JakCrane/FYP/Research_Files/October/current_feed_systems.md

deliverable for week 44



load cell to calculate feedrate which isnt possible in 0g
dont understand how exactly it works

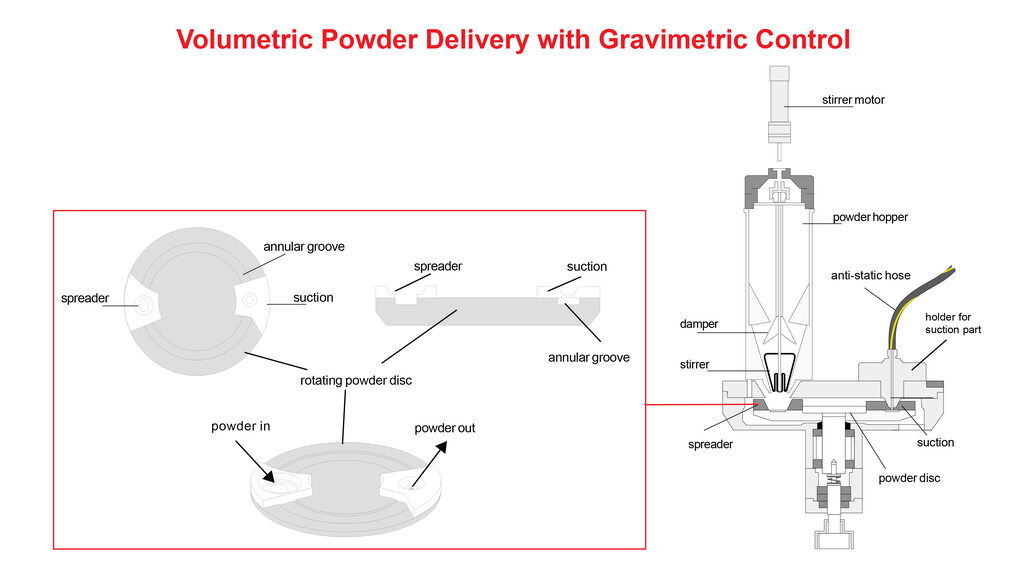
[picture p61: Research_Files/October/Volumetric_oerlikon.jpg]


requires gravity for the powder to sit in annular groove

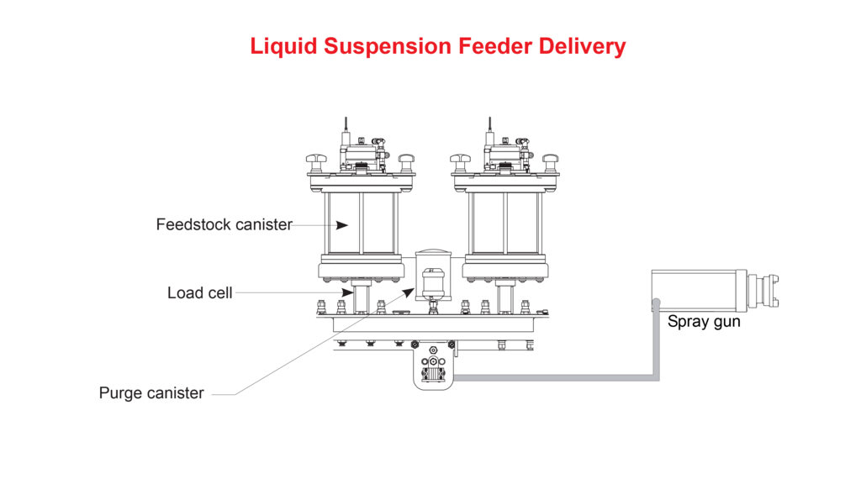
[picture p62: Research_Files/October/Liquid_oerlikon.jpg]


dont want to use liquid as it will increase mass to orbit



assuming smooth movement of piston then would work. need to check particle size and if it was ever used

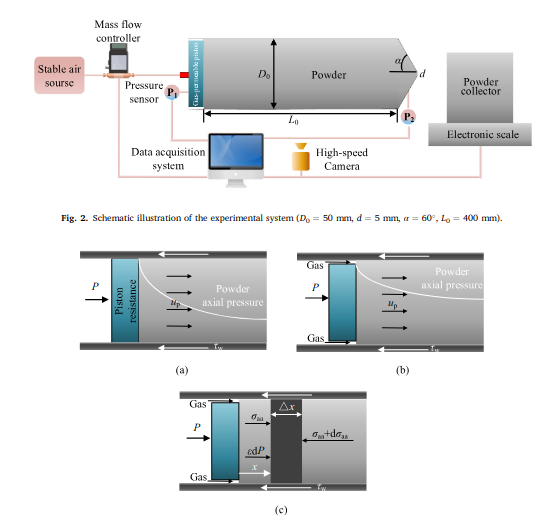
[picture p63: Research_Files/October/gas_permeable_piston.png]




would need some way to push the powder down but apparently is easy to control flow with control of speed of rotating screw



seems to be an intermediate between fluidised and screw/mechanical



generalised form of the oerlikon one



interesting concept but relies on gravity to work



more detailed
