JakCrane/FYP/latex/bin/main.tex

\documentclass[11pt,a4paper]{report}

\usepackage{titlesec}
\usepackage[utf8]{inputenc}
\usepackage{graphicx}
\usepackage{hyperref}
\usepackage{amsmath}
\usepackage{amsfonts}
\usepackage{amssymb}
\usepackage{geometry}
\usepackage{setspace}
\usepackage{subcaption}
\usepackage[font=footnotesize]{caption}
\usepackage{array}
\usepackage{listings}
\newcolumntype{P}[1]{>{\raggedright\arraybackslash}p{#1}}
\renewcommand{\theequation}{\arabic{equation}} % <--- Fix equation numbering!

\titlespacing*{\chapter}{0pt}{-30pt}{20pt} % Reduce space before chapter title
\titleformat{\chapter}[hang]
    {\normalfont\Huge\bfseries}
    {\thechapter\quad}
    {0pt}
    {}
    [\vspace{0ex}\noindent\rule{\textwidth}{0.4pt}] % Add line after chapter title

% Layout
\geometry{margin=1in}
\onehalfspacing{}
\begin{document}
\pagenumbering{roman} % Roman numerals for front matter
% Title Page
\begin{titlepage}

    \noindent
    \begin{minipage}{0.5\textwidth}
        
    \end{minipage}
    \hfill
    
    \vspace{1cm} % Space between logo and the title
    \begin{center}
        {\huge \textbf{Design and Optimisation of a Powder Feed System for In-Space Additive Manufacturing}}\\[1cm]
        
        \begin{minipage}{0.9\textwidth}
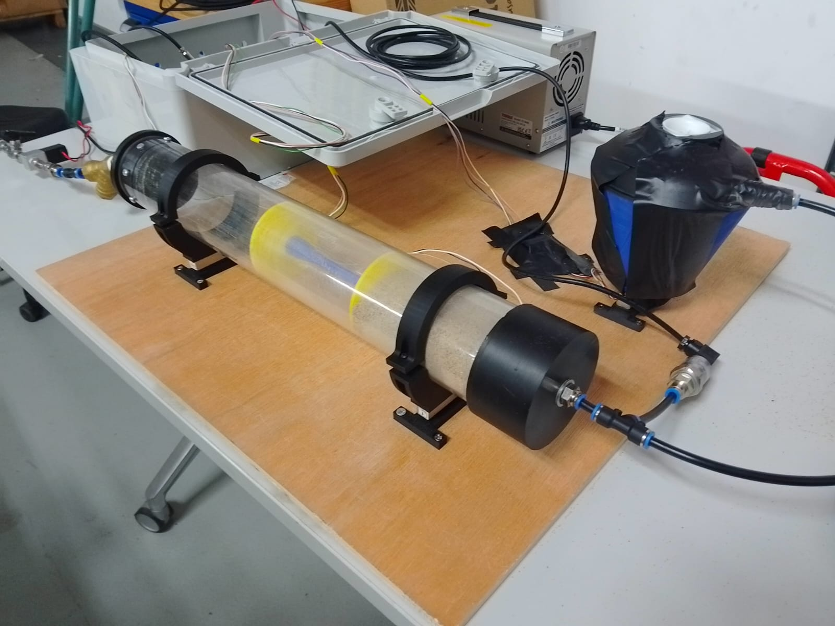
[picture p162: latex/report_assets/cover_image.png]
            
        \end{minipage}
        \hfill
        
        \vspace{0.3cm} % Space between logo and the title

        \begin{center}
            \renewcommand{\arraystretch}{1.5}
            \hfill\begin{tabular}{p{0.3\textwidth} p{0.6\textwidth}}
                \textbf{Author:}\hfill               & \textbf{Jack Crane} \\ 
                \textbf{Academic Supervisor:}\hfill  & Dr Ajit Panesar \\ 
                \textbf{Second Marker:}\hfill        & Dr Demetrios Venetsanos \\ 
                \textbf{Department:}\hfill           & Department of Aeronautics \\
                \textbf{Course:}\hfill               & MEng Aeronautics with Spacecraft Engineering \\
                \textbf{Academic Year:}\hfill        & 2024/2025 \\
                \textbf{Date:}\hfill                 & \today \\
            \end{tabular}
        \end{center}
        
        \vspace{0.5cm} % Space between logo and the title
        A Thesis submitted in fulfillment of requirements for the degree of \\
        Master of Engineering in Aeronautics with Spacecraft Engineering
    \end{center}
\end{titlepage}

% Abstract
\begin{abstract}
\input{../abstract.tex}
\end{abstract}

% Acknowledgments
\chapter*{Acknowledgments}
\input{../acknowledgments.tex}

% Table of Contents
\tableofcontents
\listoffigures
\listoftables

\newpage

\clearpage
\pagenumbering{arabic}

% Chapters
\chapter{Introduction and Context}
\input{../introduction.tex}

\chapter{Academic Background}
\input{../background.tex}

\chapter{Methodology}
\input{../methodology.tex}

\chapter{Results and Discussion}
\input{../results.tex}

\chapter{Conclusion and Future Work}
\input{../conclusion.tex}

% References
\newpage
\bibliographystyle{plain} % or use "unsrt" / "apalike" depending on your preference
\bibliography{../references} % assumes you have a references.bib BibTeX file

\appendix
\input{../appendix.tex}

\end{document}
