JakCrane/FYP/latex/report_assets/COSMOS MS2.pdf

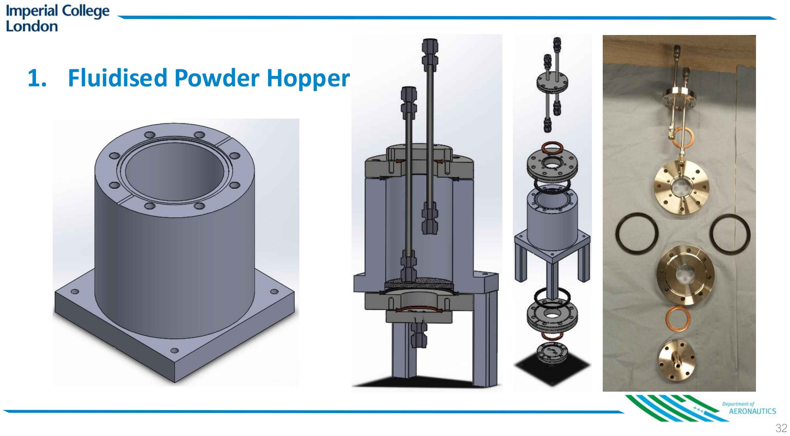
[picture p163: page 1]
