JakCrane/FYP/latex/report_assets/60mm_no_grav_2.png

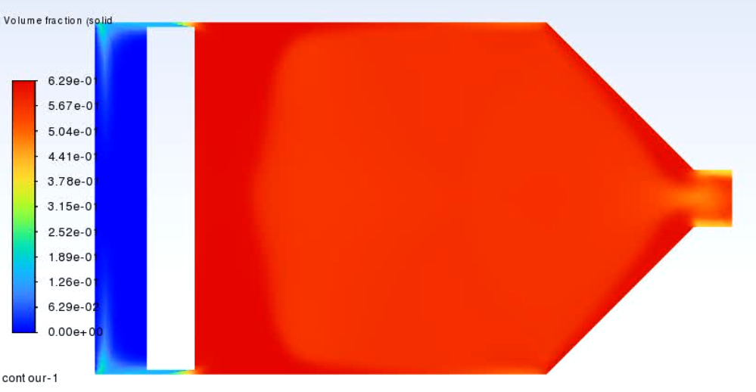
latex/report_assets/60mm_no_grav_2.png
