JakCrane/FYP/latex/report_assets/60mm_no_grav_3.png

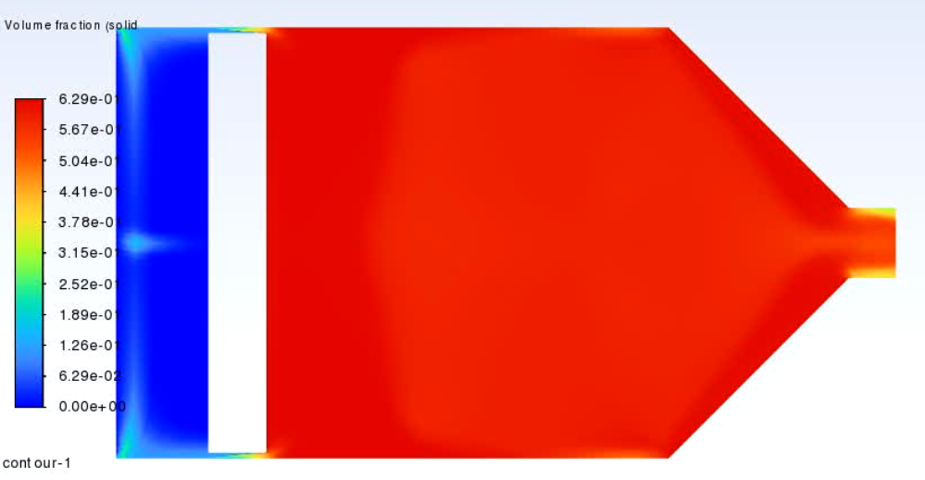
latex/report_assets/60mm_no_grav_3.png
