JakCrane/FYP/latex/report_assets/62_clean_flow_100.png

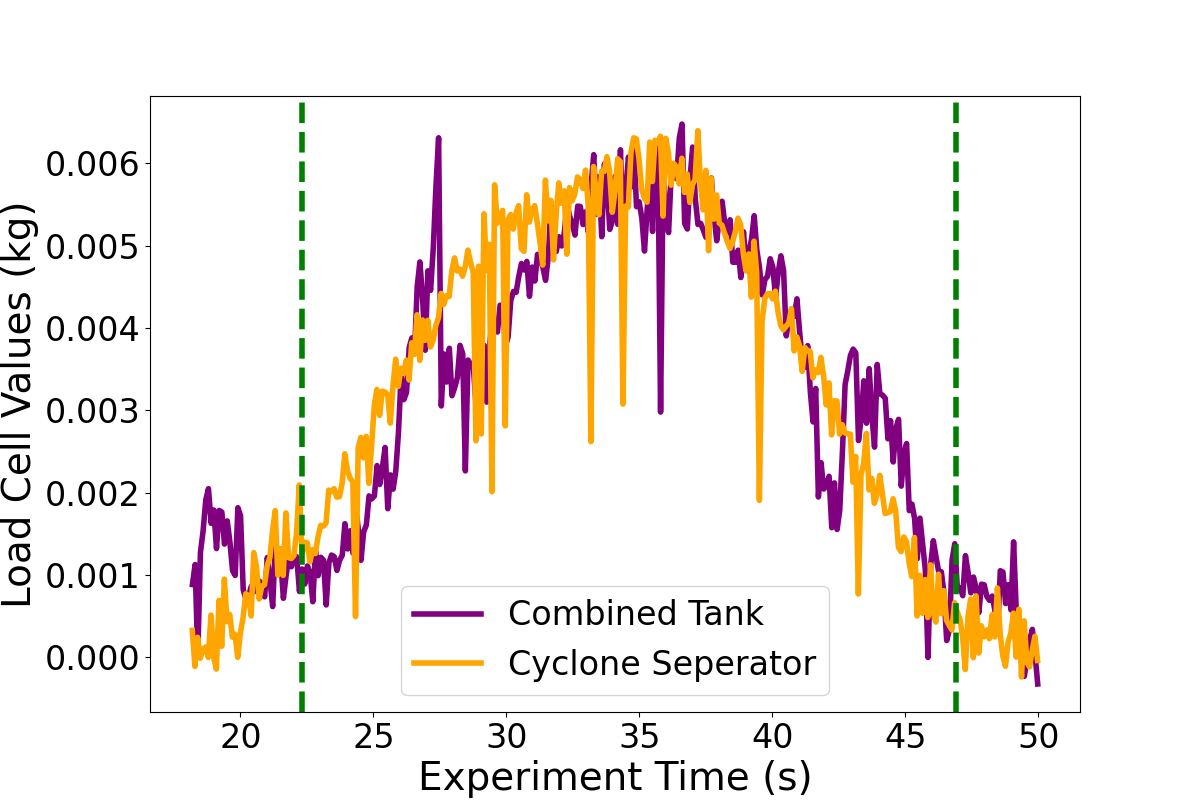
latex/report_assets/62_clean_flow_100.png
