JakCrane/FYP/latex/report_assets/62_clean_mass.png

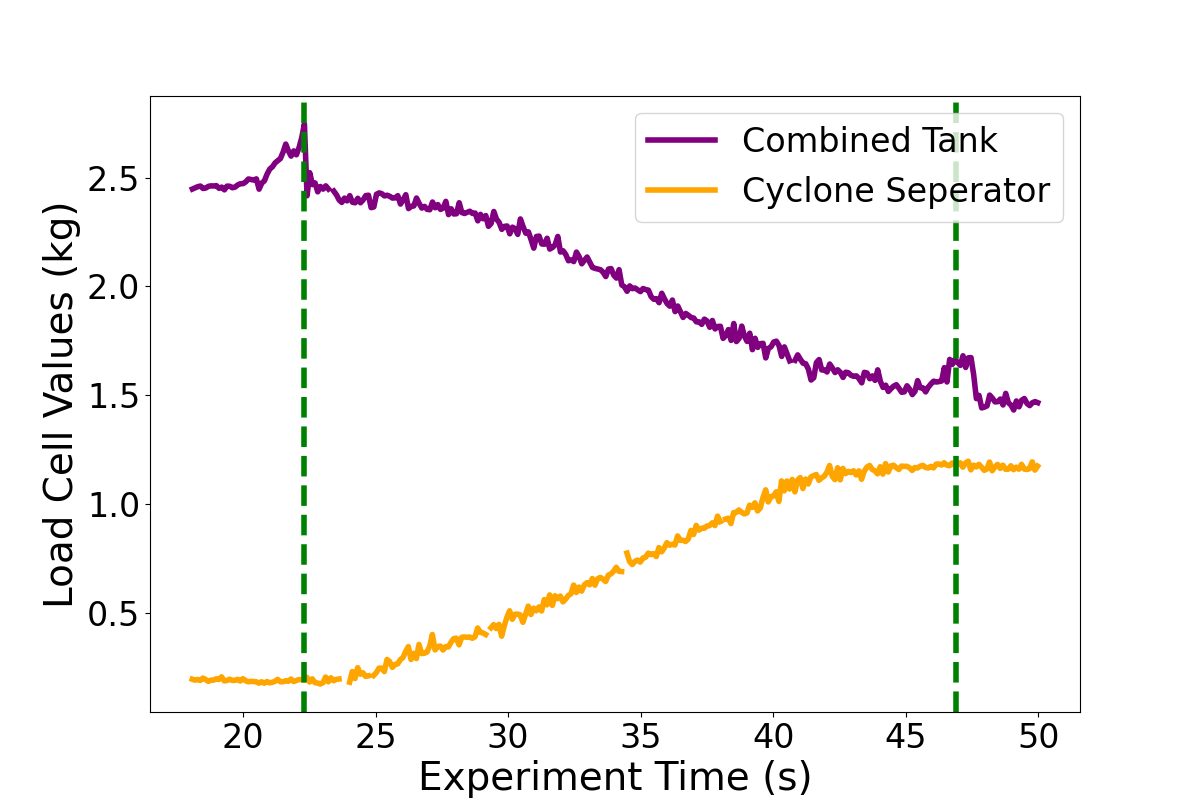
latex/report_assets/62_clean_mass.png
