JakCrane/FYP/latex/report_assets/62_raw_mass.png

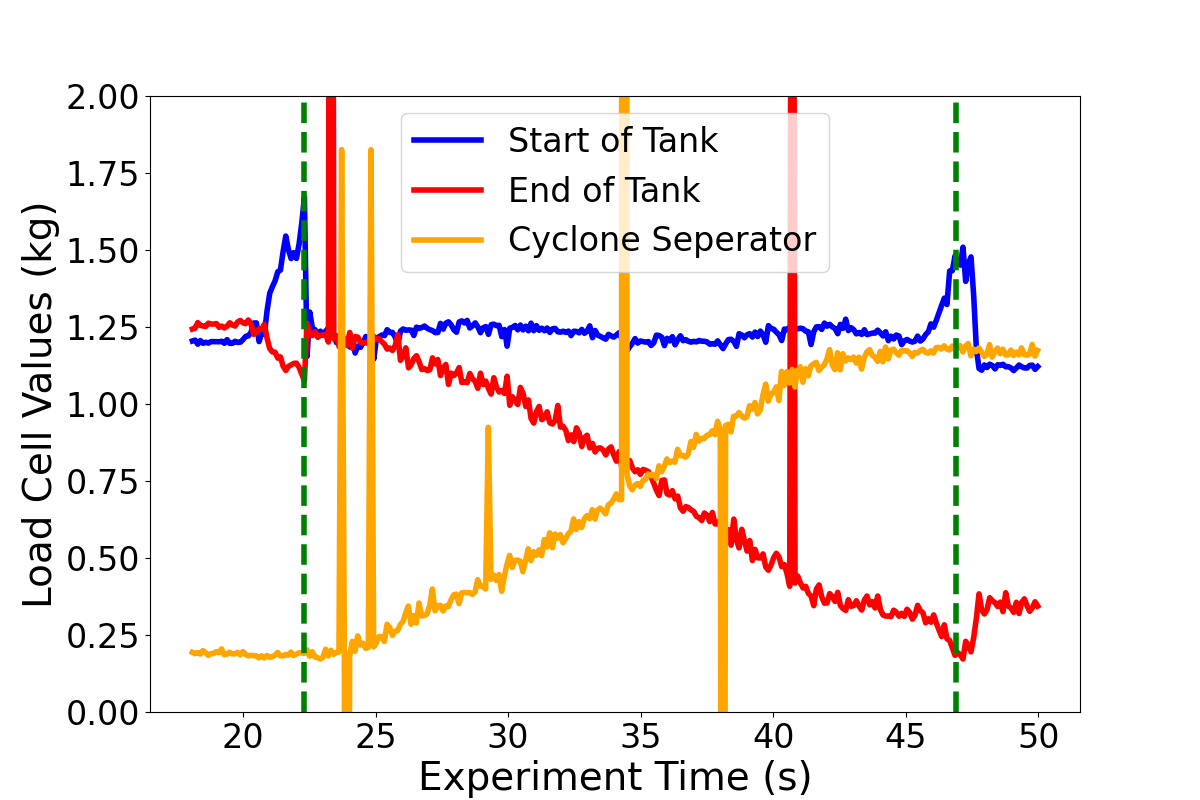
latex/report_assets/62_raw_mass.png
