JakCrane/FYP/latex/report_assets/controllability_py_raw.png

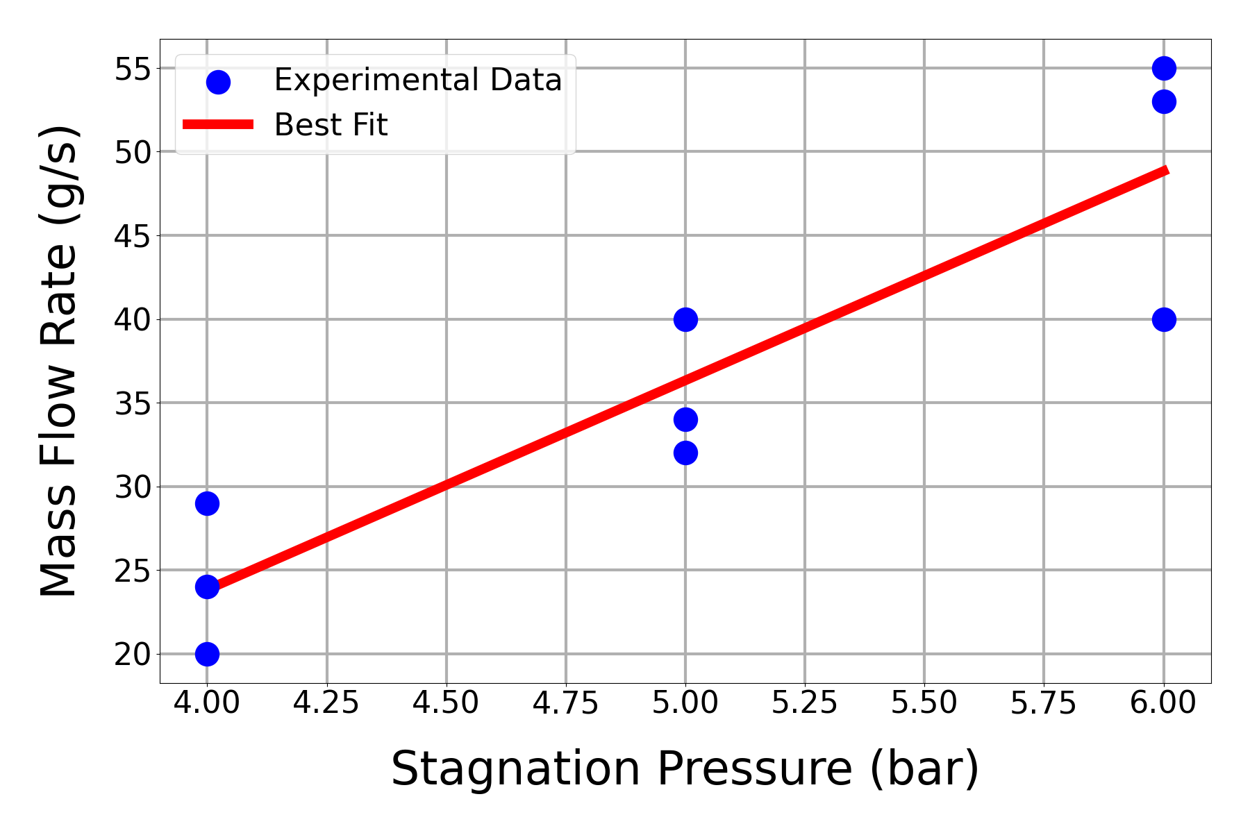
latex/report_assets/controllability_py_raw.png
