JakCrane/FYP/latex/report_assets/cs_impact.png

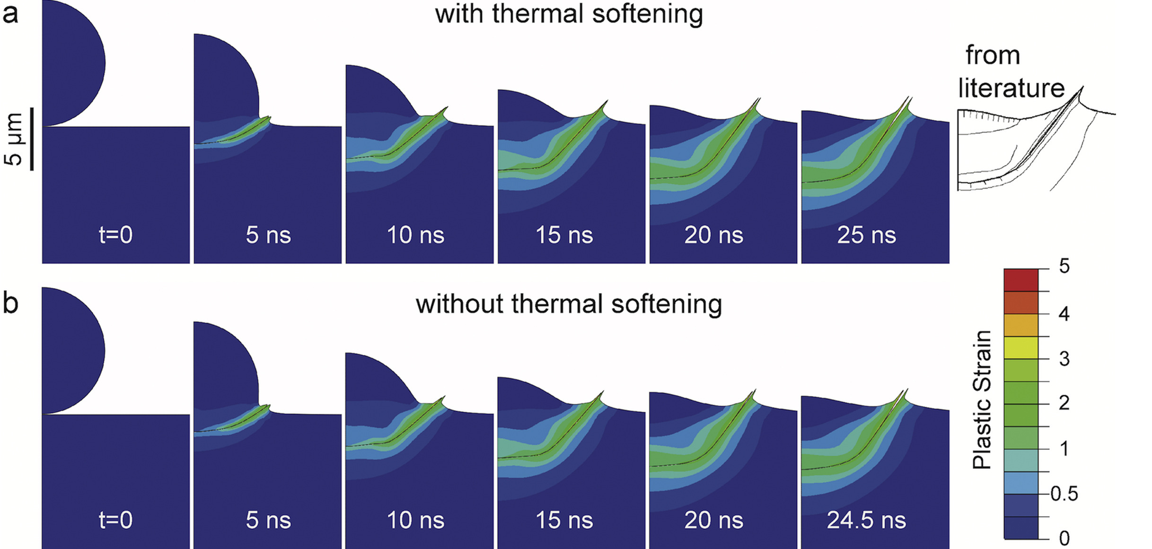
latex/report_assets/cs_impact.png
