JakCrane/FYP/latex/report_assets/cs_porosity.png

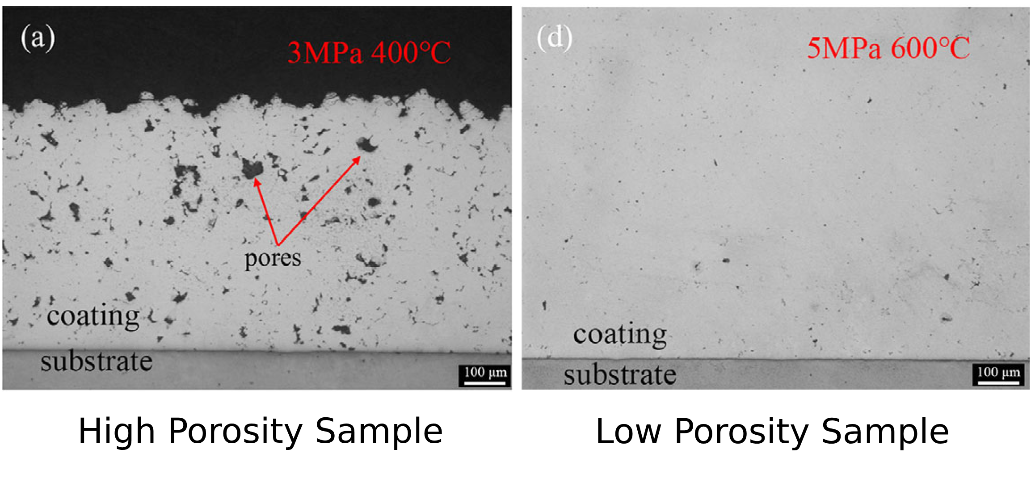
latex/report_assets/cs_porosity.png
