JakCrane/FYP/latex/report_assets/cyclone_diagram_wide.png

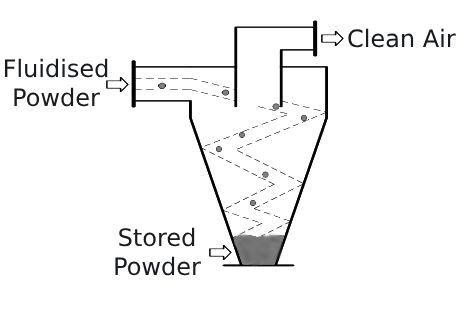
latex/report_assets/cyclone_diagram_wide.png
