JakCrane/FYP/latex/report_assets/des_evo_2.png

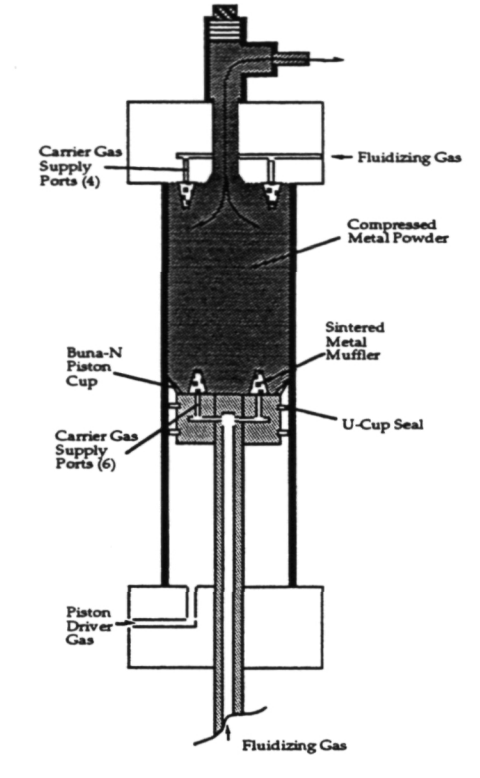
latex/report_assets/des_evo_2.png
