JakCrane/FYP/latex/report_assets/des_evo_4.png

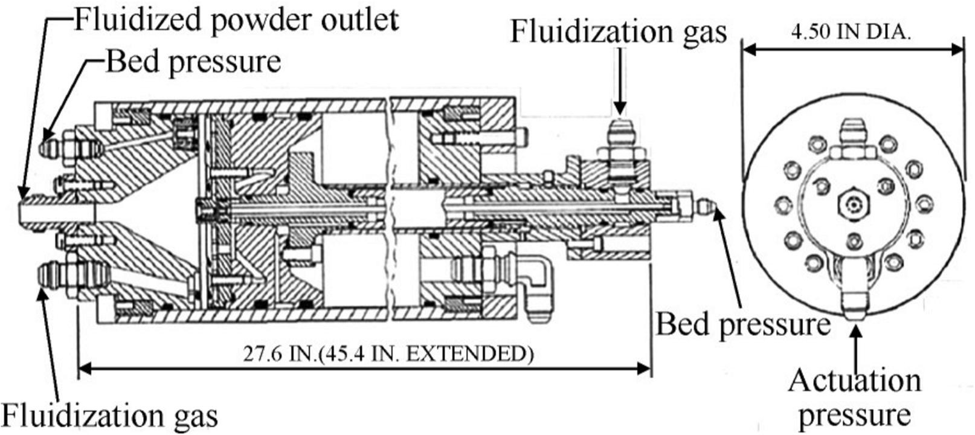
latex/report_assets/des_evo_4.png
