JakCrane/FYP/latex/report_assets/diaphragm_tank.png

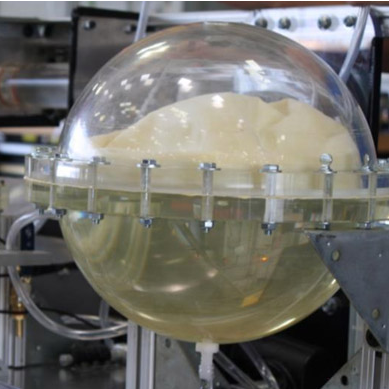
latex/report_assets/diaphragm_tank.png
