JakCrane/FYP/latex/report_assets/fluent_sucks.png

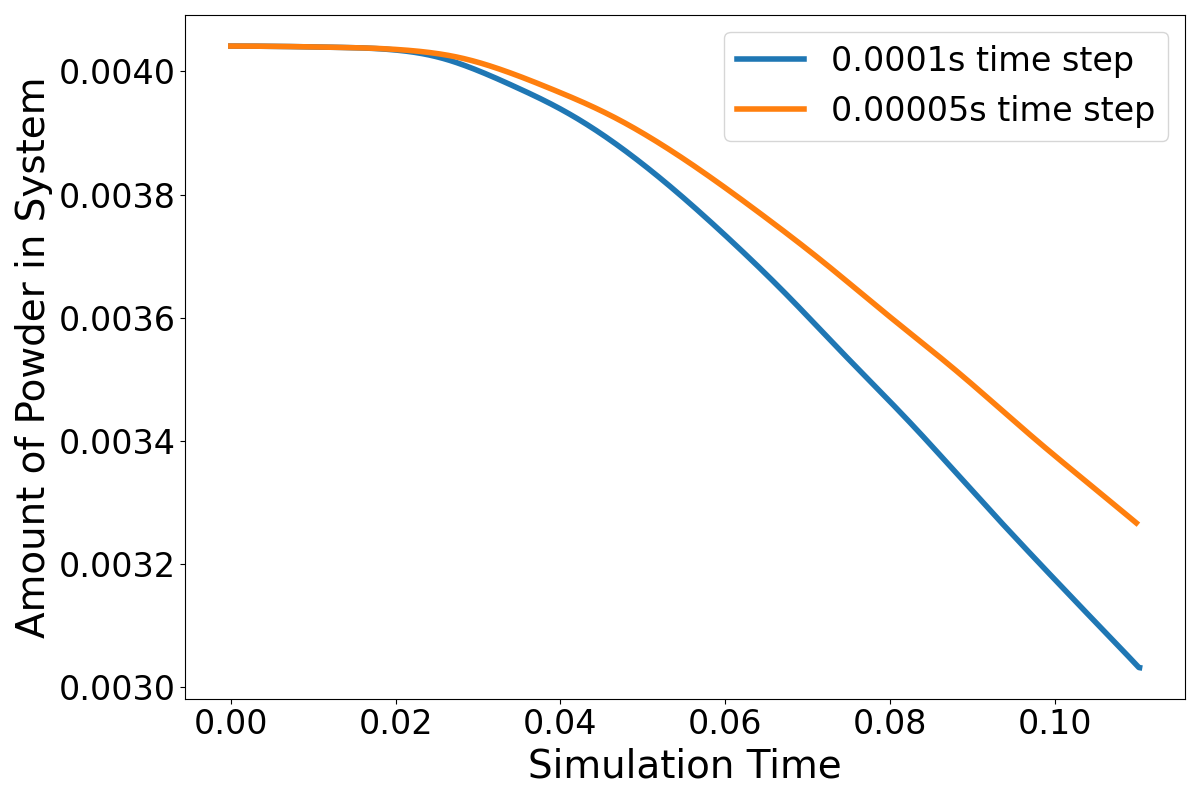
latex/report_assets/fluent_sucks.png
