JakCrane/FYP/latex/report_assets/Fluidised_Bed.jpg

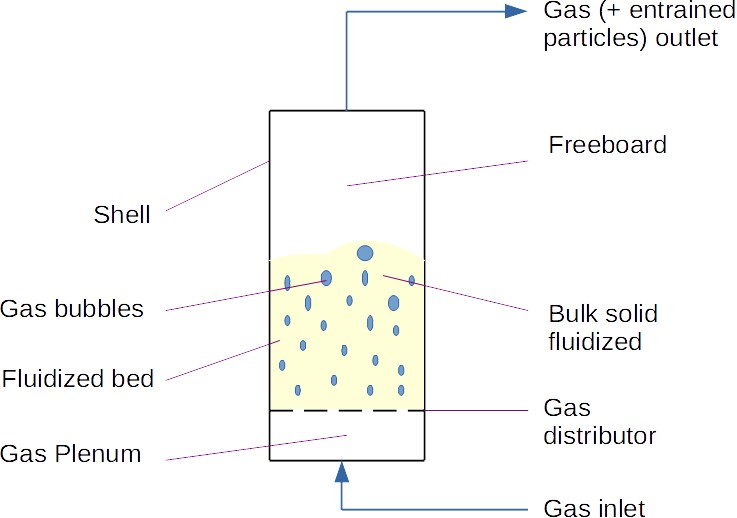
latex/report_assets/Fluidised_Bed.jpg
