JakCrane/FYP/latex/report_assets/Screenshot 2025-05-29 164737.png

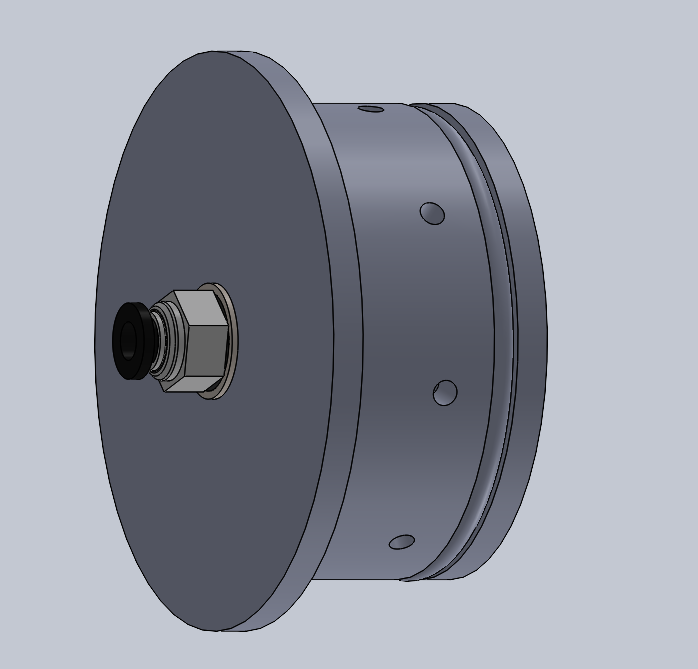
latex/report_assets/Screenshot 2025-05-29 164737.png
