JakCrane/FYP/latex/report_assets/Screenshot 2025-05-29 165220.png

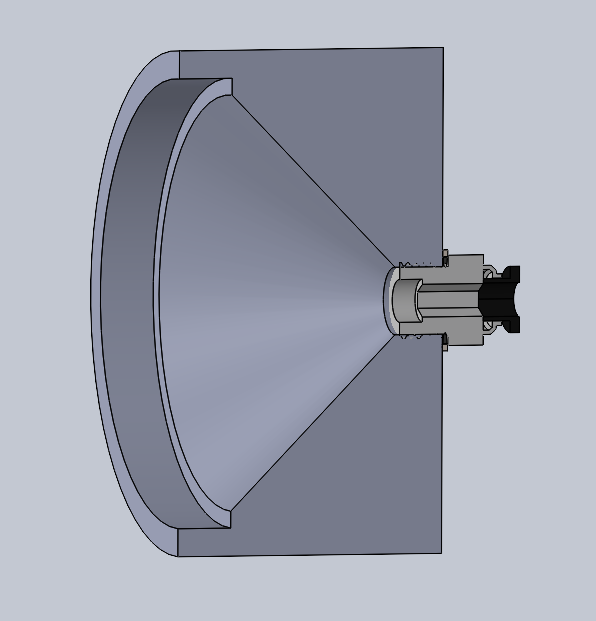
latex/report_assets/Screenshot 2025-05-29 165220.png
