JakCrane/FYP/latex/report_assets/systems_diagram.png

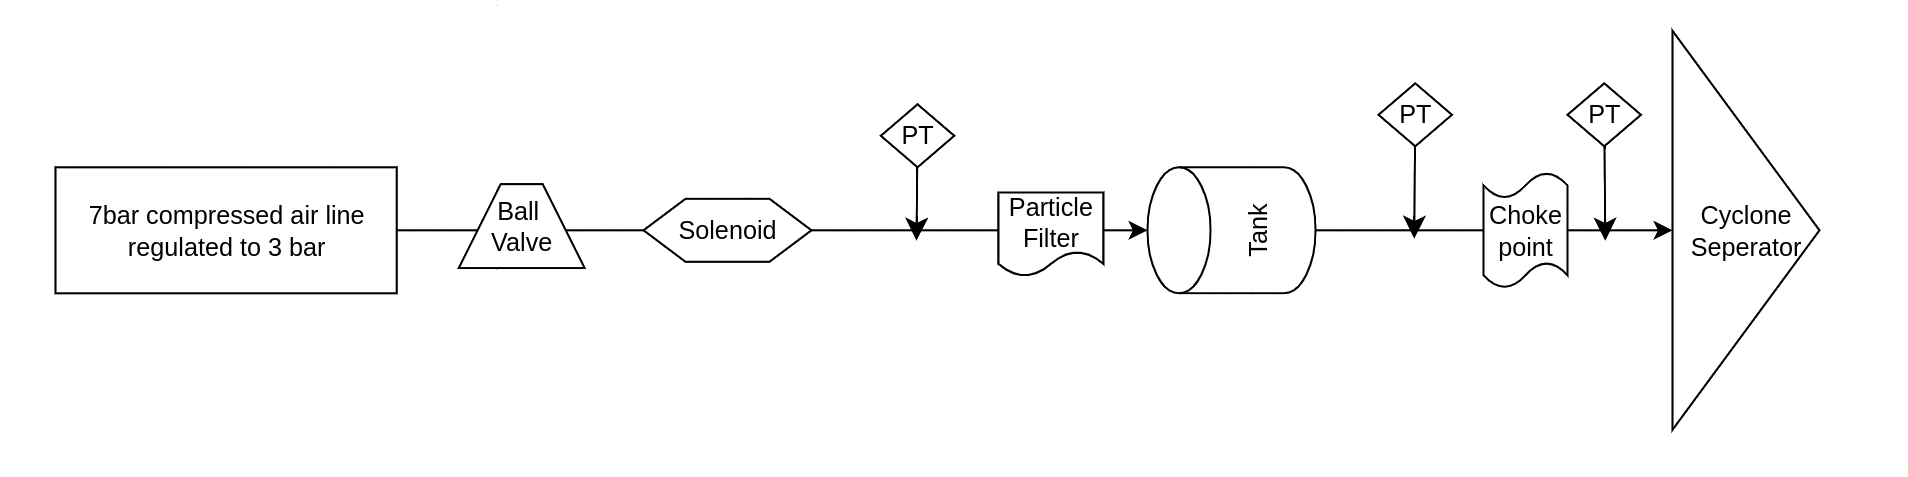
latex/report_assets/systems_diagram.png
