JakCrane/FYP/latex/report_assets/table_of_analysis_1.png

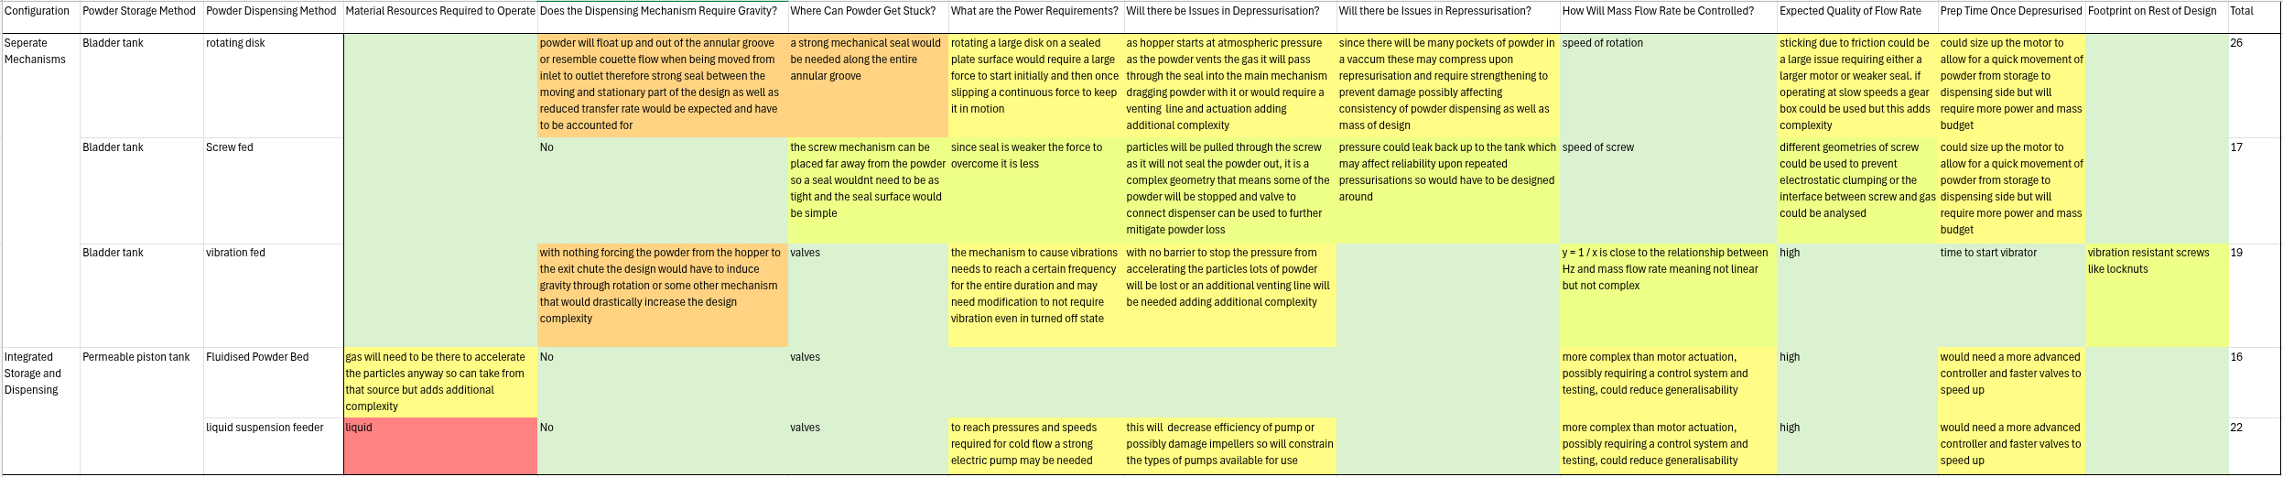
latex/report_assets/table_of_analysis_1.png
