JakCrane/FYP/Research_Files/April/16_holes_offset_3mm.png

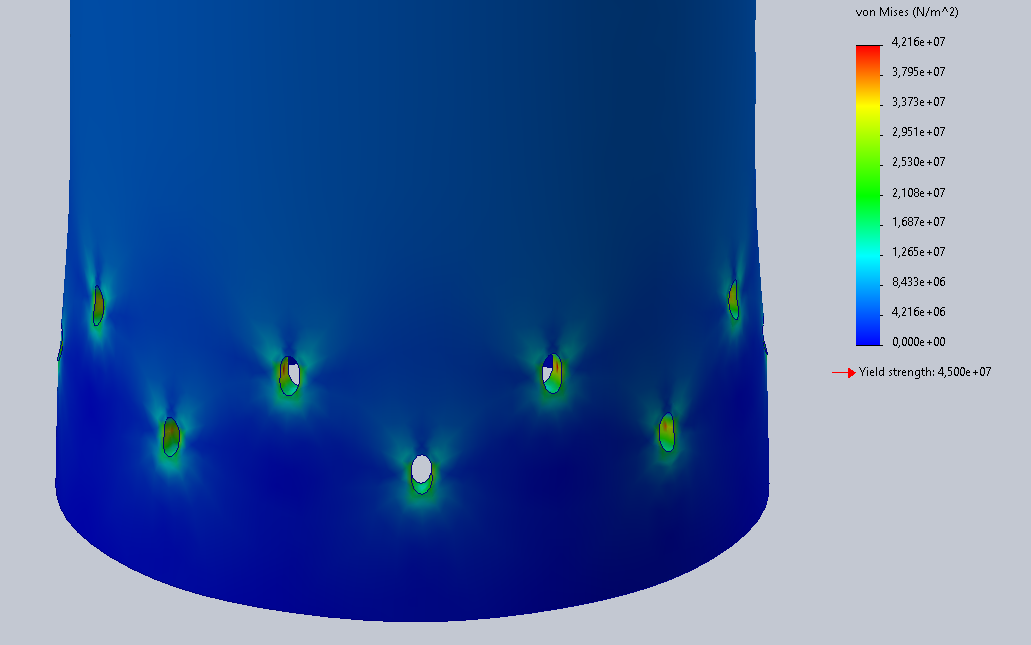
Research_Files/April/16_holes_offset_3mm.png
