JakCrane/FYP/Research_Files/February/20210629_205828.jpg

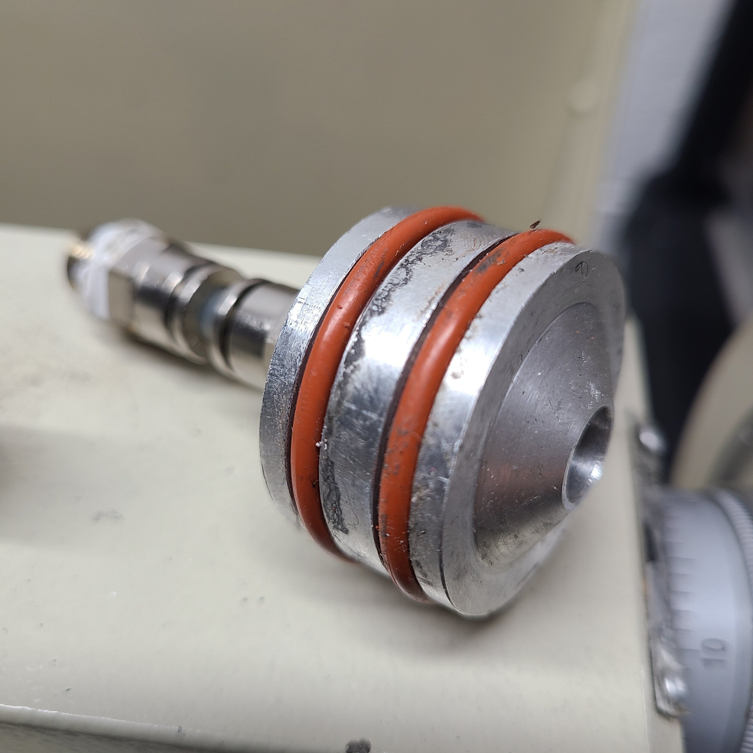
Research_Files/February/20210629_205828.jpg
