JakCrane/FYP/Research_Files/February/acrylic_tube_4mm_sim.png

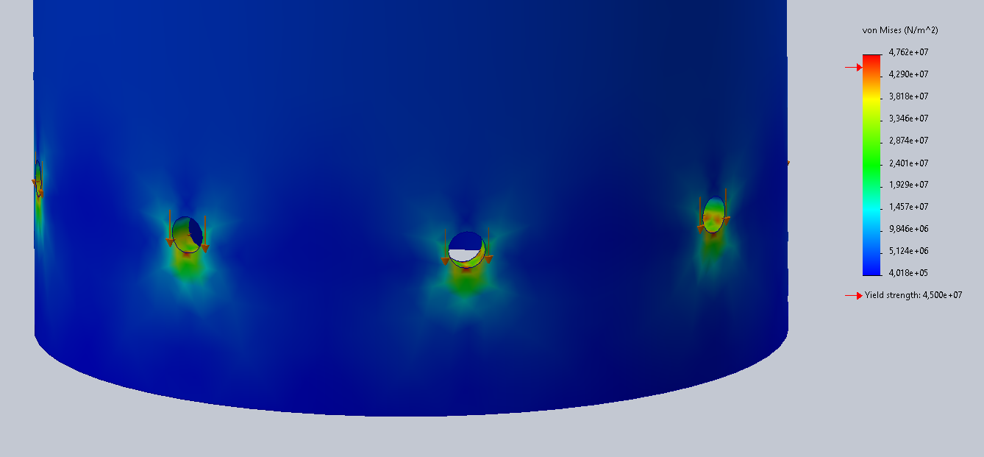
Research_Files/February/acrylic_tube_4mm_sim.png
