JakCrane/FYP/Research_Files/February/acrylic_tube_6mm_sim.png

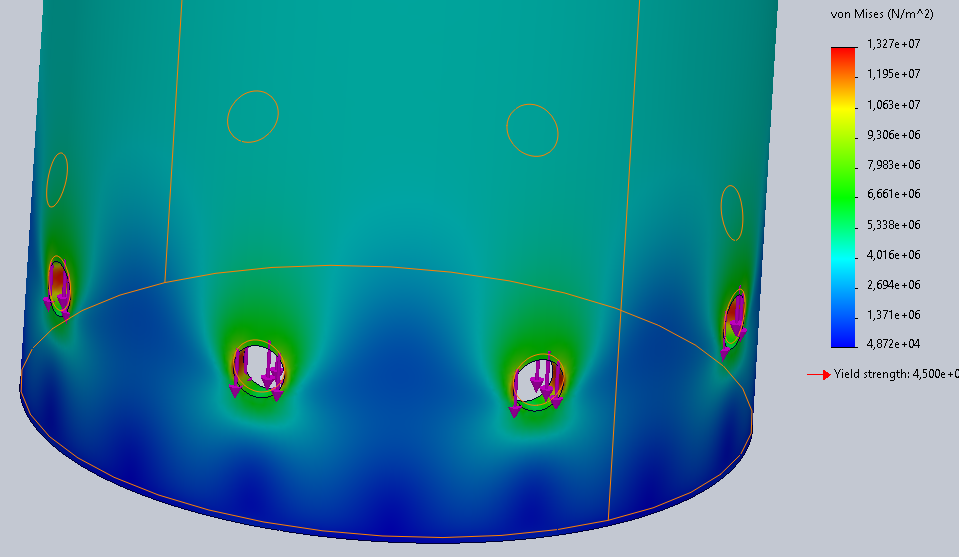
Research_Files/February/acrylic_tube_6mm_sim.png
