JakCrane/FYP/Research_Files/February/delrin_end_cap_sim.png

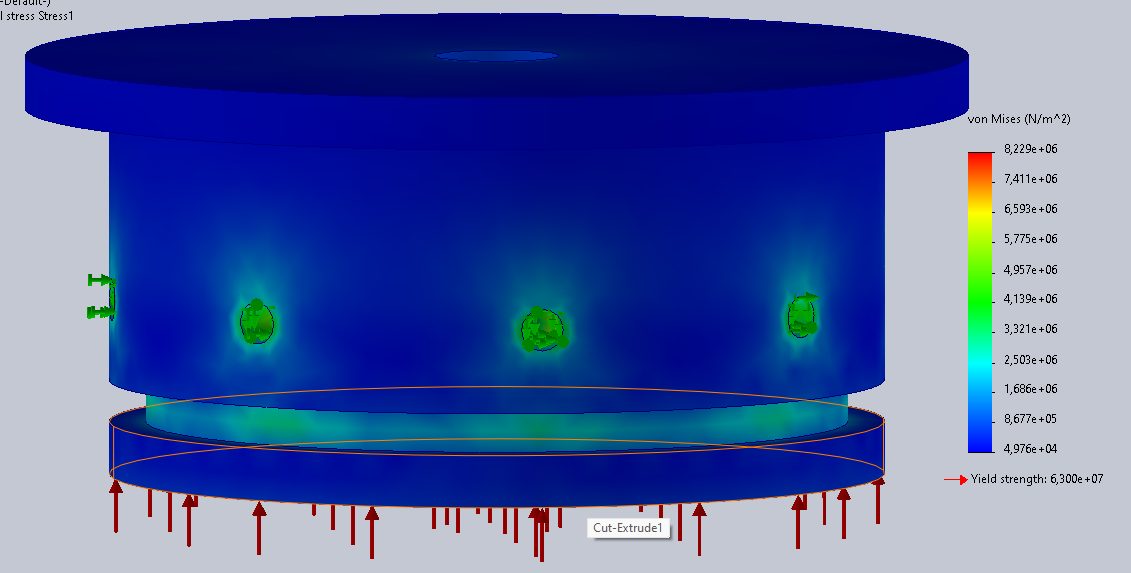
Research_Files/February/delrin_end_cap_sim.png
