JakCrane/FYP/Research_Files/February/tot_pres_5_to_4p8_bar.png

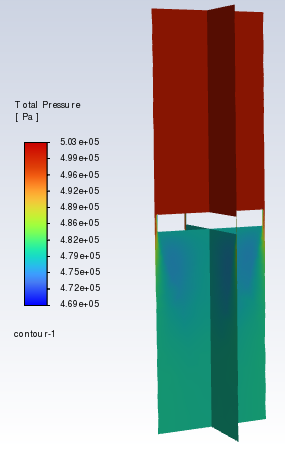
Research_Files/February/tot_pres_5_to_4p8_bar.png
