JakCrane/FYP/Research_Files/February/tot_pres_5_to_4p9_bar_1.png

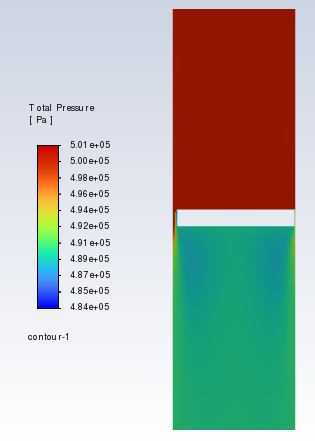
Research_Files/February/tot_pres_5_to_4p9_bar_1.png
