JakCrane/FYP/Research_Files/January/configuration_that_demands_pms.png

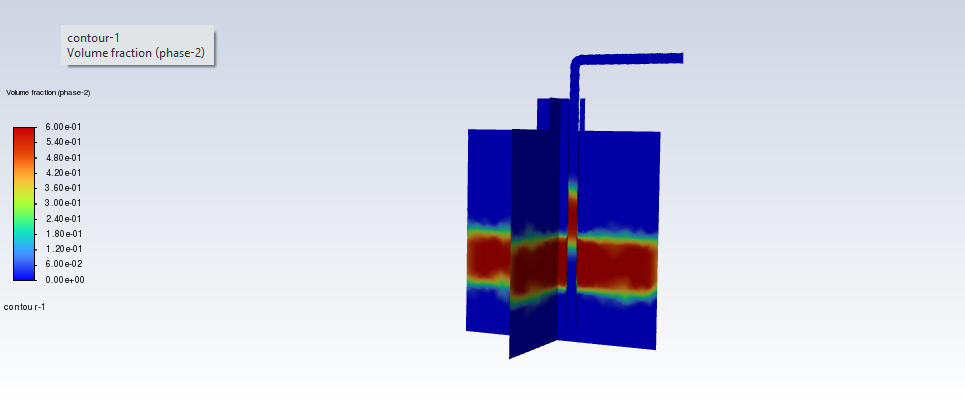
Research_Files/January/configuration_that_demands_pms.png
