JakCrane/FYP/Research_Files/March/1580247095994.gif

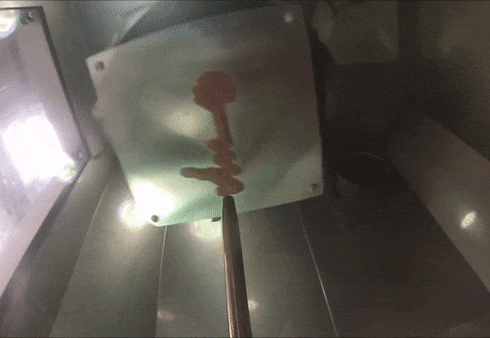
Research_Files/March/1580247095994.gif
