JakCrane/FYP/Research_Files/March/fea_on_acrylic.webp

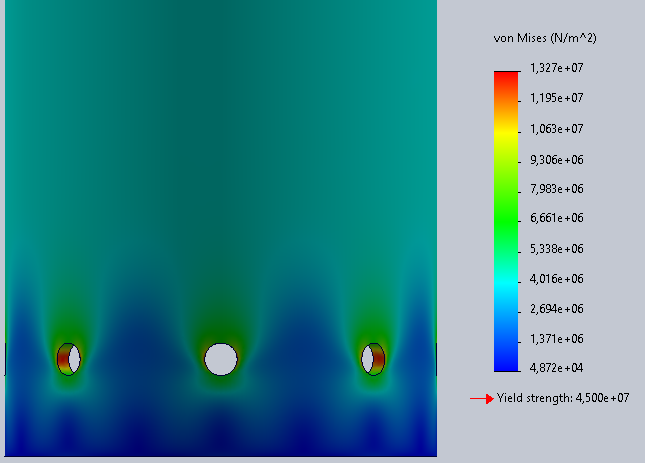
Research_Files/March/fea_on_acrylic.webp
