JakCrane/FYP/Research_Files/March/presentation_pandid.webp

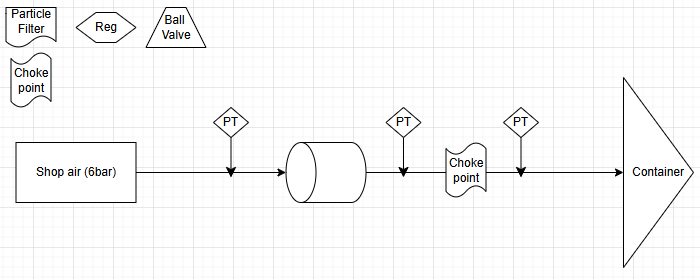
Research_Files/March/presentation_pandid.webp
