JakCrane/FYP/Research_Files/May/comparison_mass_change_vs_flow_time.png

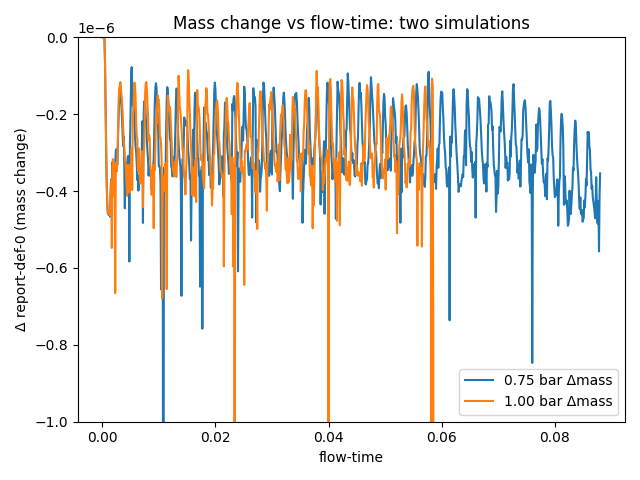
Research_Files/May/comparison_mass_change_vs_flow_time.png
