JakCrane/FYP/Research_Files/May/vel_profile_w_3bar_inlet.png

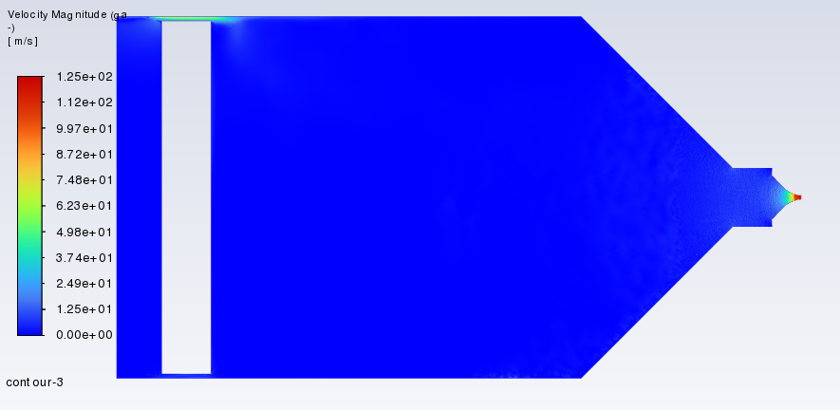
Research_Files/May/vel_profile_w_3bar_inlet.png
