JakCrane/FYP/Research_Files/November/Starccm_images/Capture4.PNG

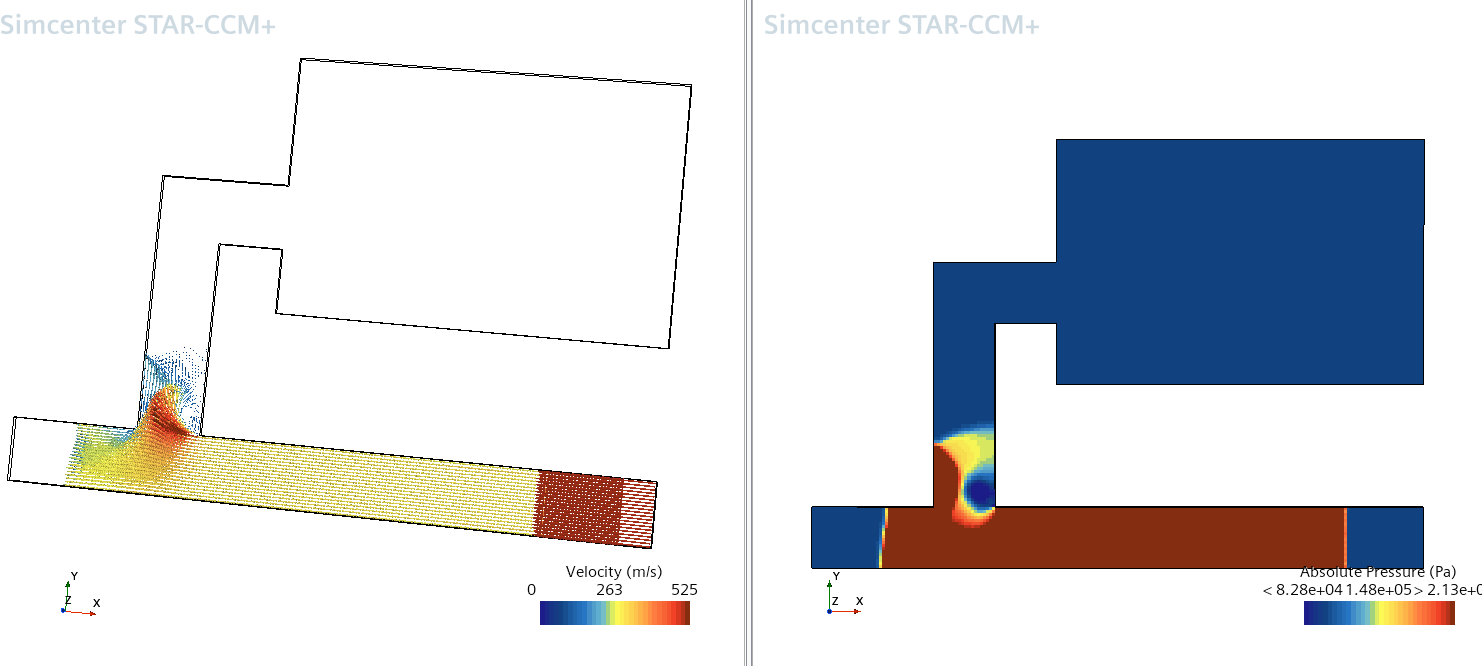
Research_Files/November/Starccm_images/Capture4.PNG
