JakCrane/FYP/Research_Files/November/Starccm_images/Capture7.PNG

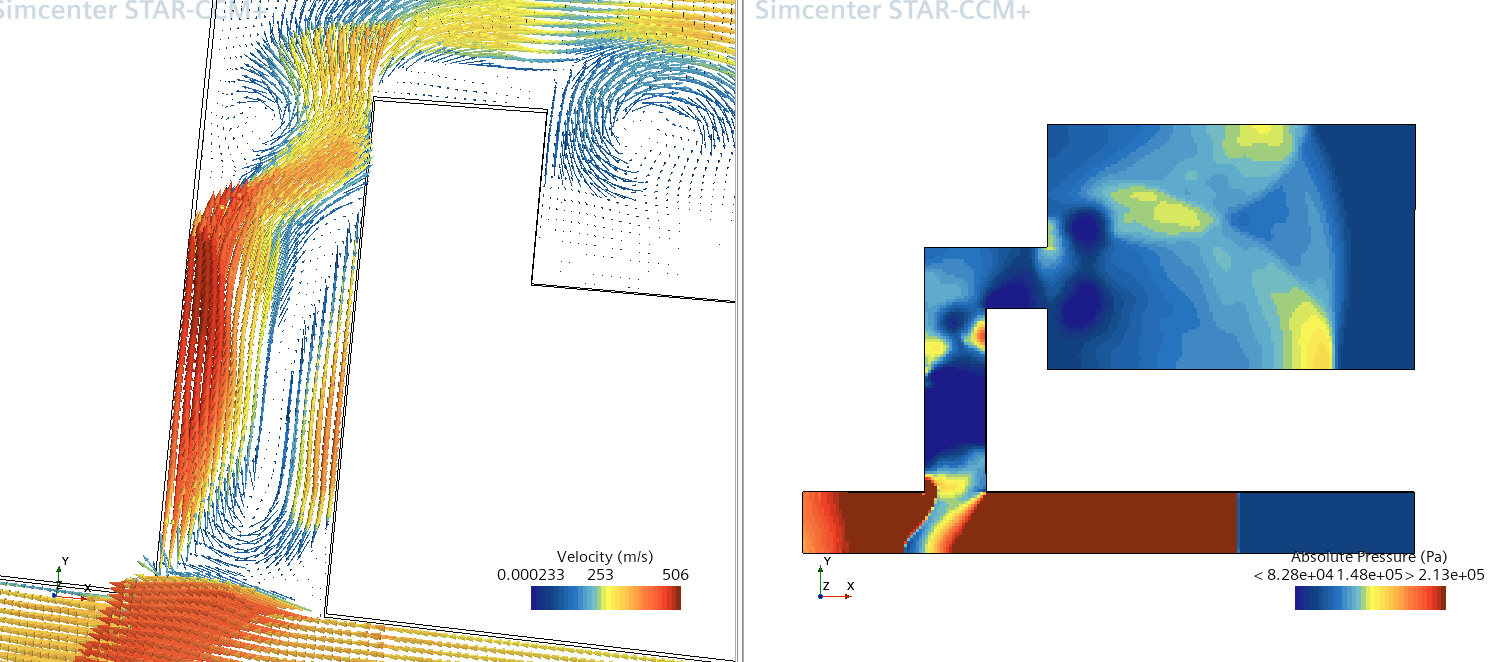
Research_Files/November/Starccm_images/Capture7.PNG
