JakCrane/FYP/Research_Files/November/Starccm_images/Capture8.PNG

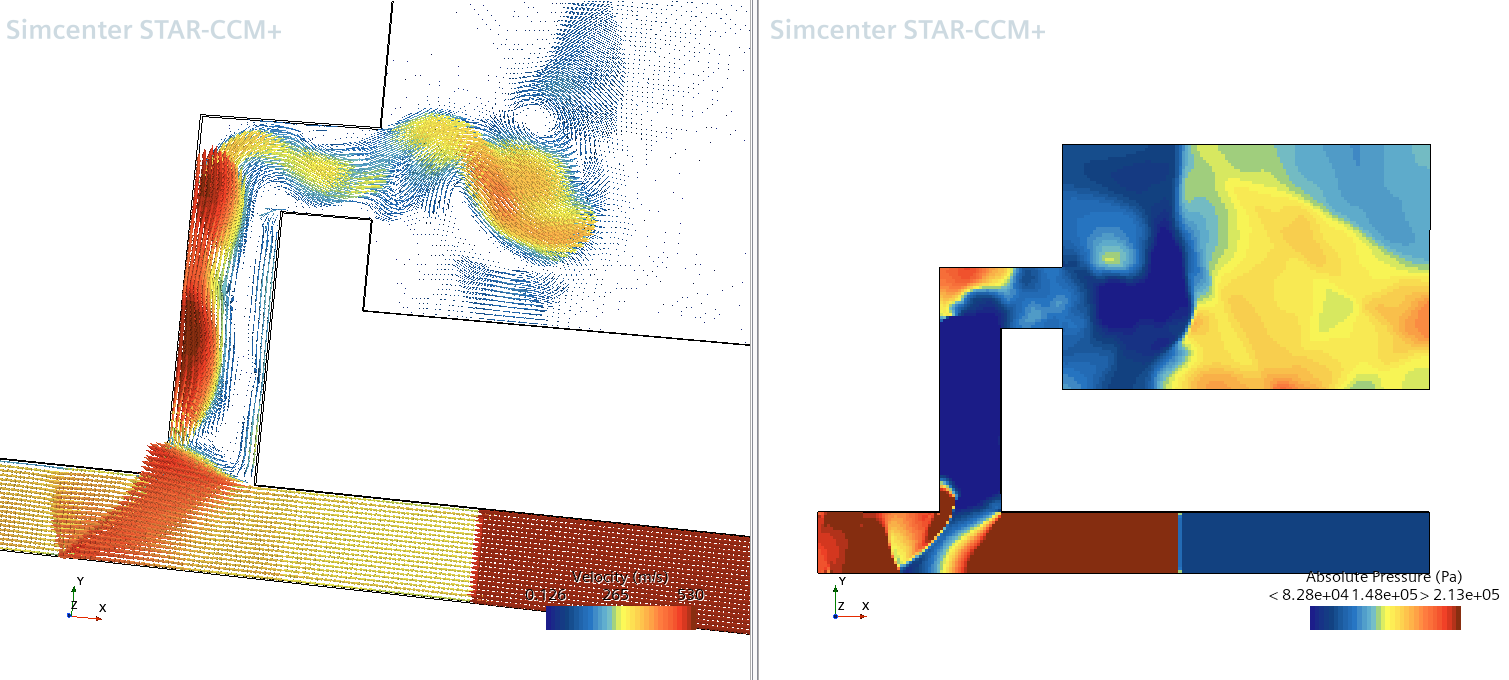
Research_Files/November/Starccm_images/Capture8.PNG
