JakCrane/FYP/Research_Files/November/Starccm_images/Capture9.PNG

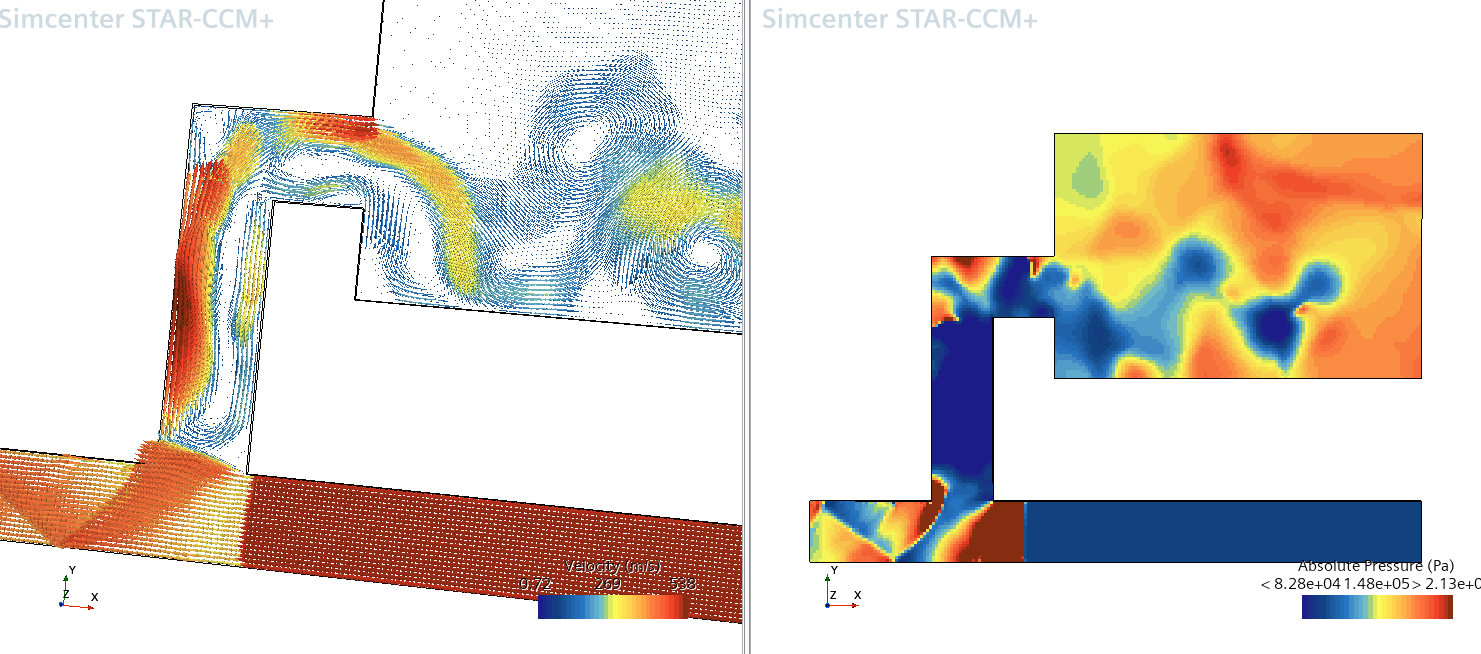
Research_Files/November/Starccm_images/Capture9.PNG
