JakCrane/FYP/Research_Files/November/Starccm_images/Capture10.PNG

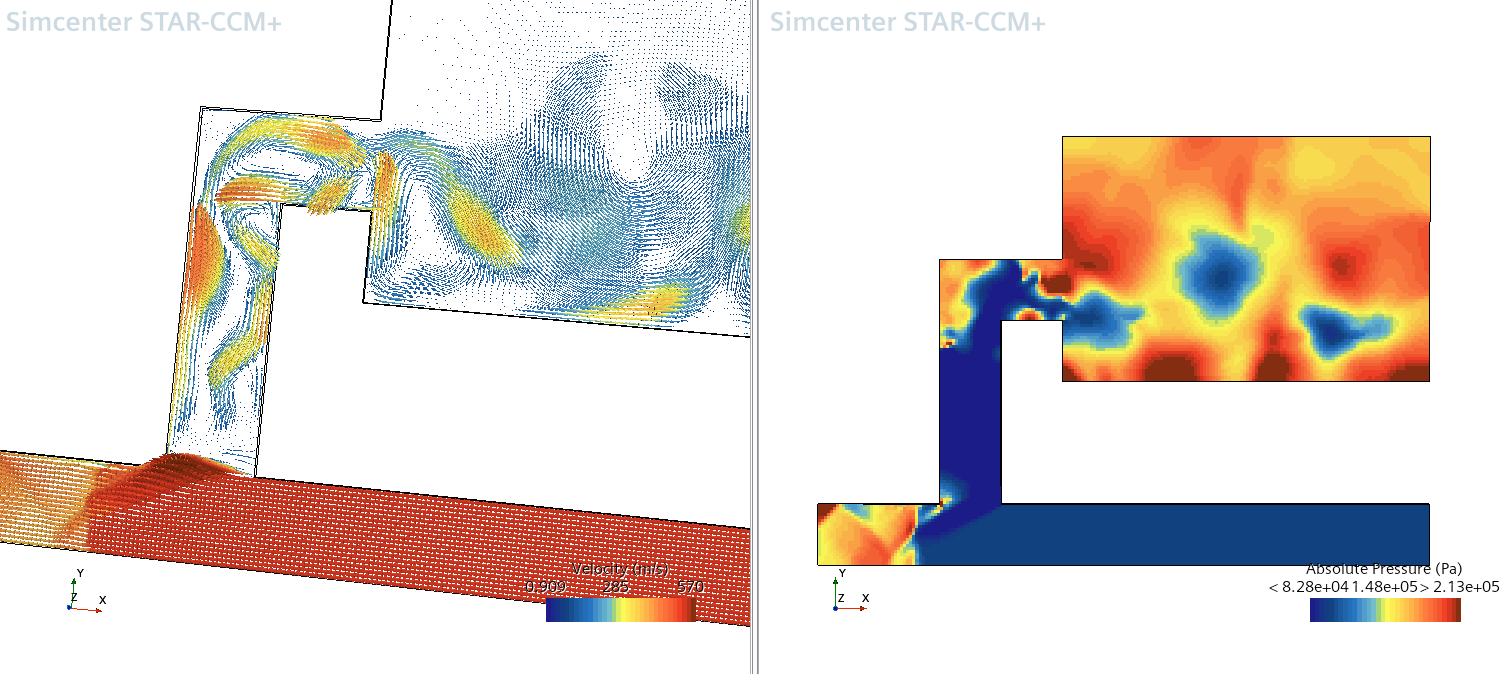
Research_Files/November/Starccm_images/Capture10.PNG
