JakCrane/FYP/Research_Files/November/Starccm_images/steady_state1.PNG

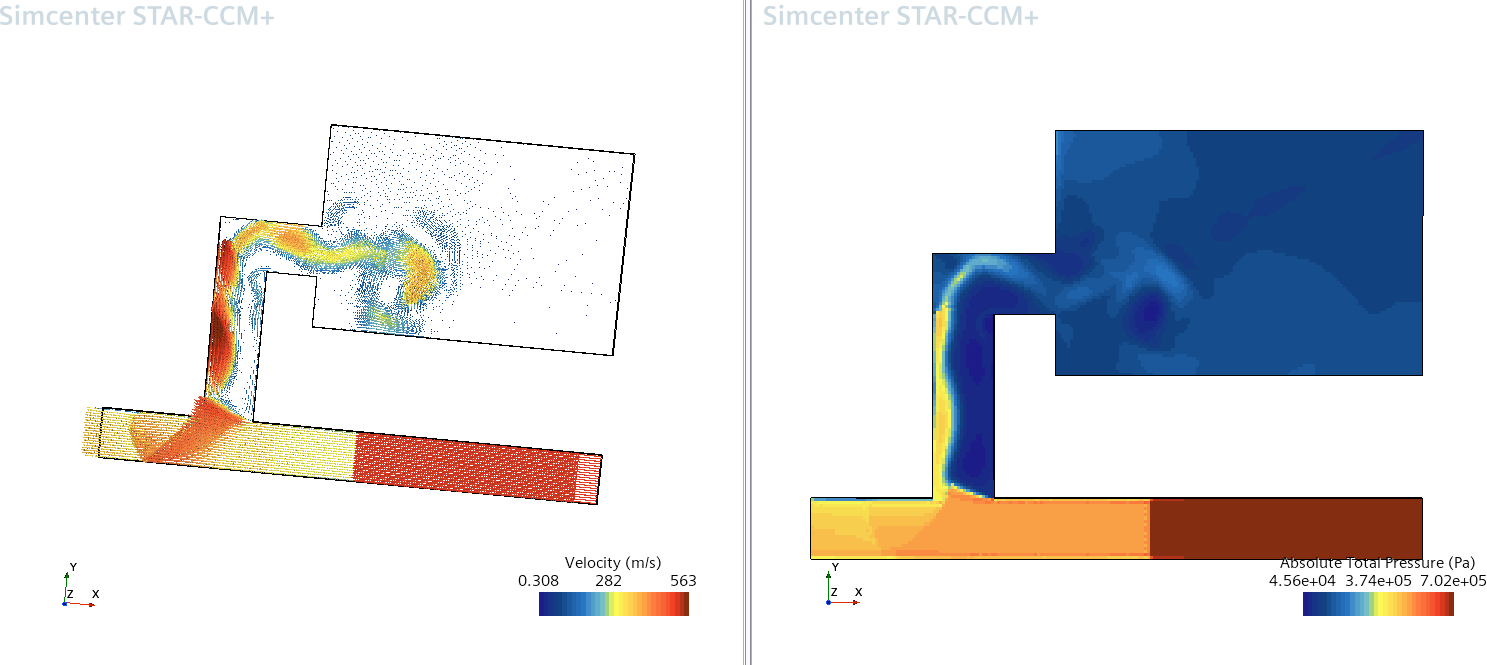
Research_Files/November/Starccm_images/steady_state1.PNG
