JakCrane/FYP/Research_Files/November/Starccm_images/steady_state2.PNG

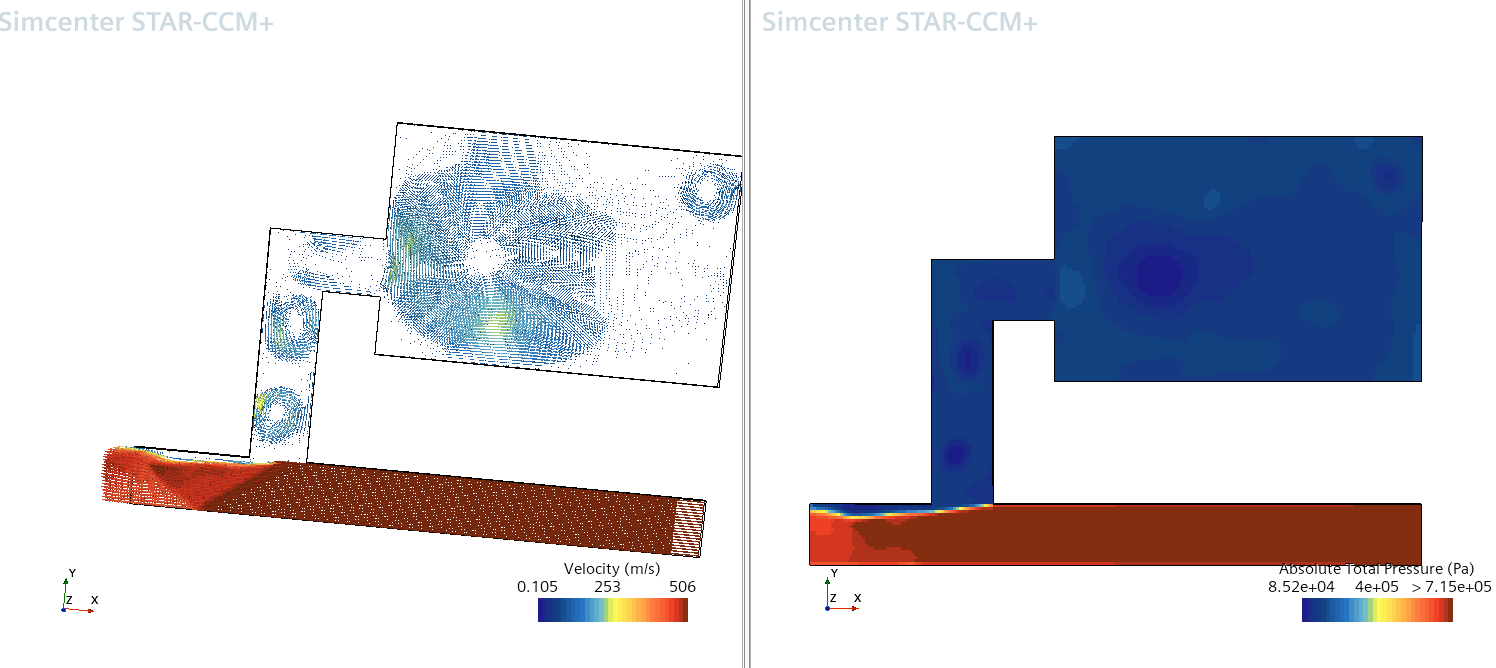
Research_Files/November/Starccm_images/steady_state2.PNG
