JakCrane/FYP/Research_Files/November/Starccm_images/steady_state3.PNG

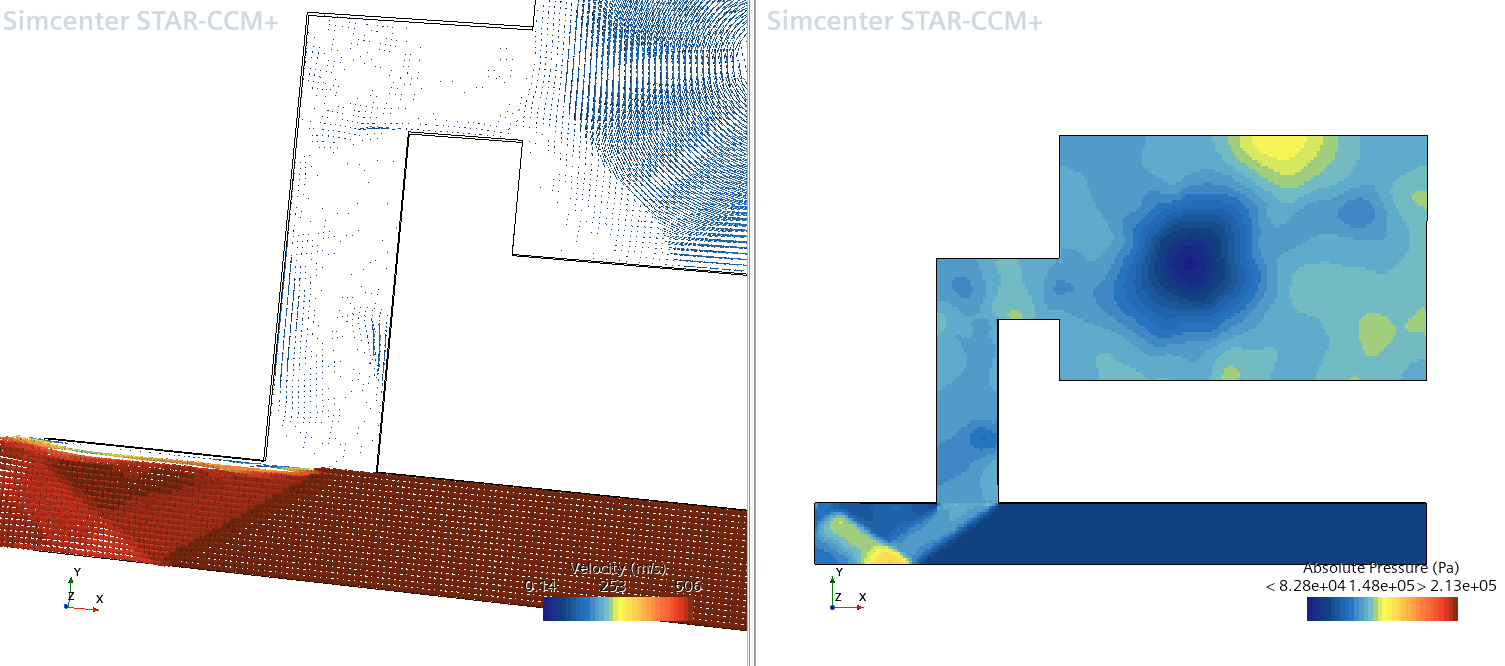
Research_Files/November/Starccm_images/steady_state3.PNG
