JakCrane/FYP/Research_Files/February/Prototype_BOM.xlsx

Name | Link | Number | Cost | Modelled as | Force experienced | Order status
500mmx80mm acrylic tubing | https://www.ebay.co.uk/itm/166173980495?_skw=500mm+acrylic+tube&itmmeta=01JKXV09S24BYWGYRMQGF6NTCW | 1 | 15.75 | "Acrylic (Medium-High impact)" | 3kn | Arrived
100mmx90mm delrin | https://www.ebay.co.uk/itm/133562315642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 | 1 | 29.03 |  |  | Arrived
Epoxy |  | 1 | 0.00
O-ring 67mmx4mm | https://www.ebay.co.uk/itm/133642177854?_skw=o+ring+74mm&itmmeta=01JM0JBK0S94QJNKCFFN7T27F5 | 1 pack (5pcs) | 3.64 |  |  | Arrived
4mm threaded inserts |  | 8 | 0.00 |  |  | Workshop
6mm pushfit to 1/4 bspp female | https://www.ebay.co.uk/itm/253419938462?_skw=bspp+1%2F4+push+fit&itmmeta=01JMQF8JSD72SJ4C5A6AREMH8D | 3 | 10.80 |  |  | Arrived
6mm pushfit to 1/4 bspp male | https://www.ebay.co.uk/itm/253419938462?_skw=bspp+1%2F4+push+fit&itmmeta=01JMQF8JSD72SJ4C5A6AREMH8D | 4 | 11.20 |  |  | Arrived
6mm pushfit to 6mm pushfit | https://www.ebay.co.uk/itm/253419938462?_skw=bspp+1%2F4+push+fit&itmmeta=01JMQF8JSD72SJ4C5A6AREMH8D | 1 | 2.50 |  |  | Arrived
6mm tee connector | https://www.ebay.co.uk/itm/253419938462?_skw=bspp+1%2F4+push+fit&itmmeta=01JMQF8JSD72SJ4C5A6AREMH8D | 3 | 9.00 |  |  | Arrived
Nylon pipe | https://www.ebay.co.uk/itm/405185558343?_skw=6mm+nylon+tube&itmmeta=01JMQFNEKN341FBZHSVH1QRCZ6 2FiMlkCve19UV4JkpnolDoiaXV1hlX%2F1zcS%2BYrbeoUxDpdFi1IptoivBmADKfMQGo7DTlw%2FDtERZ%2FH2GqIZRS8hjLcF29n5X%2BSb2hu1eHsmJ1eZZqe%2BfT1LvsdDQePZJPOzWbuW2iRbmc%2Faf0UmHsGu2Si3paJFf3tgmP0zoZ04j0zZXgvkt6CHnw%2F7tz7cAv0fVswK%2F4GxzXKBTcw%3D%3D%7Ctkp%3ABFBM-unV76Vl&var=675281332461 | 2m | 5.55 |  |  | Arrived
Plastic compatable epoxy | https://www.amazon.co.uk/dp/B009NQQJFC?ref_=ppx_hzod_title_dt_b_fed_asin_title_0_0&th=1 | 1 | 5.80 |  |  | Arrived
0-16 bar PT | https://www.ebay.co.uk/itm/387829528676 | 2 | 31.92 |  |  | Ordered
10kg loadcell | https://www.amazon.co.uk/dp/B0D9NZHKLD?ref=ppx_yo2ov_dt_b_fed_asin_title | 2 | 8.29 |  |  | Arrived
Sand (5kg) | https://www.amazon.co.uk/dp/B002YJS2YG?ref_=ppx_hzod_title_dt_b_fed_asin_title_0_0 | 1 | 6.98 |  |  | Arrived
 |  |  | 140.46
