JakCrane/FYP/Research_Files/March/CAD_Fluent_prototype/Prototype_for_sim_Assembly.STEP

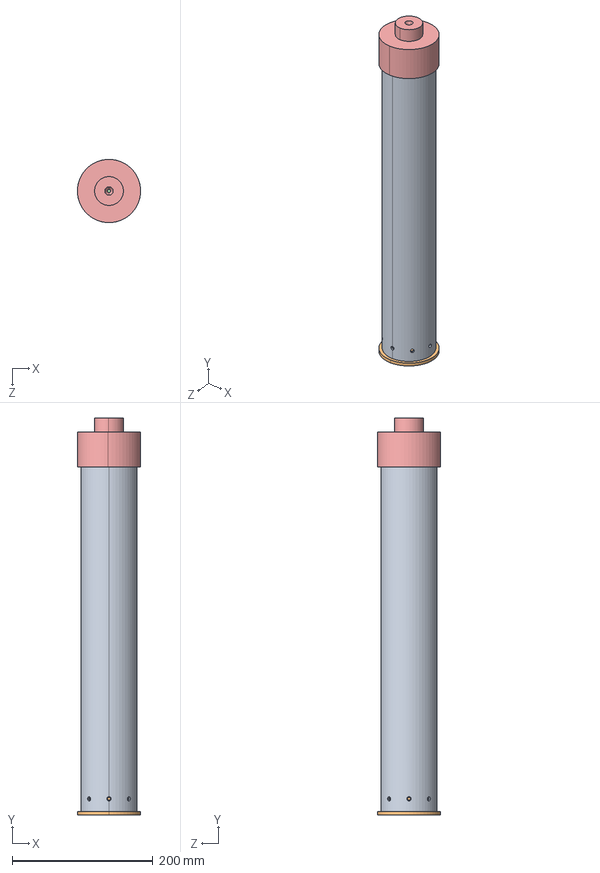
[picture p204: CAD file, 2025-04-27]
Research_Files/March/CAD_Fluent_prototype/Prototype_for_sim_Assembly.STEP
90.0 x 565.0 x 90.0 mm
Acrylic_tube
Delrin_End_Cap
O_ring
Hopper_Gear_Plunger
chokepoint_funnel_combo
