JakCrane/FYP/Research_Files/December/CAD_Files/Hopper_Tank_Assembly.STEP

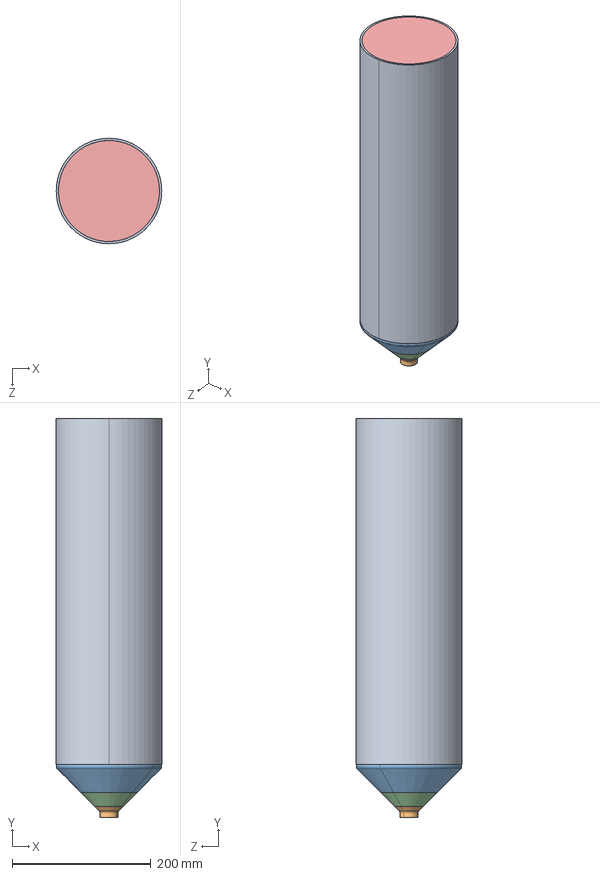
[picture p205: CAD file, 2025-01-19]
Research_Files/December/CAD_Files/Hopper_Tank_Assembly.STEP
152.4 x 576.2 x 152.4 mm
Hopper_Tank_Tube
Hopper_Tank_Funnel
Hopper_Tank_End_Cap
Hopper_Tank_Bottom_Cap
