JakCrane/FYP/Research_Files/December/CAD_Files/Hopper_Tank_Assembly - Hopper_Tank_Tube-1.STL

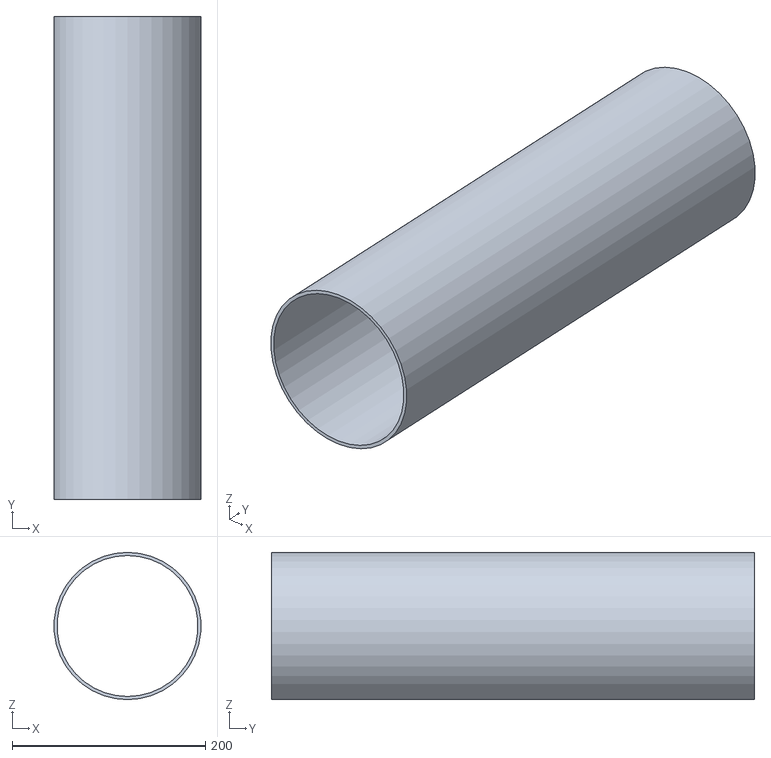
[picture p206: CAD file, 2025-01-19]
Research_Files/December/CAD_Files/Hopper_Tank_Assembly - Hopper_Tank_Tube-1.STL
151.9 x 500.0 x 152.4
