JakCrane/FYP/Research_Files/December/CAD_Files/Hopper_Tank_Assembly - Hopper_Tank_Funnel-1.STL

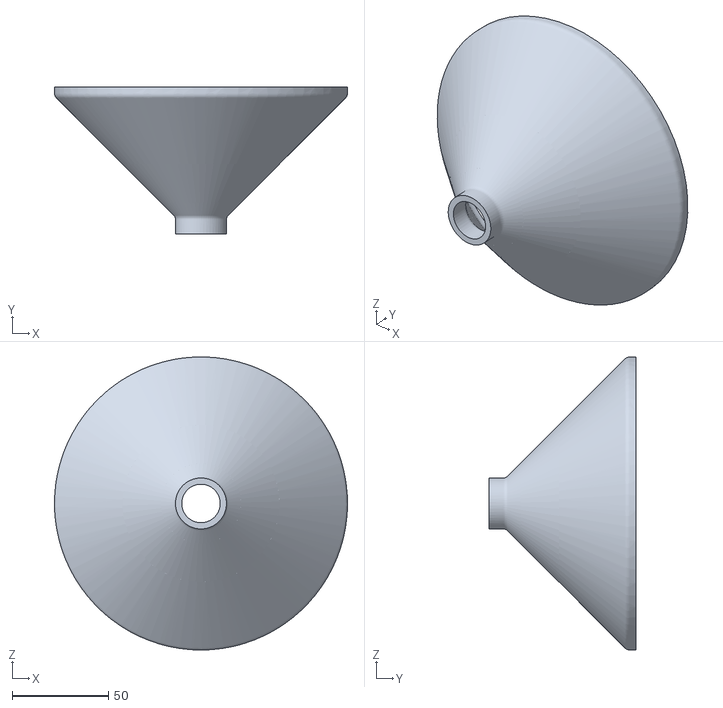
[picture p207: CAD file, 2025-01-19]
Research_Files/December/CAD_Files/Hopper_Tank_Assembly - Hopper_Tank_Funnel-1.STL
152.4 x 76.2 x 152.4
