JakCrane/FYP/Research_Files/February/CAD_Files/Simulation_Assembly1.SLDASM

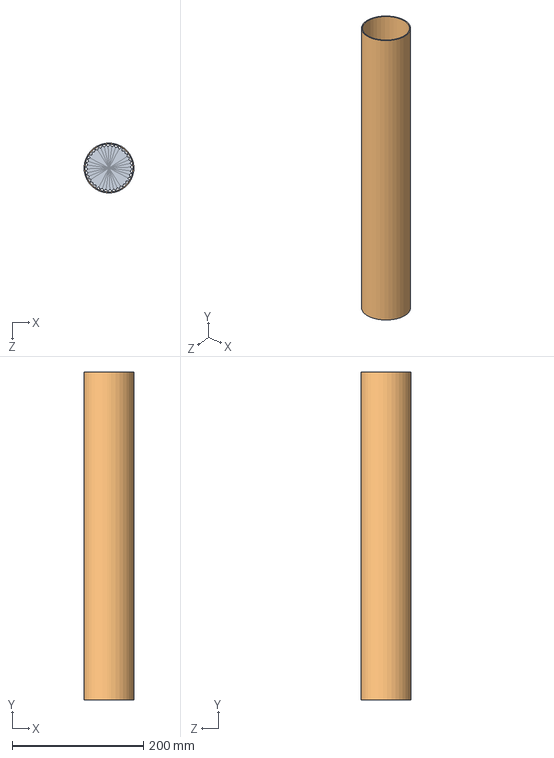
[picture p208: CAD file, 2025-04-27]
Research_Files/February/CAD_Files/Simulation_Assembly1.SLDASM
76.1 x 500.0 x 76.2 mm
Hopper_Tank_Tube
Hopper_Gear_Plunger
