JakCrane/FYP/Research_Files/April/Cad/Tank_holder.SLDASM

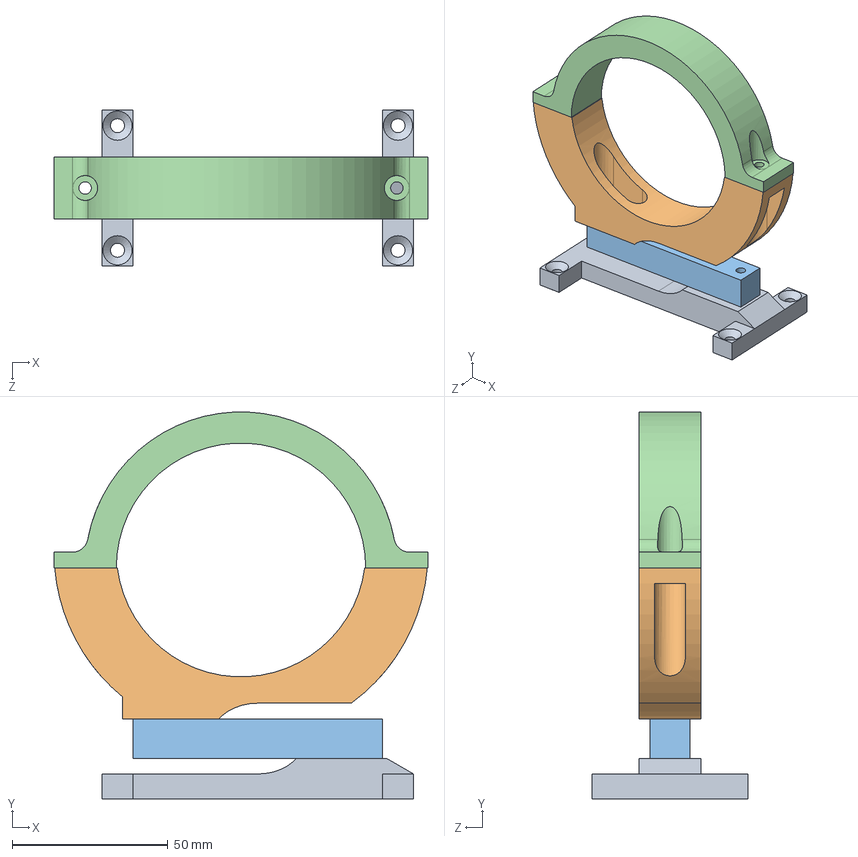
[picture p209: CAD file, 2025-04-27]
Research_Files/April/Cad/Tank_holder.SLDASM
120.0 x 124.1 x 50.0 mm
Top_Bracket
load_cell
Bottom_bracket
Base_bracket
