JakCrane/FYP/Research_Files/February/CAD_Files/Hopper_Tank_Assembly.SLDASM

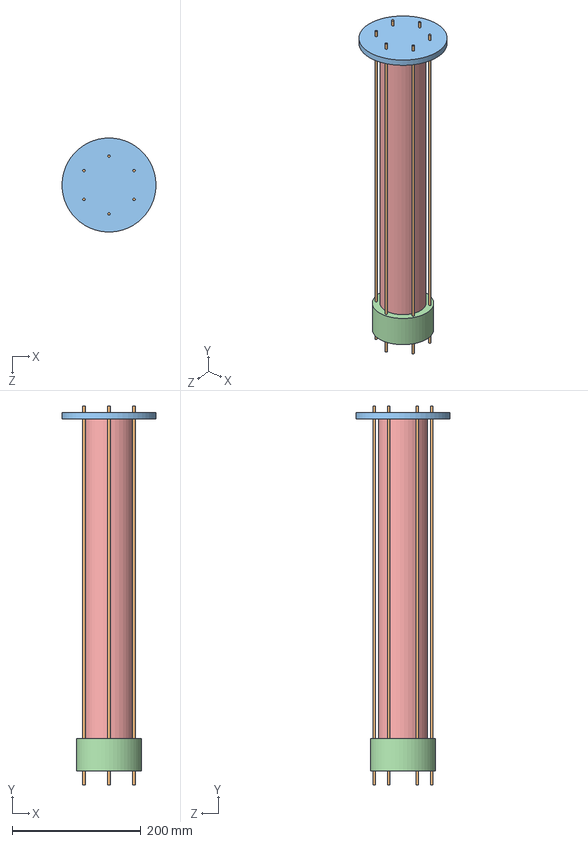
[picture p210: CAD file, 2025-02-11]
Research_Files/February/CAD_Files/Hopper_Tank_Assembly.SLDASM
145.8 x 588.0 x 145.9 mm
Hopper_Tank_Tube
Hopper_Tank_Funnel
Hopper_Tank_End_Cap
Hopper_Tank_Tie_Rod x 6
Hopper_Gear_Plunger
