JakCrane/FYP/Research_Files/February/CAD_Files/Plunger_Assembly1.SLDASM

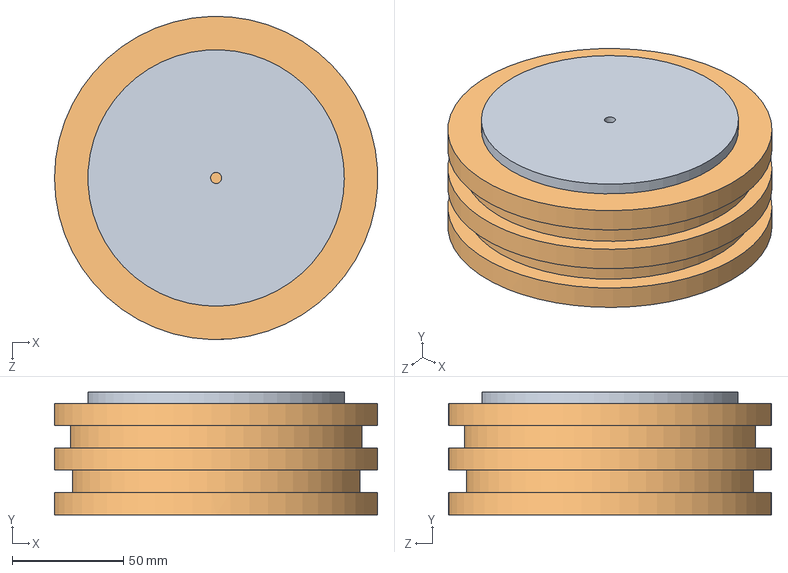
[picture p211: CAD file, 2025-02-04]
Research_Files/February/CAD_Files/Plunger_Assembly1.SLDASM
144.9 x 55.0 x 145.0 mm
Unattached_plunger_bottom
Unattached_plunger_top
