JakCrane/FYP/Research_Files/April/Cad/Cyclone_seperator.STEP

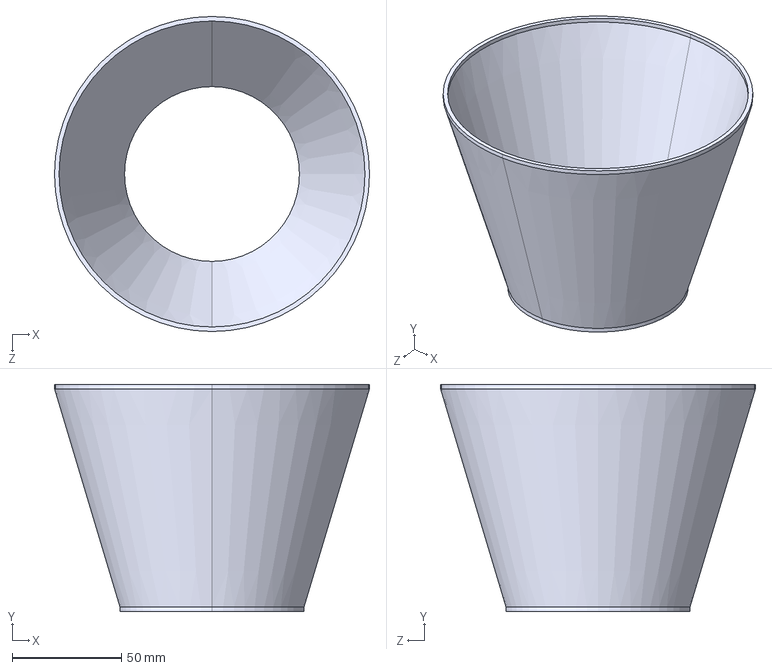
[picture p212: CAD file, 2025-05-17]
Research_Files/April/Cad/Cyclone_seperator.STEP
144.2 x 104.0 x 144.2 mm
