JakCrane/FYP/Research_Files/December/CAD_Files/Hopper_Tank_End_Cap.SLDPRT

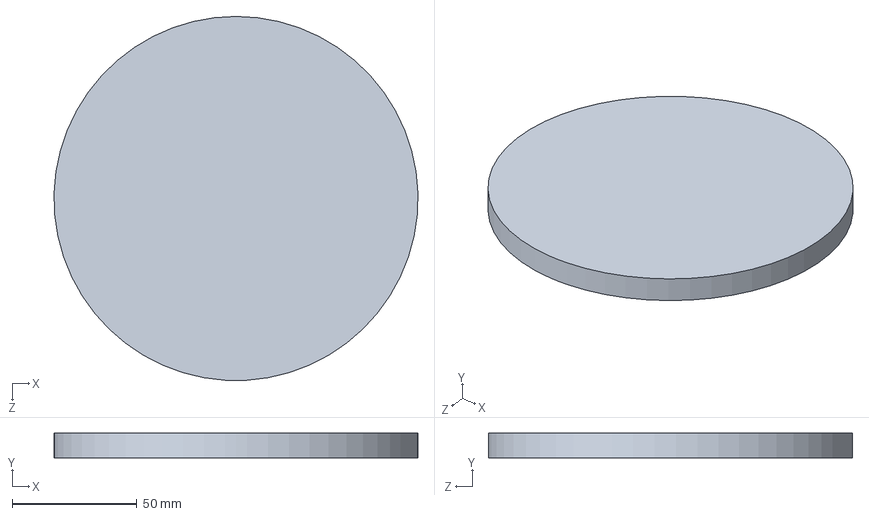
[picture p213: CAD file, 2025-01-19]
Research_Files/December/CAD_Files/Hopper_Tank_End_Cap.SLDPRT
145.8 x 10.0 x 145.9 mm
