JakCrane/FYP/Research_Files/February/CAD_Files/Acrylic_tube.SLDPRT

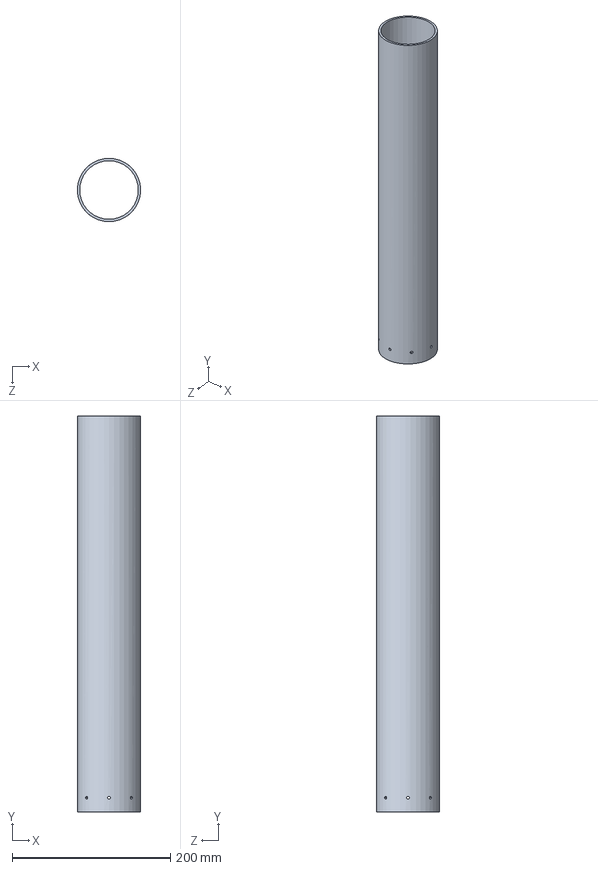
[picture p214: CAD file, 2025-06-15]
Research_Files/February/CAD_Files/Acrylic_tube.SLDPRT
80.0 x 500.0 x 80.0 mm
