JakCrane/FYP/Research_Files/May/piston/New_Piston_handle.STEP

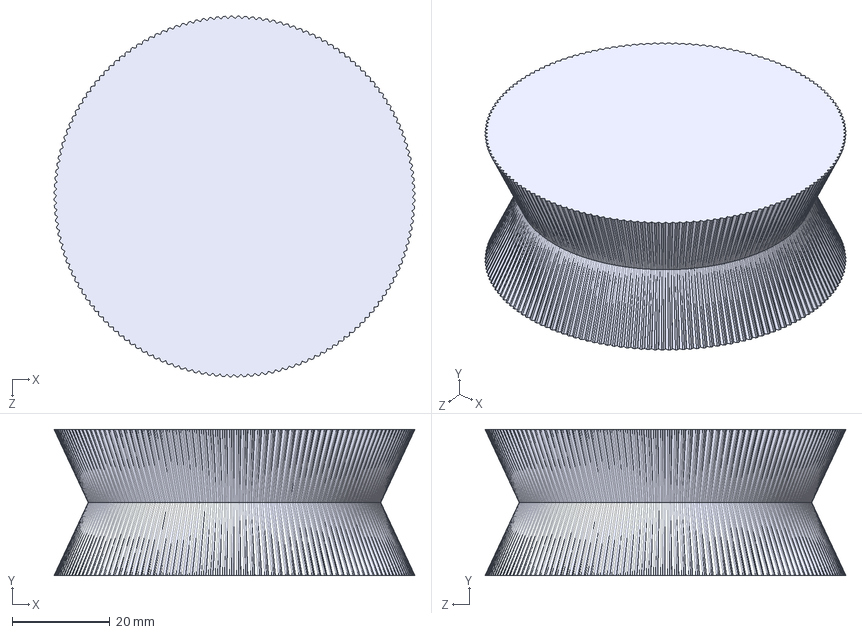
[picture p215: CAD file, 2025-05-24]
Research_Files/May/piston/New_Piston_handle.STEP
74.0 x 30.0 x 74.0 mm
