JakCrane/FYP/Research_Files/May/static_pressure/piston_support_middle.STEP

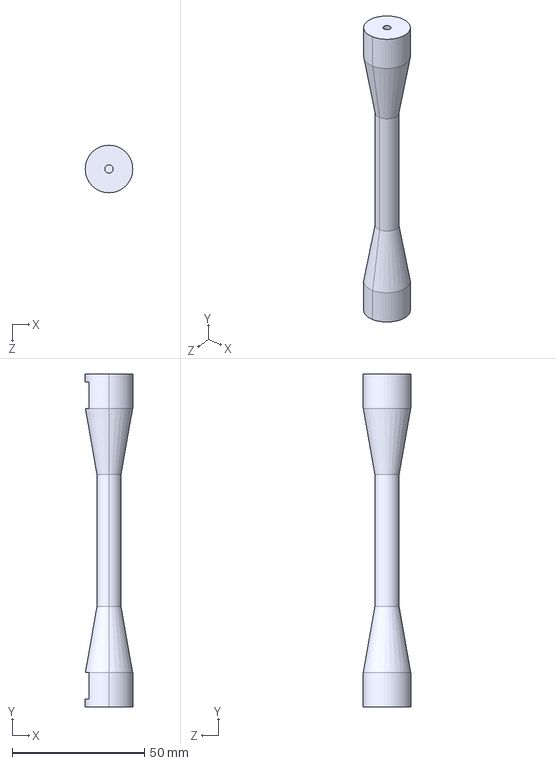
[picture p216: CAD file, 2025-05-29]
Research_Files/May/static_pressure/piston_support_middle.STEP
18.0 x 126.0 x 18.0 mm
