JakCrane/FYP/Research_Files/February/CAD_Files/dowty.SLDPRT

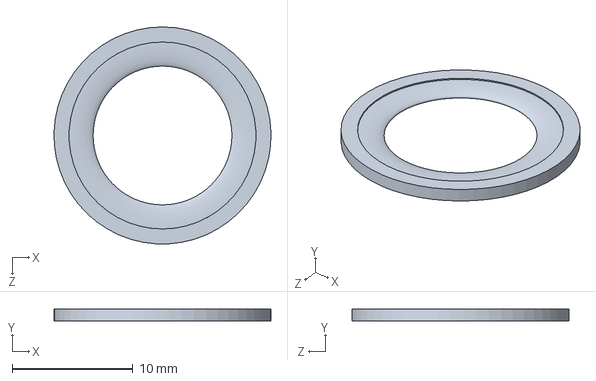
[picture p217: CAD file, 2025-05-29]
Research_Files/February/CAD_Files/dowty.SLDPRT
18.0 x 1.00 x 18.0 mm
