JakCrane/FYP/Research_Files/March/CAD_Fluent_prototype/chokepoint_funnel_combo.STEP

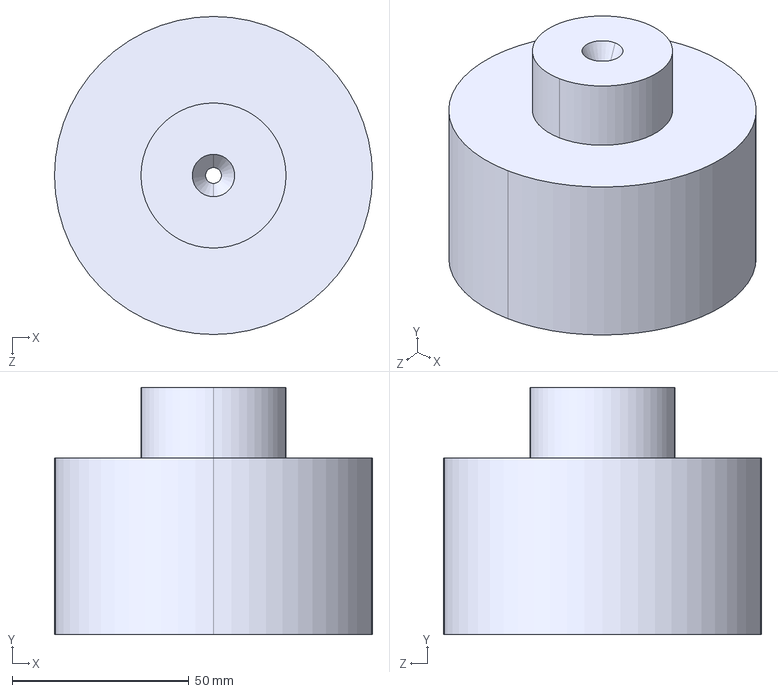
[picture p218: CAD file, 2025-04-27]
Research_Files/March/CAD_Fluent_prototype/chokepoint_funnel_combo.STEP
90.0 x 70.0 x 90.0 mm
