JakCrane/FYP/Research_Files/May/static_pressure/tank_model.STEP

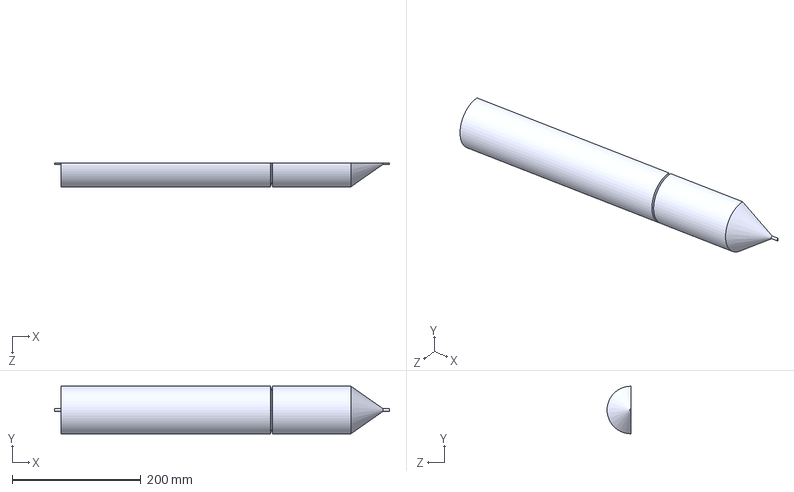
[picture p219: CAD file, 2025-05-29]
Research_Files/May/static_pressure/tank_model.STEP
520.0 x 74.0 x 37.0 mm
