JakCrane/FYP/Research_Files/April/Cad/Cyclone_base.SLDPRT

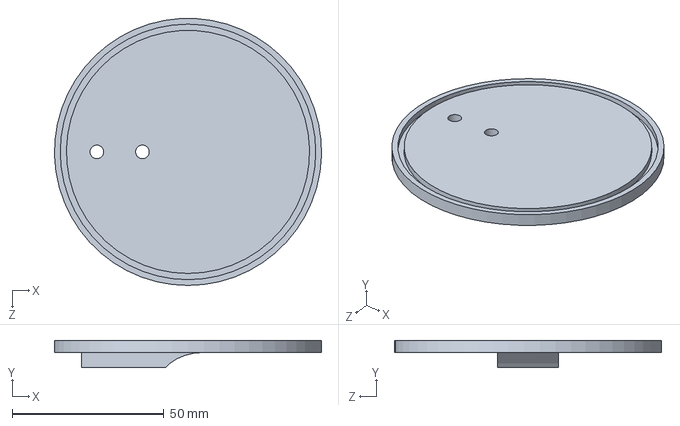
[picture p220: CAD file, 2025-05-17]
Research_Files/April/Cad/Cyclone_base.SLDPRT
87.9 x 9.00 x 87.8 mm
