JakCrane/FYP/Research_Files/December/CAD_Files/Hopper_Tank_Bottom_Cap.SLDPRT

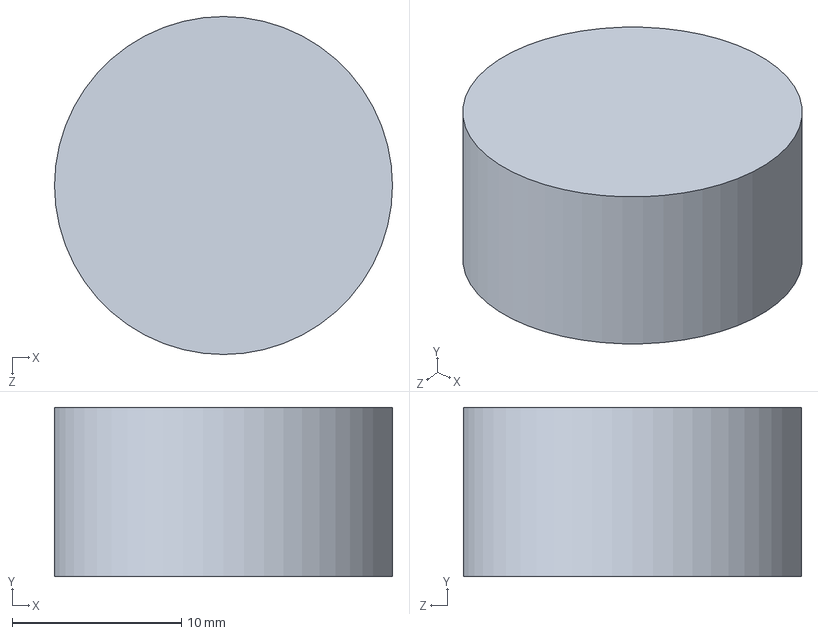
[picture p221: CAD file, 2025-01-19]
Research_Files/December/CAD_Files/Hopper_Tank_Bottom_Cap.SLDPRT
20.0 x 10.0 x 20.0 mm
