JakCrane/FYP/Research_Files/February/CAD_Files/oring_again.SLDPRT

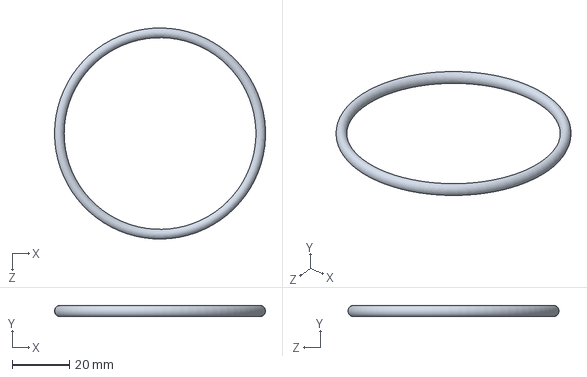
[picture p222: CAD file, 2025-05-29]
Research_Files/February/CAD_Files/oring_again.SLDPRT
73.7 x 3.80 x 73.7 mm
