JakCrane/FYP/Research_Files/May/static_pressure/piston_support_back.STEP

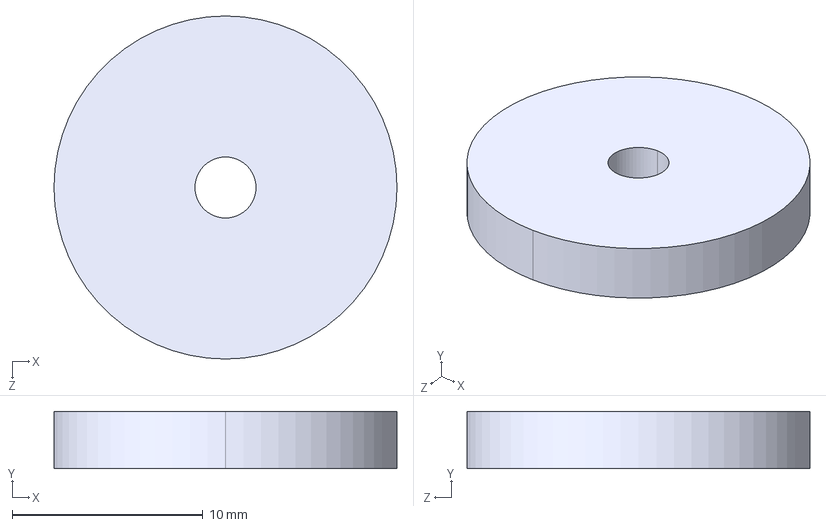
[picture p223: CAD file, 2025-05-29]
Research_Files/May/static_pressure/piston_support_back.STEP
18.0 x 3.00 x 18.0 mm
