JakCrane/FYP/Research_Files/April/Cad/Choke_Point_05.STEP

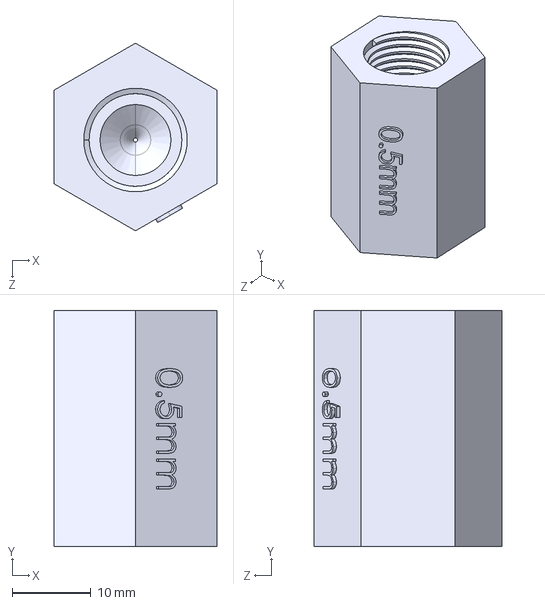
[picture p224: CAD file, 2025-05-17]
Research_Files/April/Cad/Choke_Point_05.STEP
20.7 x 30.0 x 23.9 mm
