JakCrane/FYP/Research_Files/February/CAD_Files/Delrin_Inner_End_Cap_Anchor.SLDPRT

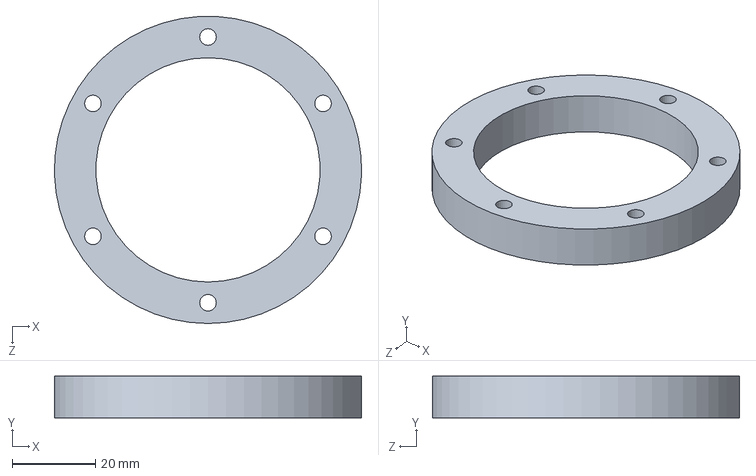
[picture p225: CAD file, 2025-04-27]
Research_Files/February/CAD_Files/Delrin_Inner_End_Cap_Anchor.SLDPRT
74.0 x 10.0 x 73.9 mm
