JakCrane/FYP/Research_Files/May/piston/New_Piston.STEP

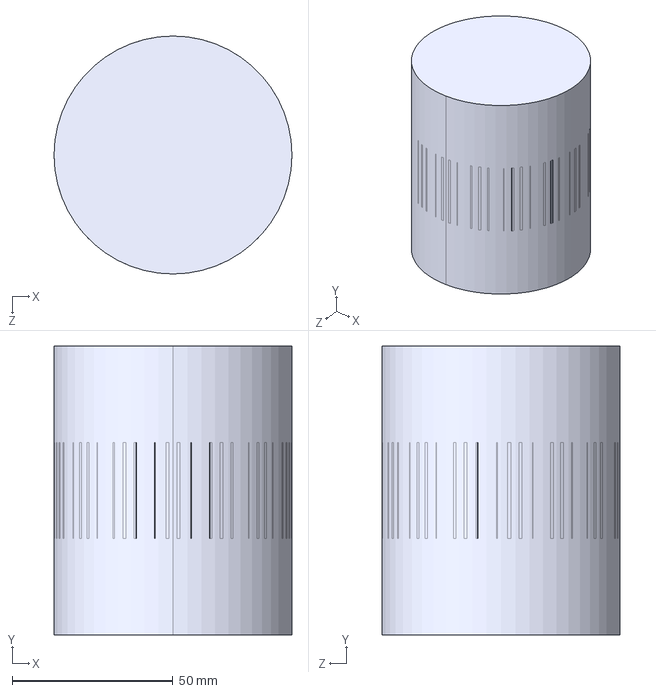
[picture p226: CAD file, 2025-05-24]
Research_Files/May/piston/New_Piston.STEP
74.1 x 90.0 x 74.1 mm
