JakCrane/FYP/Research_Files/May/static_pressure/piston_support_front_front.SLDPRT

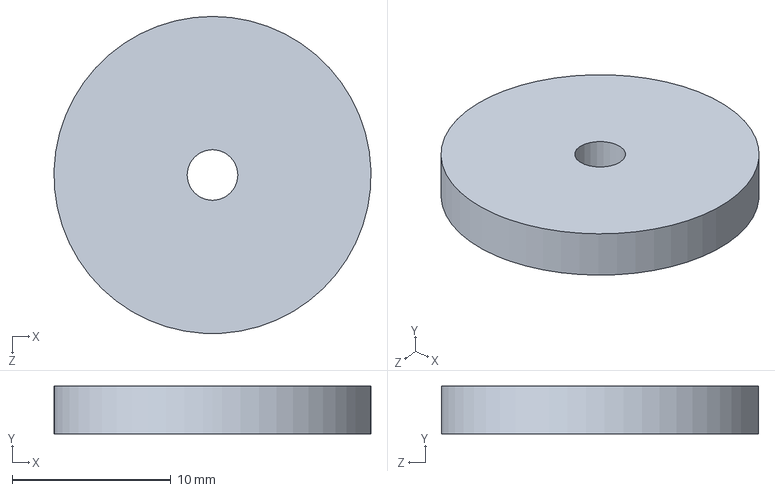
[picture p227: CAD file, 2025-05-29]
Research_Files/May/static_pressure/piston_support_front_front.SLDPRT
20.0 x 3.00 x 20.0 mm
