JakCrane/FYP/Research_Files/April/Cad/Cyclone_top.STEP

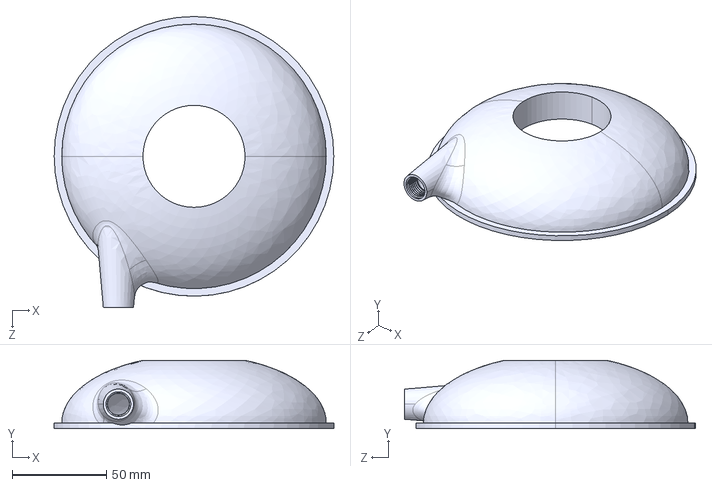
[picture p228: CAD file, 2025-05-17]
Research_Files/April/Cad/Cyclone_top.STEP
148.0 x 36.3 x 154.0 mm
