JakCrane/FYP/Research_Files/April/Cad/piston_v3.STEP

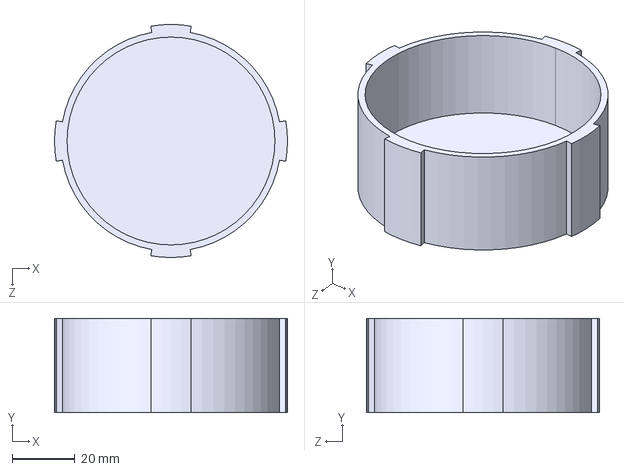
[picture p229: CAD file, 2025-05-17]
Research_Files/April/Cad/piston_v3.STEP
74.0 x 30.0 x 74.0 mm
