JakCrane/FYP/Research_Files/May/static_pressure/new_piston.STEP

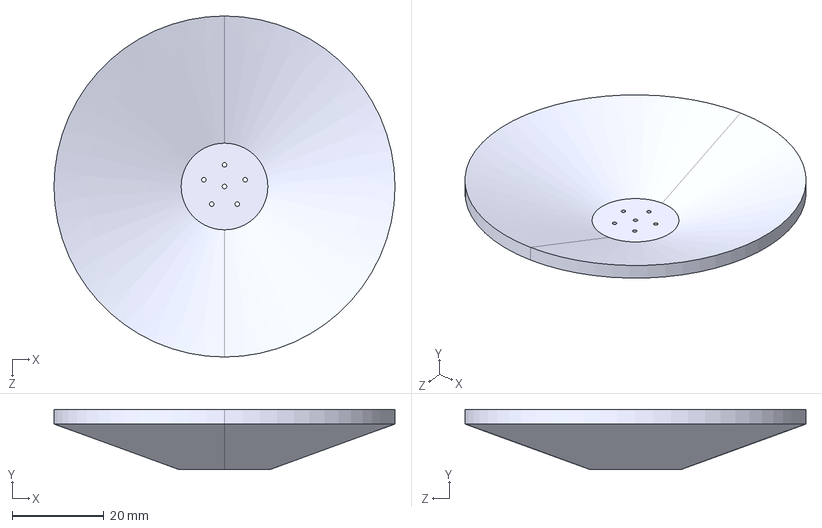
[picture p230: CAD file, 2025-05-29]
Research_Files/May/static_pressure/new_piston.STEP
74.5 x 13.1 x 74.5 mm
