JakCrane/FYP/Research_Files/April/Cad/Cyclone_bracket.SLDPRT

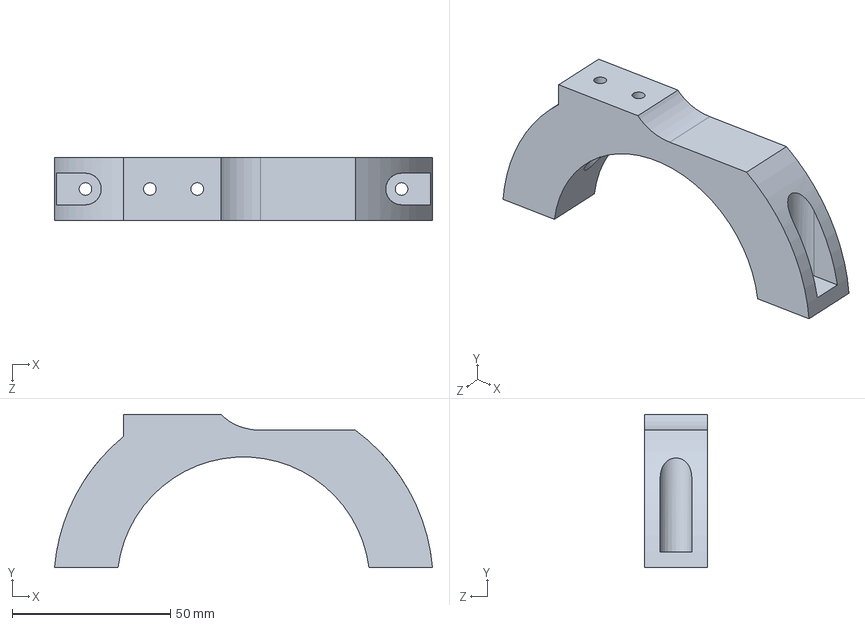
[picture p231: CAD file, 2025-05-17]
Research_Files/April/Cad/Cyclone_bracket.SLDPRT
119.6 x 48.5 x 20.0 mm
