JakCrane/FYP/Research_Files/February/CAD_Files/O_ring.SLDPRT

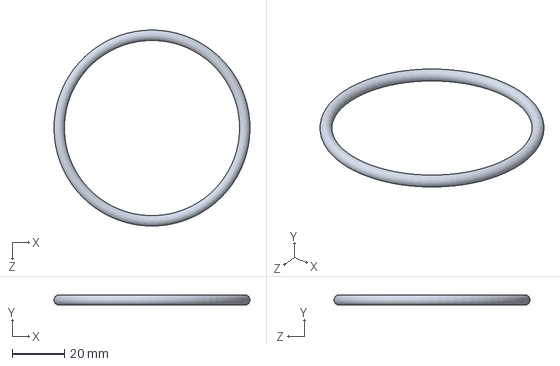
[picture p232: CAD file, 2025-04-27]
Research_Files/February/CAD_Files/O_ring.SLDPRT
75.0 x 4.00 x 75.0 mm
