JakCrane/FYP/Research_Files/February/CAD_Files/Delrin_Outer_End_Cap_Anchor.SLDPRT

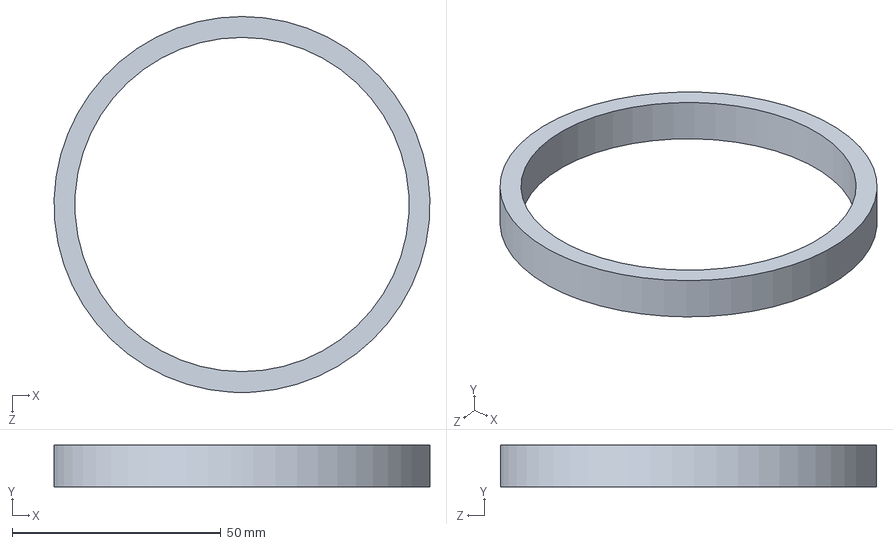
[picture p233: CAD file, 2025-04-27]
Research_Files/February/CAD_Files/Delrin_Outer_End_Cap_Anchor.SLDPRT
90.0 x 10.0 x 90.0 mm
