JakCrane/FYP/Research_Files/February/CAD_Files/Delrin_funnel.SLDPRT

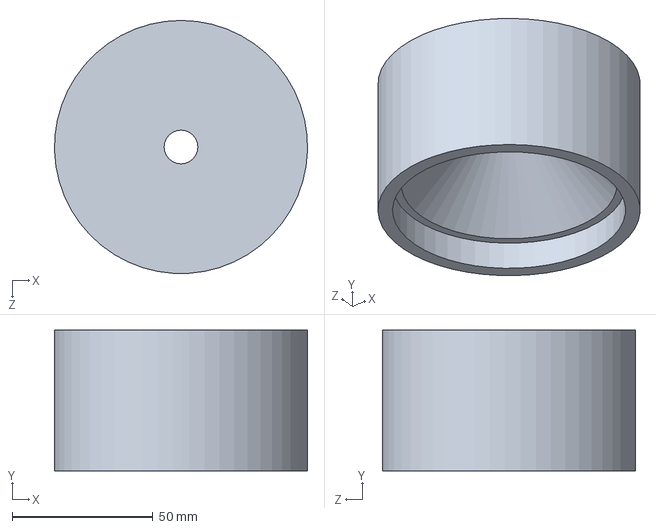
[picture p234: CAD file, 2025-04-27]
Research_Files/February/CAD_Files/Delrin_funnel.SLDPRT
90.0 x 50.0 x 90.0 mm
