JakCrane/FYP/Research_Files/April/Cad/Choke_Point_big.SLDPRT

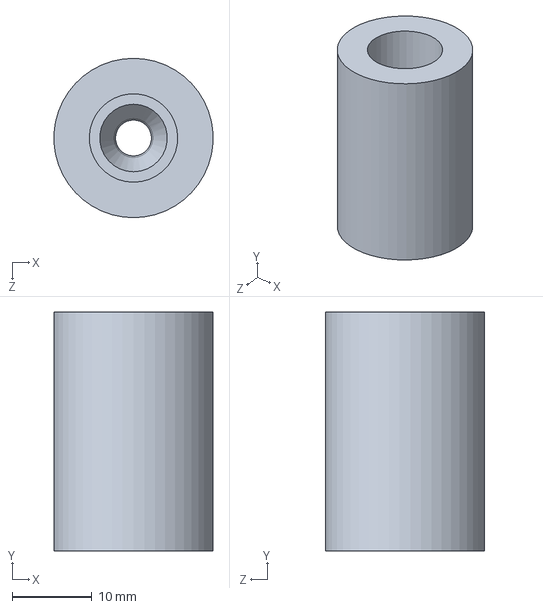
[picture p235: CAD file, 2025-04-27]
Research_Files/April/Cad/Choke_Point_big.SLDPRT
20.0 x 30.0 x 20.0 mm
