JakCrane/FYP/Research_Files/February/CAD_Files/Example_tubing.SLDPRT

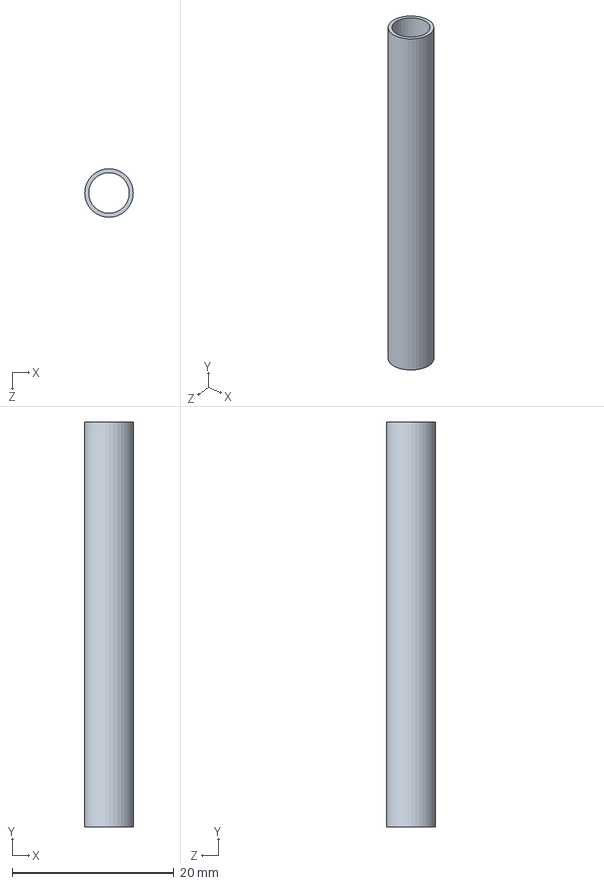
[picture p236: CAD file, 2025-04-27]
Research_Files/February/CAD_Files/Example_tubing.SLDPRT
6.00 x 50.0 x 6.00 mm
