JakCrane/FYP/Research_Files/February/CAD_Files/Delrin_End_Cap.SLDPRT

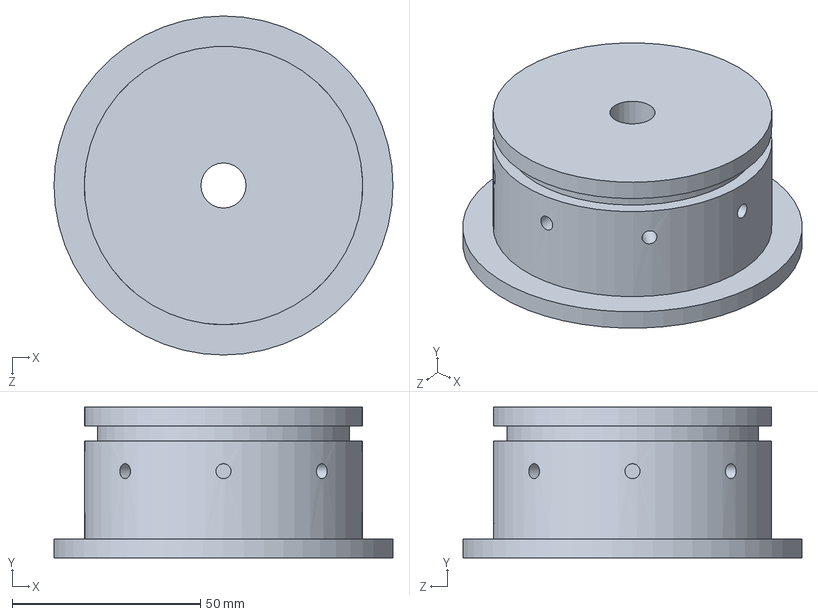
[picture p237: CAD file, 2025-04-27]
Research_Files/February/CAD_Files/Delrin_End_Cap.SLDPRT
90.0 x 40.0 x 90.0 mm
