JakCrane/FYP/Research_Files/February/CAD_Files/Push-To-Connect Connector 1-4 MNPT x 6mm.step

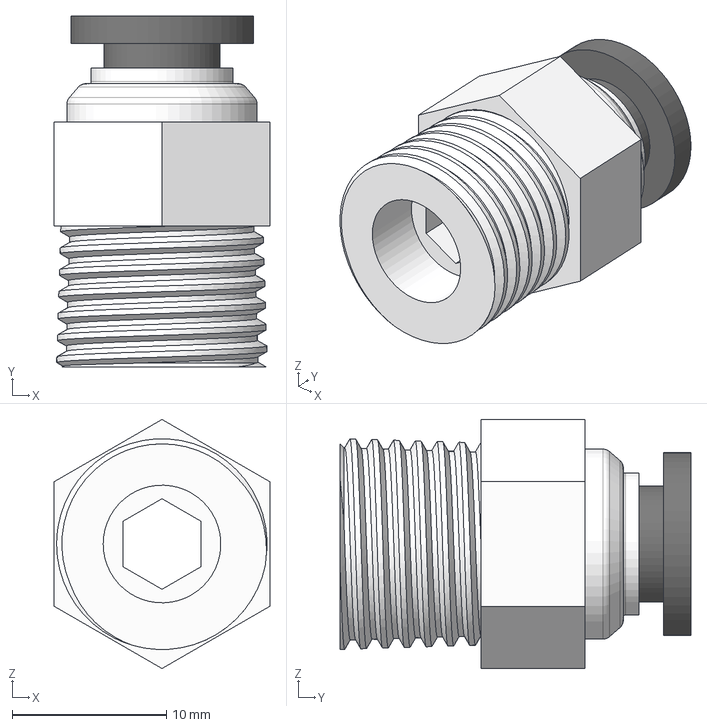
[picture p238: CAD file, 2025-04-27]
Research_Files/February/CAD_Files/Push-To-Connect Connector 1-4 MNPT x 6mm.step
14.0 x 22.7 x 16.1 mm
44605K172
Push-To-Connect Connector 1/4 MNPT x 6mm Push Connector_1
