JakCrane/FYP/Research_Files/April/Cad/load_cell.SLDPRT

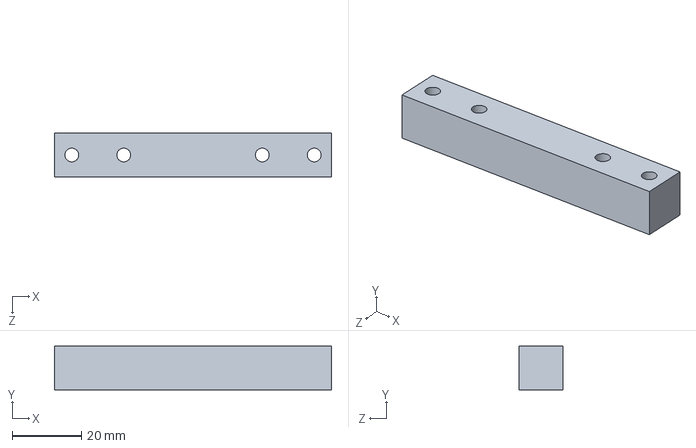
[picture p239: CAD file, 2025-04-27]
Research_Files/April/Cad/load_cell.SLDPRT
80.0 x 12.7 x 12.7 mm
