JakCrane/FYP/Research_Files/February/CAD_Files/Ø6 UNIÃO T (C00600600).sldprt

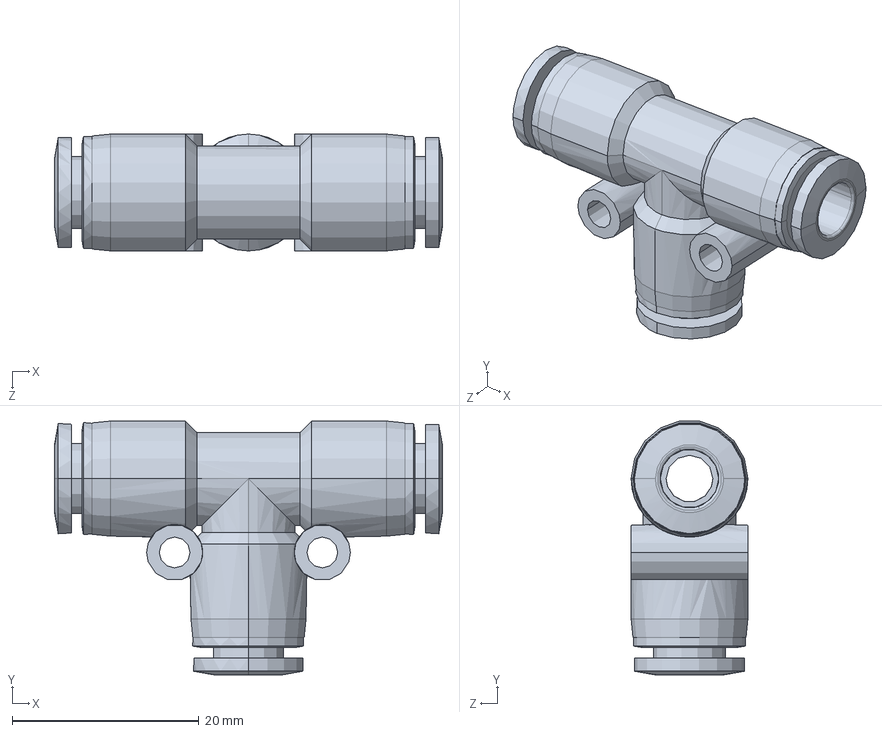
[picture p240: CAD file, 2025-04-27]
Research_Files/February/CAD_Files/Ø6 UNIÃO T (C00600600).sldprt
41.5 x 27.2 x 12.5 mm
