JakCrane/FYP/Research_Files/April/Cad/Hopper_Gear_Plunger.SLDPRT

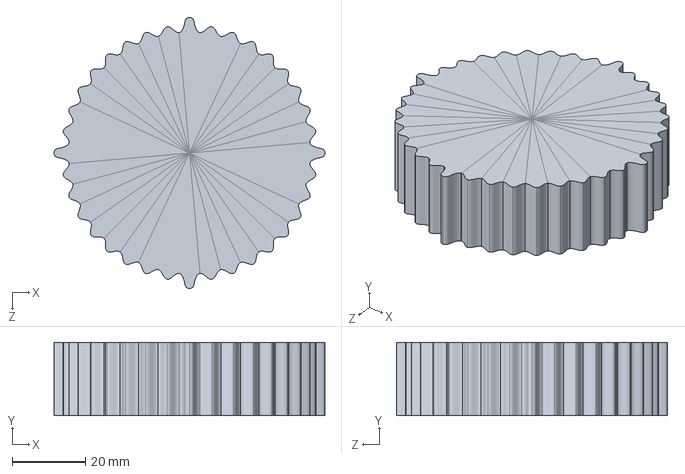
[picture p241: CAD file, 2025-04-27]
Research_Files/April/Cad/Hopper_Gear_Plunger.SLDPRT
74.0 x 20.0 x 74.0 mm
