JakCrane/FYP/Research_Files/February/CAD_Files/Hopper_Gear_Plunger.STEP

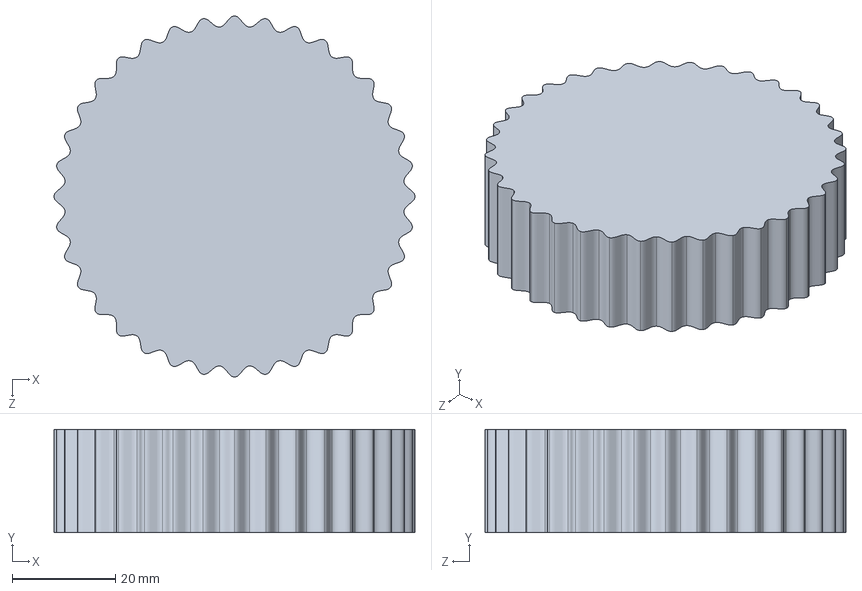
[picture p242: CAD file, 2025-04-27]
Research_Files/February/CAD_Files/Hopper_Gear_Plunger.STEP
70.0 x 20.0 x 70.0 mm
