JakCrane/FYP/Research_Files/April/Cad/Base_bracket.SLDPRT

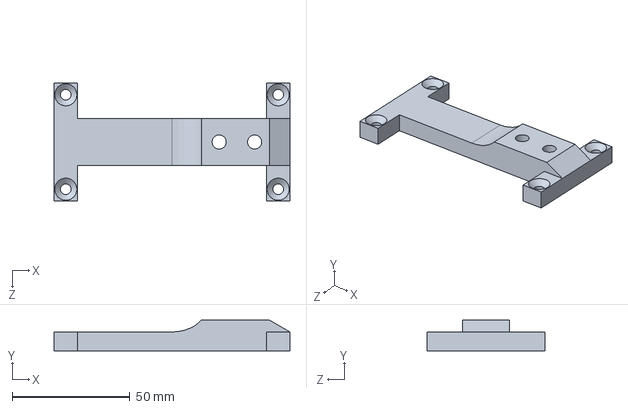
[picture p243: CAD file, 2025-04-27]
Research_Files/April/Cad/Base_bracket.SLDPRT
100.0 x 13.0 x 50.0 mm
