JakCrane/FYP/Research_Files/April/Cad/Top_Bracket.SLDPRT

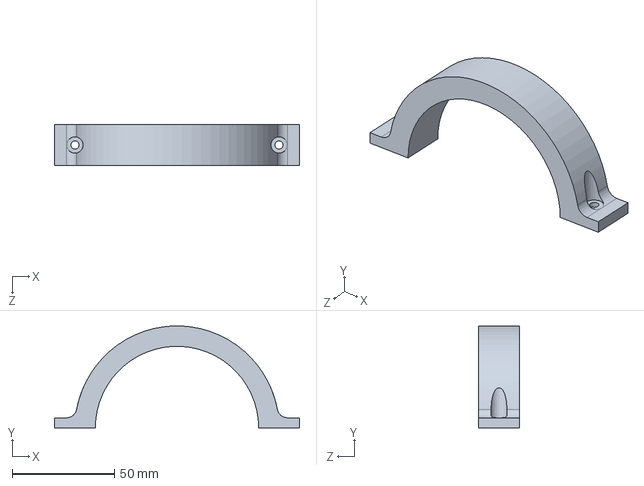
[picture p244: CAD file, 2025-04-27]
Research_Files/April/Cad/Top_Bracket.SLDPRT
120.0 x 49.9 x 20.0 mm
