JakCrane/FYP/Research_Files/February/CAD_Files/Hopper_Tank_End_Cap.SLDPRT

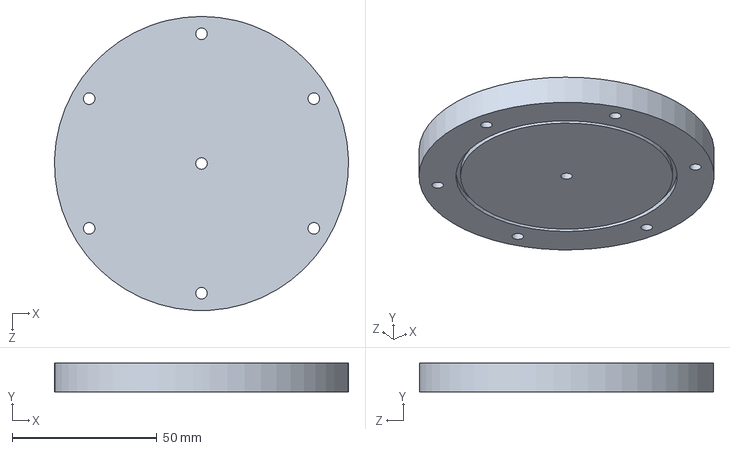
[picture p245: CAD file, 2025-02-11]
Research_Files/February/CAD_Files/Hopper_Tank_End_Cap.SLDPRT
101.6 x 10.0 x 101.6 mm
