JakCrane/FYP/Research_Files/February/CAD_Files/Hopper_Tank_Funnel.SLDPRT

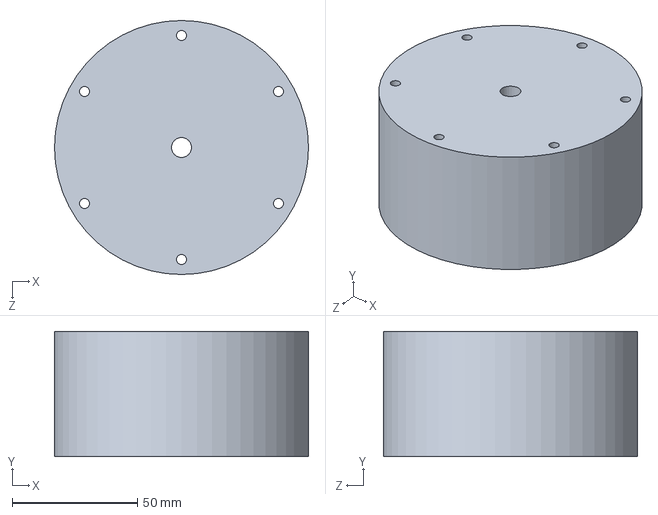
[picture p246: CAD file, 2025-02-11]
Research_Files/February/CAD_Files/Hopper_Tank_Funnel.SLDPRT
101.6 x 50.0 x 101.6 mm
