JakCrane/FYP/Research_Files/February/CAD_Files/Hopper_Tank_Tie_Rod.SLDPRT

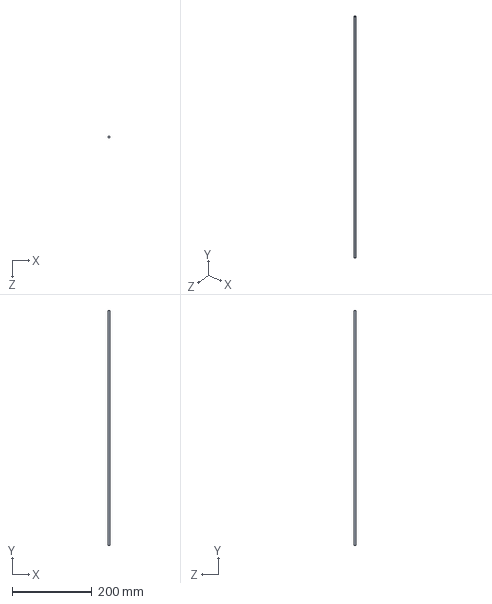
[picture p247: CAD file, 2025-02-11]
Research_Files/February/CAD_Files/Hopper_Tank_Tie_Rod.SLDPRT
4.00 x 588.0 x 4.00 mm
