JakCrane/FYP/Research_Files/February/CAD_Files/Hopper_Tank_Tube.SLDPRT

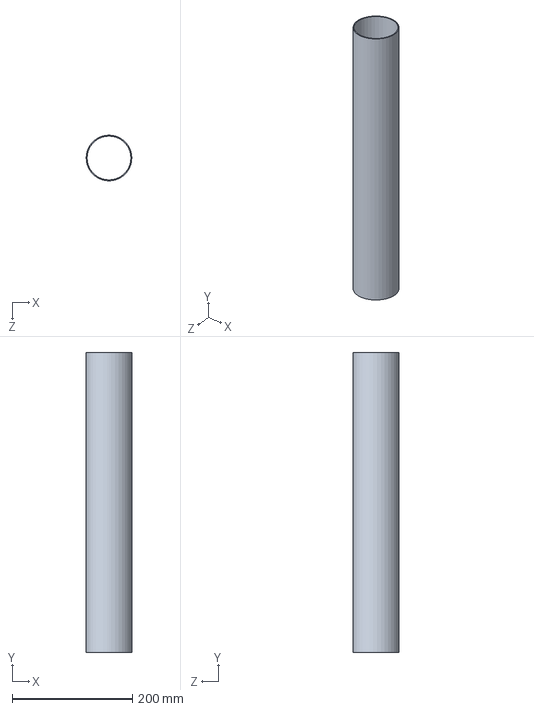
[picture p248: CAD file, 2025-02-11]
Research_Files/February/CAD_Files/Hopper_Tank_Tube.SLDPRT
76.1 x 500.0 x 76.2 mm
