JakCrane/FYP/Research_Files/February/CAD_Files/gear_plunger.SLDPRT

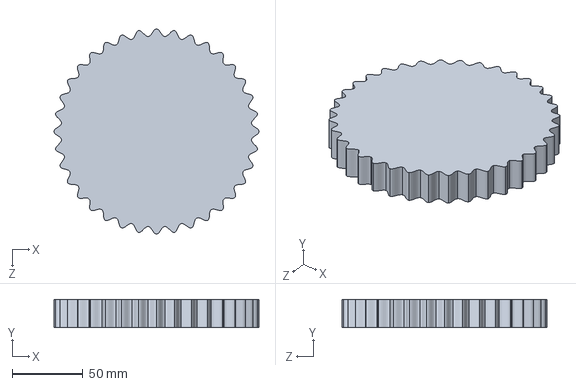
[picture p249: CAD file, 2025-02-10]
Research_Files/February/CAD_Files/gear_plunger.SLDPRT
145.0 x 20.0 x 145.0 mm
