JakCrane/FYP/Research_Files/February/CAD_Files/Unattached_plunger_top.SLDPRT

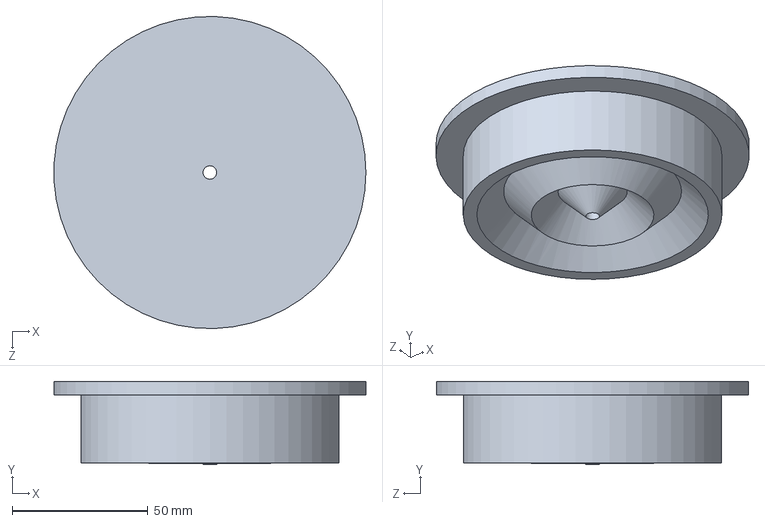
[picture p250: CAD file, 2025-02-04]
Research_Files/February/CAD_Files/Unattached_plunger_top.SLDPRT
114.9 x 30.6 x 114.9 mm
