JakCrane/FYP/Research_Files/February/CAD_Files/Unattached_plunger_bottom.SLDPRT

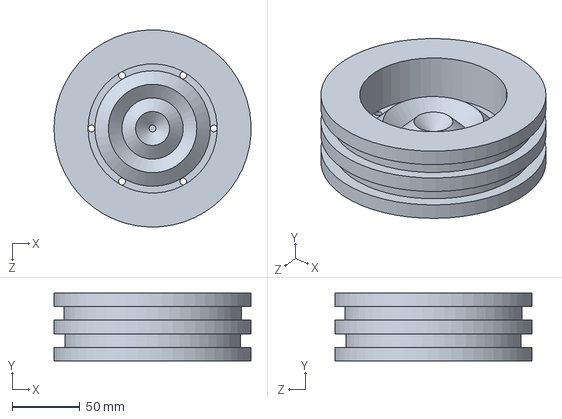
[picture p251: CAD file, 2025-02-04]
Research_Files/February/CAD_Files/Unattached_plunger_bottom.SLDPRT
144.9 x 50.0 x 145.0 mm
