JakCrane/FYP/Research_Files/February/CAD_Files/Hopper_Tank_Plunger_Head.SLDPRT

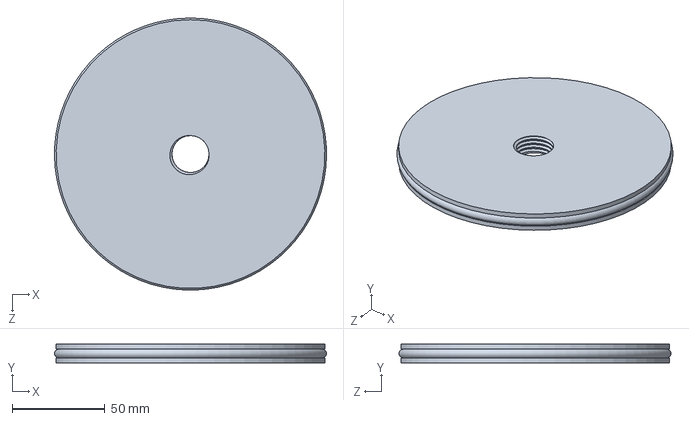
[picture p252: CAD file, 2025-01-19]
Research_Files/February/CAD_Files/Hopper_Tank_Plunger_Head.SLDPRT
146.8 x 10.0 x 146.7 mm
