JakCrane/FYP/Research_Files/February/CAD_Files/Hopper_Tank_Head_Connector.SLDPRT

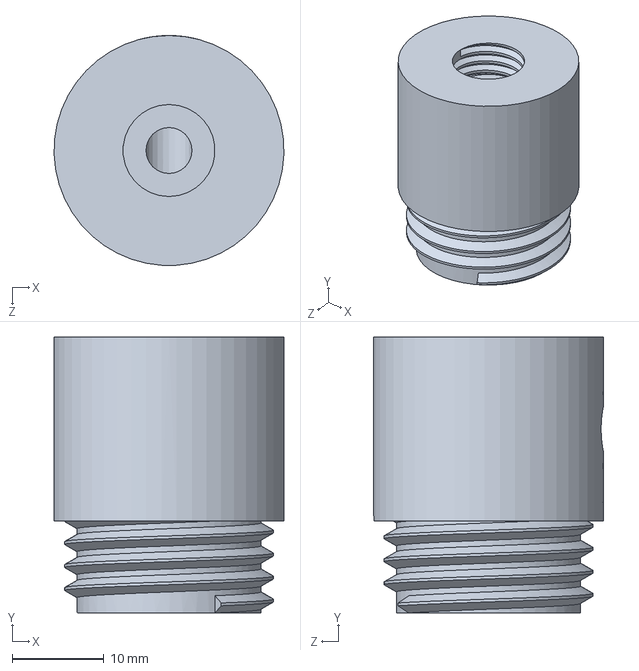
[picture p253: CAD file, 2025-01-19]
Research_Files/February/CAD_Files/Hopper_Tank_Head_Connector.SLDPRT
25.0 x 30.0 x 25.0 mm
