JakCrane/FYP/Research_Files/April/Cad/Cyclone.SLDASM

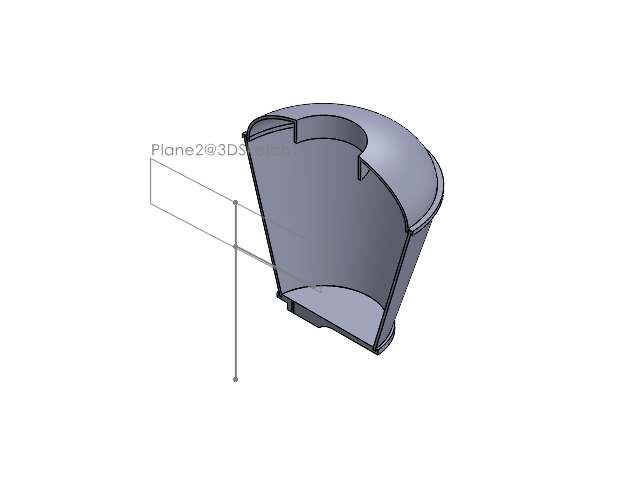
[picture p254: CAD file, 2025-05-17]
Research_Files/April/Cad/Cyclone.SLDASM
Cyclone_seperator
Cyclone_base
Cyclone_top
