JakCrane/FYP/Research_Files/February/CAD_Files/high level cad.SLDASM

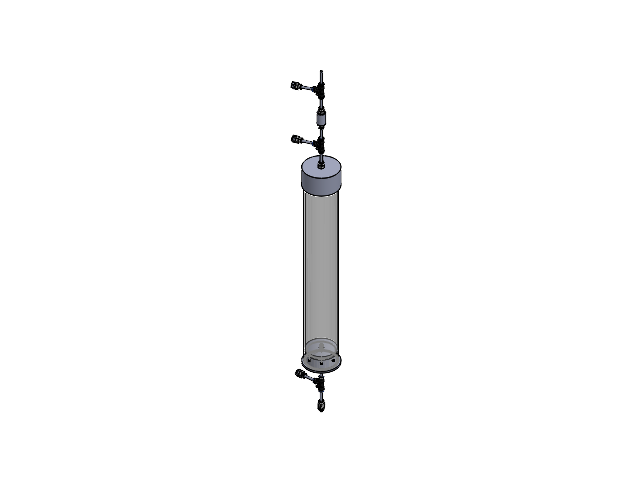
[picture p255: CAD file, 2025-04-27]
Research_Files/February/CAD_Files/high level cad.SLDASM
Acrylic_tube
Delrin_funnel
Delrin_End_Cap
Push-To-Connect Connector 1_4 MNPT x 6mm_1-0.step x 9
Push-To-Connect Connector 1_4 MNPT x 6mm Push Connector_1.step x 9
O_ring
Example_tubing x 9
Ø6 UNIÃO T (C00600600) x 3
Choke_Point
Part1^Push-To-Connect Connector 1-4 MNPT x 6mm_female_IG x 3
