JakCrane/FYP/Research_Files/February/CAD_Files/Prototype_Assembly.SLDASM

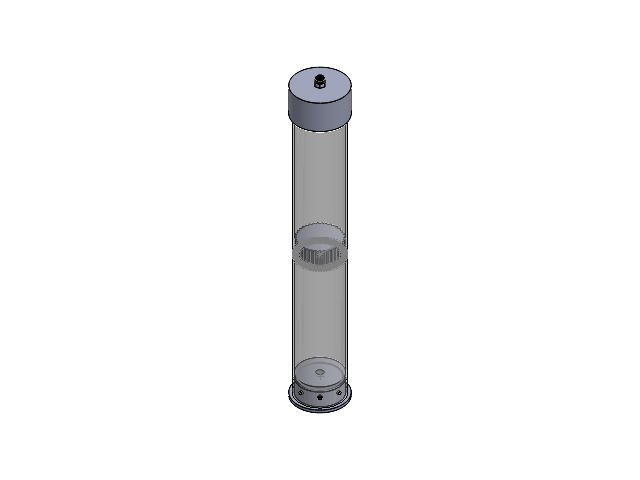
[picture p256: CAD file, 2025-04-27]
Research_Files/February/CAD_Files/Prototype_Assembly.SLDASM
Acrylic_tube
Delrin_funnel
Delrin_End_Cap
Push-To-Connect Connector 1_4 MNPT x 6mm_1-0.step x 2
Push-To-Connect Connector 1_4 MNPT x 6mm Push Connector_1.step x 2
O_ring
Hopper_Gear_Plunger
