JakCrane/FYP/Research_Files/February/CAD_Files/Push-To-Connect Connector 1-4 MNPT x 6mm_female_IG.SLDASM

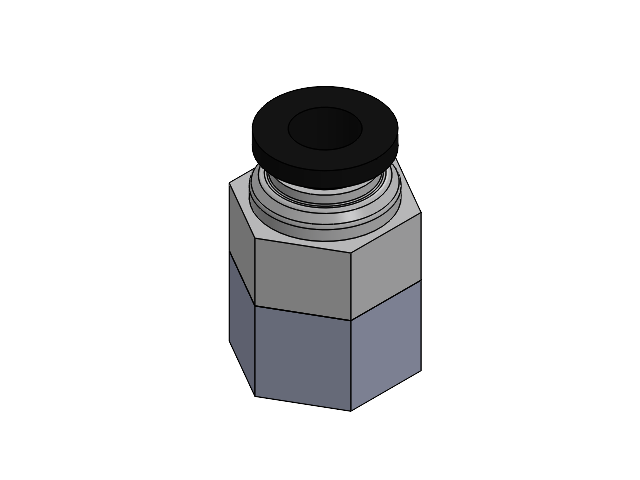
[picture p257: CAD file, 2025-04-27]
Research_Files/February/CAD_Files/Push-To-Connect Connector 1-4 MNPT x 6mm_female_IG.SLDASM
Push-To-Connect Connector 1_4 MNPT x 6mm_1-0.step
Push-To-Connect Connector 1_4 MNPT x 6mm Push Connector_1.step
Part1^Push-To-Connect Connector 1-4 MNPT x 6mm
