JakCrane/FYP/(list of files, cad)

Other CAD files:
Research_Files/December/CAD_Files/2D_Geometry_of_assembly_for_learning.SLDPRT
Research_Files/February/CAD_Files/Plunger_Assembly.STEP
Research_Files/May/piston/Part1.SLDPRT
Research_Files/May/piston/New_.SLDPRT
Research_Files/April/Cad/Choke_Point_10.STEP
Research_Files/May/static_pressure/piston_support_front.STEP
Research_Files/December/CAD_Files/Hopper_Tank_Funnel.STEP
Research_Files/April/Cad/Choke_Point_20.STEP
Research_Files/April/Cad/Choke_Point.SLDPRT
Research_Files/April/Cad/Bottom_bracket.SLDPRT
Research_Files/April/Cad/Base_bracket.STL
Research_Files/April/Cad/Bottom_bracket.STL
Research_Files/April/Cad/Choke_Point.SLDDRW
Research_Files/April/Cad/Choke_Point.STL
Research_Files/April/Cad/Choke_Point_05.SLDPRT
Research_Files/April/Cad/Choke_Point_10.SLDPRT
Research_Files/April/Cad/Choke_Point_20.SLDPRT
Research_Files/April/Cad/Cyclone_base.STL
Research_Files/April/Cad/Cyclone_seperator.SLDPRT
Research_Files/April/Cad/Cyclone_seperator.STL
Research_Files/April/Cad/Cyclone_top.SLDPRT
Research_Files/April/Cad/Cyclone_top.STL
Research_Files/April/Cad/Hopper_Gear_Plunger.STL
Research_Files/April/Cad/Top_Bracket.STL
Research_Files/April/Cad/piston_v2.3mf
Research_Files/April/Cad/piston_v2.SLDPRT
Research_Files/April/Cad/piston_v2.STEP
Research_Files/April/Cad/piston_v3.SLDPRT
Research_Files/December/CAD_Files/2D_Geometry_of_assembly_for_learning.DXF
Research_Files/December/CAD_Files/Hopper_Tank_Assembly.SLDASM
Research_Files/December/CAD_Files/Hopper_Tank_Funnel.SLDPRT
Research_Files/February/CAD_Files/Delrin_End_Cap.SLDDRW
Research_Files/February/CAD_Files/Delrin_End_Cap.STL
Research_Files/February/CAD_Files/Delrin_funnel.SLDDRW
Research_Files/February/CAD_Files/Delrin_funnel.STL
Research_Files/February/CAD_Files/Hopper_Gear_Plunger.SLDPRT
Research_Files/February/CAD_Files/Push-To-Connect Connector 1-4 MNPT x 6mm.SLDASM
Research_Files/January/old_design_cad_for_sims/old_hopper_design.SLDPRT
Research_Files/January/old_design_cad_for_sims/old_hopper_design.STEP
Research_Files/January/old_design_cad_for_sims_but_3d/Hopper_from_mesh_upwards.SLDPRT
Research_Files/January/old_design_cad_for_sims_but_3d/Hopper_from_mesh_upwards.x_t
Research_Files/March/CAD_Fluent_prototype/Prototype_for_sim_Assembly.SLDASM
Research_Files/March/CAD_Fluent_prototype/chokepoint_funnel_combo.SLDPRT
Research_Files/May/piston/New_Piston.SLDPRT
Research_Files/May/piston/New_Piston_handle.SLDPRT
Research_Files/May/static_pressure/new_piston.SLDPRT
Research_Files/May/static_pressure/piston_support_back.SLDPRT
Research_Files/May/static_pressure/piston_support_front.SLDPRT
Research_Files/May/static_pressure/piston_support_middle.SLDPRT
Research_Files/May/static_pressure/tank_model - Copy.SLDPRT
Research_Files/May/static_pressure/tank_model.SLDPRT
