JakCrane/FYP/Research_Files/February/Operation_of_magnetically_assisted_fluidized_beds_in_microgravity.pdf

# Operation of magnetically assisted fluidized beds in microgravity and variable gravity: experiment and theory

## T. Sornchamni a,*, G.N. Jovanovic a

## , B.P. Reed a

## , J.E. Atwater b

,

## J.R. Akse b

## , R.R. Wheeler b

a Department of Chemical Engineering, Oregon State University, 102 Gleeson Hall, Corvallis, OR 97331, USA b UMPQUA Research Company, 125 Volunteer Way, P.O. Box 609, Myrtle Creek, OR 97457, USA

Received 29 April 2003; received in revised form 16 July 2004; accepted 19 July 2004

Abstract

The conversion of solid waste into useful resources in support of long duration manned missions in space presents serious technological challenges. Several technologies, including supercritical water oxidation, microwave powered combustion and fluidized bed incineration, have been tested for the conversion of solid waste. However, none of these technologies are compatible with microgravity or hypogravity operating conditions. In this paper, we present the gradient magnetically assisted fluidized bed (G-MAFB) as a promising operating platform for fluidized bed operations in the space environment. Our experimental and theoretical work has resulted in both the development of a theoretical model based on fundamental principles for the design of the G-MAFB, and also the practical implementation of the G-MAFB in the filtration and destruction of solid biomass waste particles from liquid streams. 2004 COSPAR. Published by Elsevier Ltd. All rights reserved.

Keywords: Microgravity; Fluidized beds; Solid biomass waste; Space life sciences

1. Introduction

Typically, the operation of a conventional fluidized bed relies on the balance of gravitational, Fg, buoyancy, Fb, and drag forces, Fd. However, in the absence of normal gravity, or under microgravity and variable gravity conditions, the gravitational force must be replaced with an alternative force to restore normal fluidization, otherwise the particles in the fluidized bed will be immediately swept away in the direction of fluid flow (Fig. 1(a)). The gradient magnetically assisted fluidized bed (G-MAFB) technology, particularly developed for microgravity, hypogravity and variable gravity operating conditions, takes advantage of a magnetic force, Fm, created on magnetically susceptible media in a non-uniform magnetic field. Magnetic field and magnetic forces provide the basis for fluidization under a variety of gravitational environments, including microgravity, as shown in Fig. 1(b). Our work has shown that, given a suitable variable field profile, the resulting magnetic field gradient can create sufficient magnetic force, acting upon the ferromagnetic particles to replace or supplement the gravitational force. Therefore, the ferromagnetic granular media can be fluidized in either microgravity or hypogravity conditions.
Separation of solid particles (waste) from liquid waste streams and subsequent conversion of solids into useful resources are important elements of the life support system envisioned for long duration missions and habitation in space. Upon the successful development of the G-MAFB (Jovanovic et al., 1999), which can be operated in the absence of gravity, the G-MAFB

0273-1177/$30 2004 COSPAR. Published by Elsevier Ltd. All rights reserved. doi:10.1016/j.asr.2004.07.010

* Corresponding author.
E-mail addresses: sornchth@engr.orst.edu (T. Sornchamni), jatwater@engr.orst.edu (J.E. Atwater).

www.elsevier.com/locate/asr

Advances in Space Research 34 (2004) 1494–1498

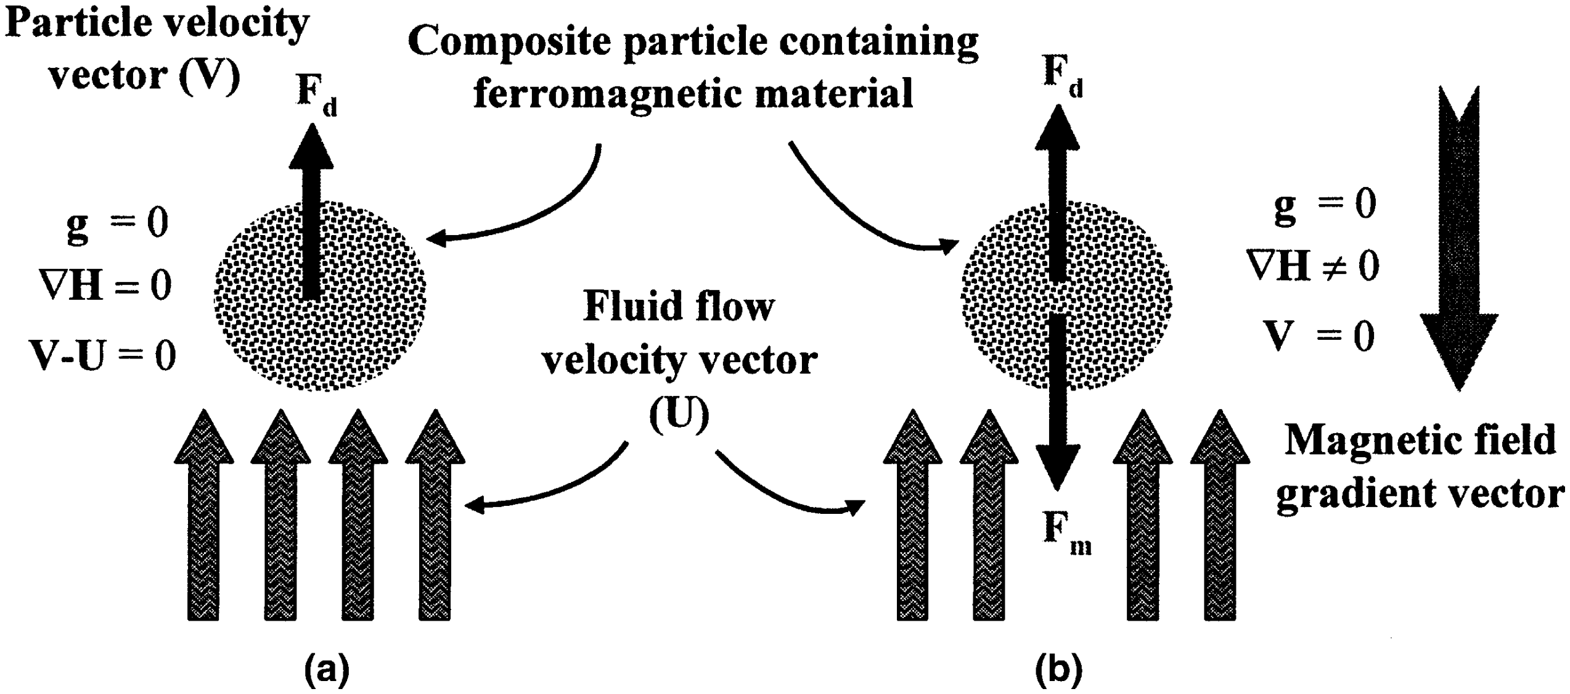
[picture p261: figure]

is proposed as a platform for solid waste destruction in a closed-loop life support system. In this paper, we report the experimental results describing filtration of micron-size biomass waste particles in the G-MAFB. In addition, a mathematical model of biomass collection in the G-MAFB filter is developed. The model predicts the change of waste particle concentration in a liquid suspension with time.

2. Experimental apparatus and material

Experiments were conducted both on-board NASAs KC-135 aircraft for microgravity magnetic force demonstration and in the laboratory environment (one-g) for filtration studies. The experiments in microgravity were conducted in a two-dimensional, square cross-section, tapered fluidization column, as shown in Fig. 2. The tapered shape was introduced to provide additional stability to the fluidization particles. The magnetic field in the G-MAFB was created by a set of Helmholtz rings along the fluidization column. The magnetic field intensity and field gradient were kept constant for all experiments. The height of the bed, at different flow rates, was recorded by a digital camcorder.
The apparatus used for laboratory filtration experiments is a cylindrical bed with constant cross-sectional area, as shown in Fig. 3. The fluidization column is made of Plexiglas, allowing visual observation through the wall. The column has an inside diameter of 5.04 cm and an outside diameter of 5.80 cm. A distributor plate is located at the bottom of the bed, which can be easily removed or repositioned to any location along the column. The micron-size biomass waste particles (149 lm<dp< 180 lm) were suspended in water, and the ferromagnetic particles were used as filter media.

Fig. 1. Balance of forces acting on a fluidized particle containing ferromagnetic material in: (a) a fluidized bed in microgravity in the absence of a magnetic field and (b) a gradient magnetically assisted fluidized bed in microgravity.

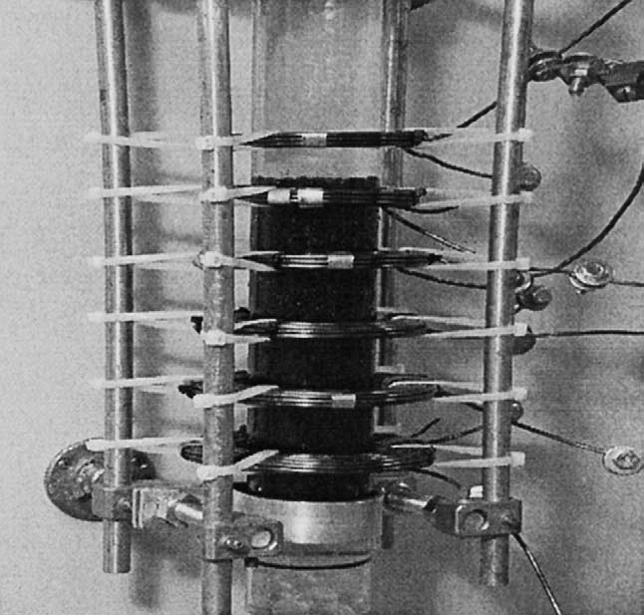
[picture p262: figure]
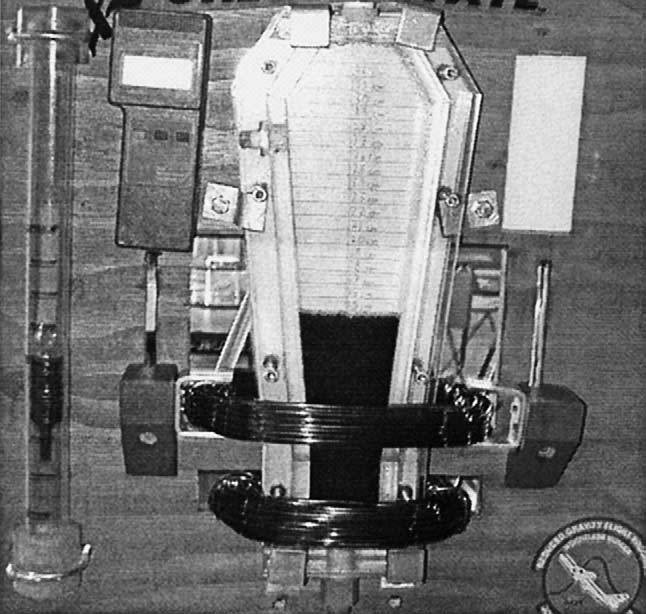
[picture p263: figure]

Fig. 2. Experimental apparatus used in microgravity experiments. | Fig. 3. Experimental apparatus used for filtration experiments (one-g).
T. Sornchamni et al. / Advances in Space Research 34 (2004) 1494–1498 | 1495

The magnetic field generator used in these experiments is composed of a direct current (DC) power supply connected to six Helmholtz rings. The overall magnetic field intensity, (H), within the fluidized bed is the superposition of the magnetic field intensities generated from each Helmholtz ring. The electromagnets are positioned such that the magnetic field intensity is strongest at the bottom of the bed, and decreases toward the top of the bed. The concentration of biomass particles was monitored online using a laser-photodiode detector.

3. Experimental results and discussion
3.1. The effect of magnetic force (Fm) in the G-MAFB under microgravity

The magnetic force acting on ferromagnetic particles is computed with the assumption that the fluidization particles contain a soft (i.e., easily magnetized and demagnetized) ferromagnetic material. The ferromagnetic particles used in this study indeed contain soft ferromagnetic materials. The composition and the manufacturing procedure of the ferromagnetic particles can be found elsewhere (Atwater et al., 2001, 2003). The magnetization of the fluidized bed as a whole, Mb, is assumed to be collinear with the magnetic field intensity. Rosensweig (1979) defined the magnetic body force acting on a magnetic medium in a non-uniform magnetic field as follows:

Fm ¼ l0MbrH: | ð1Þ

The ferromagnetic particles (Dp = 2.4 mm, 30%wt ferrite) were fluidized in the G-MAFB using a magnetic field intensity gradient as shown in Fig. 4. Microgravity fluidization experiments were conducted over a range of aqueous flow rates. The relationship between height of the bed and fluid flow rate is shown in Fig. 5. These experiments clearly demonstrate that magnetic forces can be used to achieve stable fluidization in the absence of gravity, which otherwise would not be possible. Detailed analysis and experimental results related to the fluid dynamic behavior of the G-MAFB both in microgravity and the one-g environment are presented in Sornchamni (2004).

3.2. Filtration experiments and mathematical modeling

The filtration experiments were conducted in a closed recirculating G-MAFB system with a constant magnetic field gradient. During the filtration process, the bed was kept in either a packed or an incipient fluidization condition and biomass waste particles were deposited in the void spaces between ferromagnetic particles. Two different sizes of ferromagnetic particles (Dp = 2.5 and 3.5 mm, 35%wt ferrite) were used as filter media. A mathematical model for solid waste collection in the G-MAFB filter was developed to represent the experimental results. A schematic representation of the G-MAFB filtration process is shown in Fig. 6. System boundary (I) represents the region of the experimental apparatus (including holding tank, pump and flow meter) where only the biomass waste particles are present. It is assumed that in this volume the fluid is very well mixed and hence the biomass concentration is uniform. System boundary (II) is the section of our system where the filtration process takes place.
The material balance in both system boundaries can be written in the form of partial-differential equations in the axially symmetric filter bed as follows:

System boundaryðIÞ :

FC
ð | Þ-
L; t | FC
ð0; tÞ¼ V tank

oCð0; tÞ
ot | ; | ð2Þ

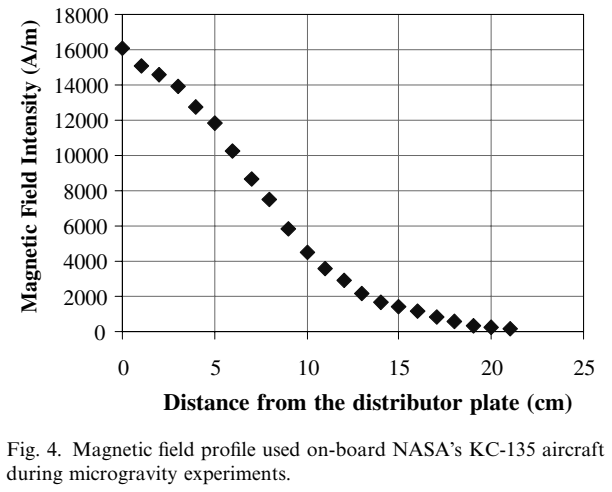
[picture p264: figure]
Magnetic Field Intensity (A/m); during microgravity experiments.

Distance from the distributor plate (cm)

Fig. 4. Magnetic field profile used on-board NASAs KC-135 aircraft

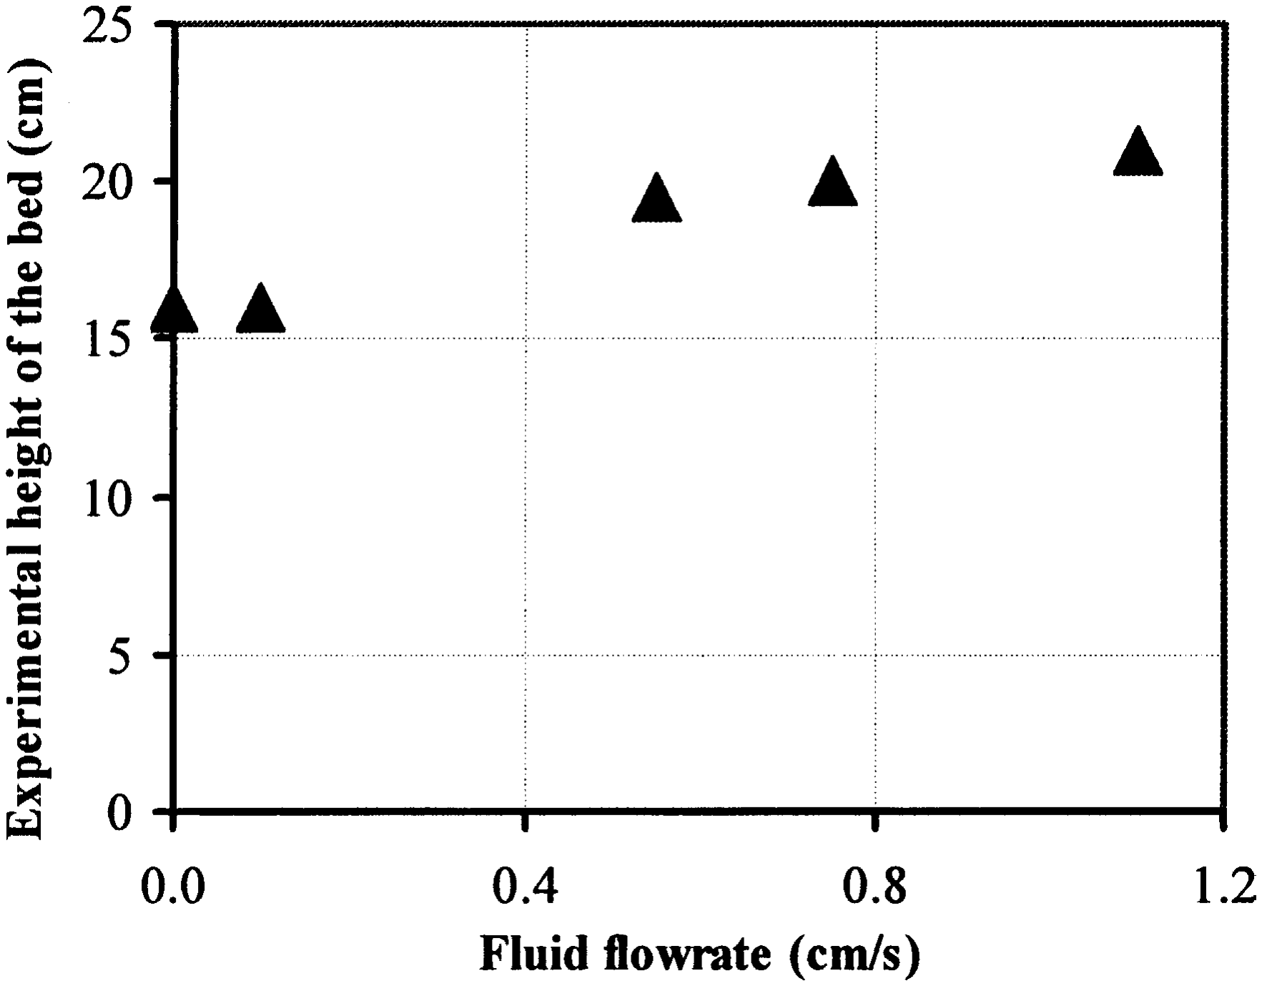
[picture p265: figure]

Fig. 5. Height of the bed at different flow rates in the G-MAFB microgravity experiments on-board NASAs KC-135 aircraft, L0 = 16 cm.

1496 | T. Sornchamni et al. / Advances in Space Research 34 (2004) 1494–1498

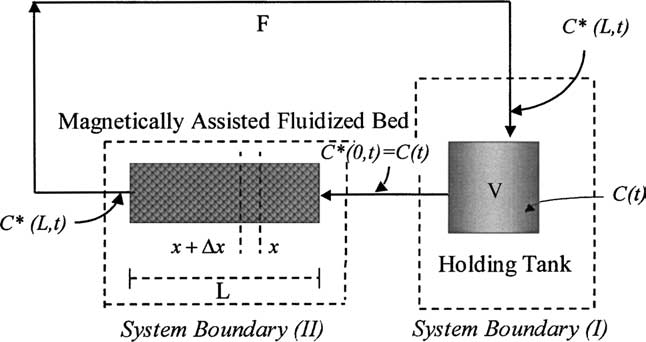
[picture p266: figure]

Initial conditions : C
ð0; 0Þ¼ C0;

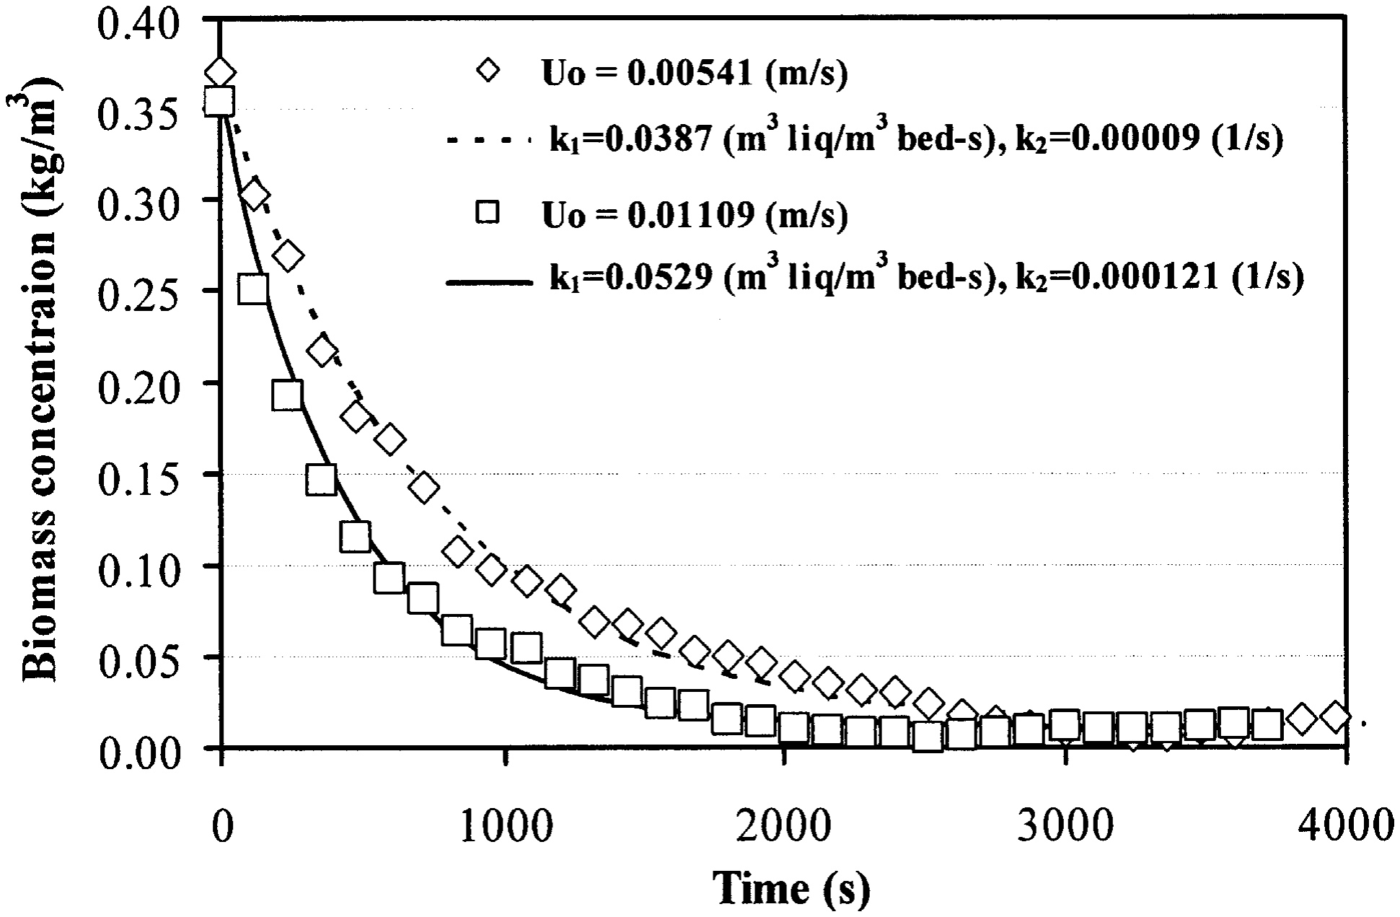
[picture p267: figure]

System boundaryðIIÞ :

U0

oC
ðÞ x; t
ox -

a⁰ or

ot ¼ o eC ð | Þ ðÞ x; t
ot | ; | ð3Þ
Initial condition | : C
ðx; 0Þ¼ 0; t ¼ 0; 0 < x 6 L; C
ð0; 0Þ¼ C0; t ¼ 0; x ¼ 0;
Boundary conditions : C
ð0;tÞ¼ CðtÞ; t > 0; x ¼ 0;

The rate of filtration : or

ot ¼ k1C | ðx; tÞ
a⁰ | -
k2r; | ð4Þ
Initial conditions : rðx; 0Þ¼ 0; | t ¼ 0; | 0 6 x 6 L;
C
ðx; 0Þ¼ 0; | t ¼ 0; | 0 < x 6 L:

The variation in the nominal diameter of the filtration media as the waste mass is deposited can be expressed as

Dpðx; tÞ¼ Dpðx; 0Þþ rðx; tÞ

qbiomass

: | | ð5Þ

The voidage of the bed, e, at any given time, is given by

eðx; tÞ¼ 1 -

ð1 -e0Þ

D³
pðx; tÞ
D³
pðx; 0Þ
: | | ð6Þ

In the above equations, C(t) is the biomass concentration [kg/m³ liquid] in the holding tank. C* [kg/m³ liquid] and r [kg/m² surface] are the concentration of the biomass particles in the liquid phase and on the media particle surface, respectively. k1 (m³ liquid/m³ bed-s) is the accumulation coefficient and k2 (1/s) is the detachment coefficient. a⁰ is particle surface per unit volume of the bed (m² media surface/m³ bed), F is the flow rate of liquid containing solid waste (m³ liquid/s), t is time (s), U0 is fluid velocity (m/s), Vtank is total volume in the storage tank (m³
) and represents the liquid phase volume fraction of the bed (dimensionless). With the help of Eqs. (5) and (6), Eqs. (2)–(4) are solved numerically, and accumulation and detachment coefficients, k1 and k2, are evaluated using an optimization procedure. Figs. 7 and

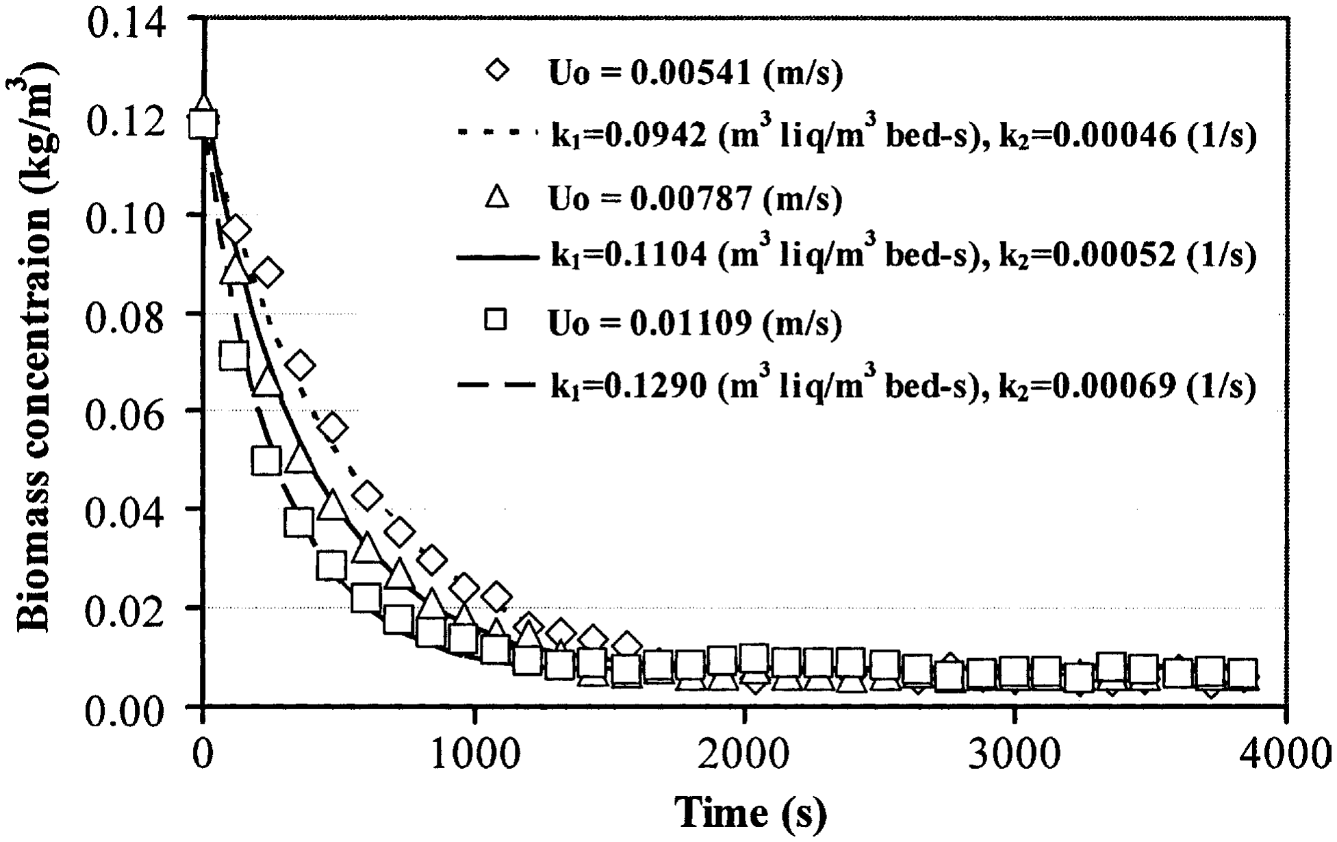
[picture p268: figure]

8 show the filtration results for both sizes of ferromagnetic particles at different fluid flow rates.

4. Conclusion

A novel microgravity and hypogravity compatible engineering platform (G-MAFB), utilizing magnetic force to achieve stable fluidization, has been successfully demonstrated on-board NASAs KC-135 aircraft. Here magnetic forces augment or substitute for the gravitational field. This enabling technology may find many potential areas of application. Filtration experiments conducted in the laboratory have shown that G-MAFB based methods can successfully separate biomass waste particles from a recirculating liquid stream. Within the range of fluid velocity used in the filtration experiments, we found that the rate of filtration increases with the fluid velocity. In future work, this G-MAFB filtering unit will be integrated into a complete solid waste destruction process.

Fig. 7. Change of biomass concentration in the holding tank, Dp = 2.5 mm, and C0 0.12 [kg/m³
], and packed bed condition.

Fig. 8. Change of biomass concentration in the holding tank, Dp = 3.5 mm, and C0 0.35 [kg/m³
], and packed bed condition.

Fig. 6. Schematic diagram of the G-MAFB filtration system.

T. Sornchamni et al. / Advances in Space Research 34 (2004) 1494–1498 | 1497

Acknowledgements

We gratefully acknowledge support from the NASA Reduced Gravity Student Flight Program. This work was funded by the National Aeronautics and Space Administration (NASA) under Grant NAG9-1181. The authors thank John W. Fisher for his advice and support.

References

Atwater, J.E., Akse, J.R., Jovanovic, G.N., Wheeler, R.R., Sornchamni, T. Porous cobalt spheres for high temperature gradient magnetically assisted fluidized beds. Mater. Res. Bull. 28, 395–407, 2003.
Atwater, J.E., Akse, J.R., Jovanovic, G.N., Sornchamni, T. Preparation of metallic cobalt and cobalt- Barium titanate spheres as high temperature media for magnetically stabilized fluidized bed reactors. J. Mater. Sci. Lett. 20 (6), 487–488, 2001.
Jovanovic, G.N., Sornchamni, T., Yoo, S., Atwater, J.E., Akse, J.R., DeHart, J.L., Fisher, J.W. Magnetically assisted gasification of solid waste. In: Presented at 29th International Conference on Environmental Systems, Denver, Colorado, USA, Paper 1999-01-2183, 1999.
Rosensweig, R.E. Magnetic stabilization of the state of uniform fluidization. Ind. Eng. Chem. Fund. 18 (3), 260–269, 1979. Sornchamni, T. Magnetically assisted liquid–solid fluidization in a gradient magnetic field: theory and application, Ph.D. Thesis, Oregon State University, Corvallis, OR, USA, 2004.
1498 | T. Sornchamni et al. / Advances in Space Research 34 (2004) 1494–1498
