JakCrane/FYP/latex/report_assets/COSMOS_SETUP.png

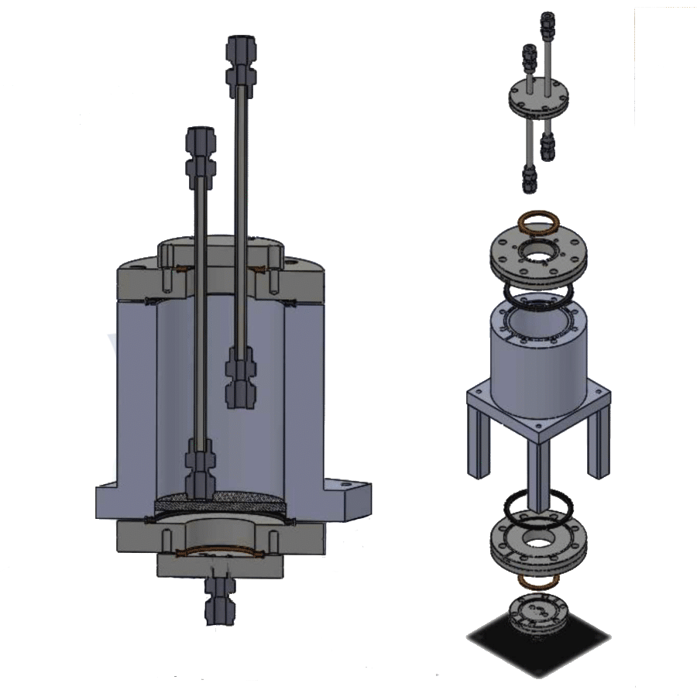
latex/report_assets/COSMOS_SETUP.png
