JakCrane/FYP/latex/report_assets/drawio_setup.png

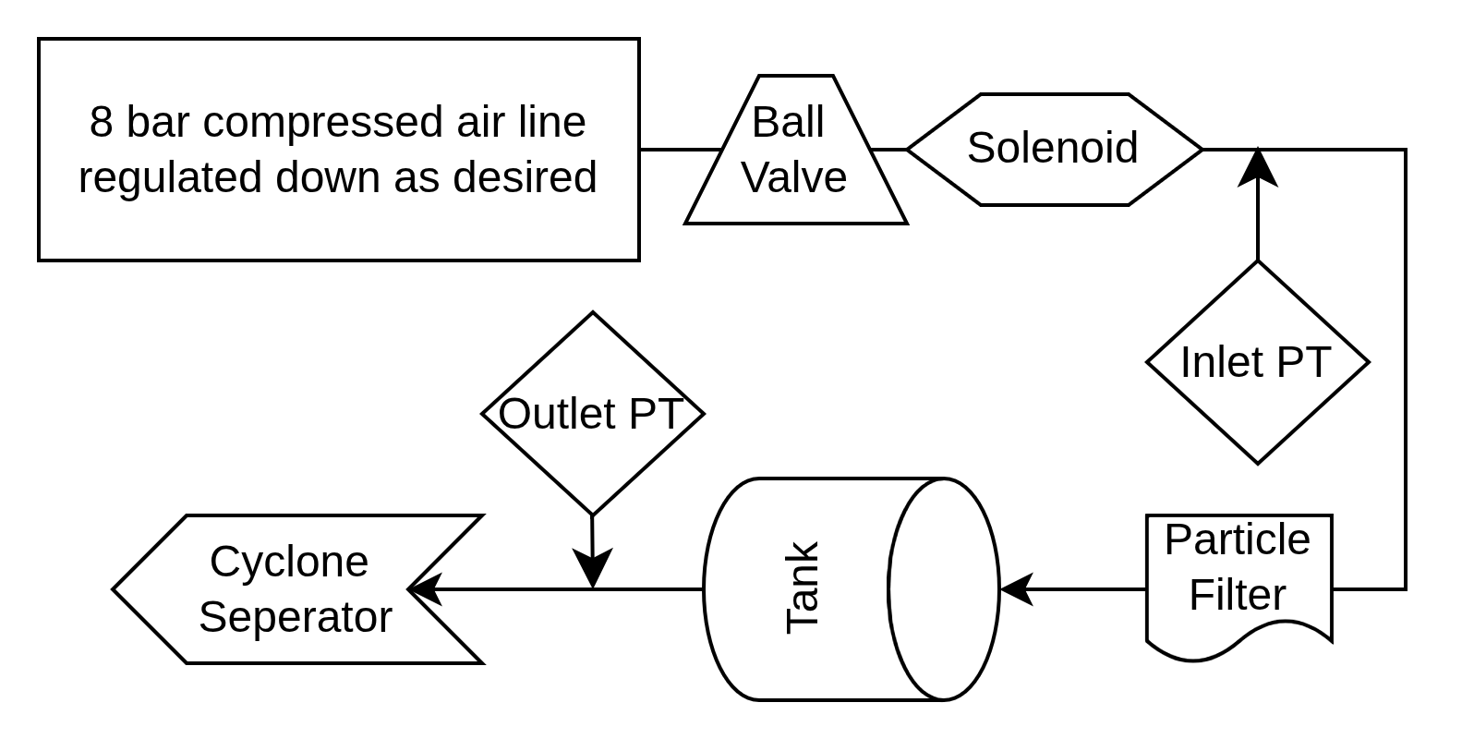
latex/report_assets/drawio_setup.png
