JakCrane/FYP/latex/report_assets/nasa_3d_printer.png

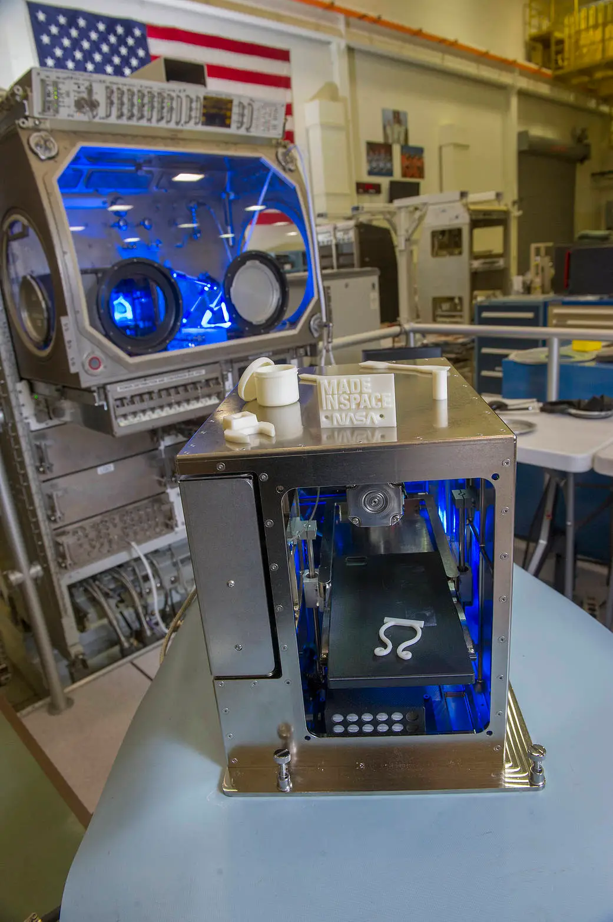
latex/report_assets/nasa_3d_printer.png
