JakCrane/FYP/Research_Files/May/failed_tests_data/20250529_190814.503557Z_kermit106.csv

BackendTime | ch0sens | ch1sens | ch2sens | ch3sens | ch4sens | ch5sens | ch6sens | ch7sens | ch8sens | ch9sens | ch10sens | ch11sens | temp0 | temp1 | temp2 | temp3 | system_status | system_time
1748545698330.1345 | 1.02593195438385 | -0.08620555698871613 | 0.08340830355882645 | -41163.0 | -5180.0 | -7049.0 | -44374.0 | -0.027186032384634018 | -12.942522048950195 | -13.277289390563965 | -13.996554374694824 | -6276.0 | nan | 0.0 | 0.0 | 0.0 | 525313 | 511599
1748545698332.3435 | 1.0265601873397827 | -0.08620728552341461 | 0.08809416741132736 | -41132.0 | -5189.0 | -7096.0 | -44397.0 | -0.029935181140899658 | -12.942069053649902 | -13.27706241607666 | -13.996711730957031 | -6258.0 | nan | 0.0 | 0.0 | 0.0 | 525313 | 511611
1748545698334.266 | 1.026371717453003 | -0.08620481193065643 | 0.06810116022825241 | -41202.0 | -5204.0 | -7081.0 | -44375.0 | -0.021687733009457588 | -12.942487716674805 | -13.277690887451172 | -13.996415138244629 | -6264.0 | nan | 0.0 | 0.0 | 0.0 | 525313 | 511620
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
