JakCrane/FYP/Research_Files/May/failed_tests_data/20250529_190814.504394Z_kermit108.csv

BackendTime | ch0sens | ch1sens | ch2sens | ch3sens | ch4sens | ch5sens | ch6sens | ch7sens | ch8sens | ch9sens | ch10sens | ch11sens | temp0 | temp1 | temp2 | temp3 | system_status | system_time
1748545698305.626 | 1.0400278568267822 | 1.0401315689086914 | -9162.0 | -8862.0 | -7614.0 | 290.0 | -42555.0 | 0.26347801089286804 | -42113.0 | -41282.0 | -40270.0 | -6765.0 | 0.0 | nan | nan | nan | 524289 | 3824
1748545698308.8218 | 1.0400065183639526 | 1.0401372909545898 | -9188.0 | -8845.0 | -7648.0 | 323.0 | -42544.0 | 0.25877800583839417 | -42099.0 | -41296.0 | -40292.0 | -6785.0 | 0.0 | nan | nan | nan | 524289 | 3828
1748545698315.825 | 1.0400454998016357 | 1.0400521755218506 | -9192.0 | -8877.0 | -7621.0 | 312.0 | -42536.0 | 0.2665192186832428 | -42117.0 | -41292.0 | -40281.0 | -6777.0 | 0.0 | nan | nan | nan | 524289 | 3834
1748545698318.9275 | 1.0400220155715942 | 1.0400464534759521 | -9218.0 | -8871.0 | -7584.0 | 327.0 | -42566.0 | 0.27121925354003906 | -42119.0 | -41303.0 | -40285.0 | -6756.0 | 0.0 | nan | nan | nan | 524289 | 3838
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
