JakCrane/FYP/Research_Files/May/failed_tests_data/20250530_152142.757490Z_kermit106.csv

BackendTime | ch0sens | ch1sens | ch2sens | ch3sens | ch4sens | ch5sens | ch6sens | ch7sens | ch8sens | ch9sens | ch10sens | ch11sens | temp0 | temp1 | temp2 | temp3 | system_status | system_time
1748618506613.7168 | 1.0342618227005005 | -0.08620481193065643 | 0.6813240051269531 | -41264.0 | -5192.0 | -8087.0 | -44493.0 | 1.6033649444580078 | -12.94477367401123 | -13.279662132263184 | -13.999102592468262 | -6645.0 | nan | nan | nan | nan | 524289 | 15255
1748618506616.3923 | 1.0321204662322998 | -0.08620332926511765 | 0.6875718235969543 | -41303.0 | -5193.0 | -8063.0 | -44499.0 | 1.6067249774932861 | -12.944512367248535 | -13.280168533325195 | -13.998631477355957 | -6625.0 | nan | nan | nan | nan | 524289 | 15268
1748618506620.2253 | 1.0312094688415527 | -0.08620450645685196 | 0.6841355562210083 | -41293.0 | -5212.0 | -8079.0 | -44482.0 | 1.602448582649231 | -12.944738388061523 | -13.279767036437988 | -13.99856185913086 | -6676.0 | nan | nan | nan | nan | 524289 | 15280
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
