JakCrane/FYP/Research_Files/May/failed_tests_data/20250530_152142.757792Z_kermit108.csv

BackendTime | ch0sens | ch1sens | ch2sens | ch3sens | ch4sens | ch5sens | ch6sens | ch7sens | ch8sens | ch9sens | ch10sens | ch11sens | temp0 | temp1 | temp2 | temp3 | system_status | system_time
1748618506568.2305 | 1.0401662588119507 | 1.0402146577835083 | -9150.0 | -9404.0 | -8821.0 | 291.0 | -42565.0 | 0.3121371269226074 | -42113.0 | -41282.0 | -40205.0 | -7148.0 | 0.0 | nan | nan | nan | 524289 | 3825
1748618506572.418 | 1.0400688648223877 | 1.040263056755066 | -9210.0 | -9390.0 | -8806.0 | 344.0 | -42566.0 | 0.3038429617881775 | -42127.0 | -41304.0 | -40251.0 | -7127.0 | 0.0 | nan | nan | nan | 524289 | 3830
1748618506576.3882 | 1.040140986442566 | 1.0402069091796875 | -9161.0 | -9351.0 | -8894.0 | 321.0 | -42539.0 | 0.30467239022254944 | -42105.0 | -41302.0 | -40245.0 | -7129.0 | 0.0 | nan | nan | nan | 524289 | 3834
1748618506579.037 | 1.0402110815048218 | 1.0402437448501587 | -9162.0 | -9400.0 | -9038.0 | 372.0 | -42543.0 | 0.305501788854599 | -42127.0 | -41257.0 | -40269.0 | -7076.0 | 0.0 | nan | nan | nan | 524289 | 3837
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
