JakCrane/FYP/Research_Files/May/failed_tests_data/20250530_154124.863220Z_kermit106.csv

BackendTime | ch0sens | ch1sens | ch2sens | ch3sens | ch4sens | ch5sens | ch6sens | ch7sens | ch8sens | ch9sens | ch10sens | ch11sens | temp0 | temp1 | temp2 | temp3 | system_status | system_time
1748619715725.5012 | 1.0145549774169922 | -0.08620394766330719 | 0.8165891766548157 | -41086.0 | -5165.0 | -6857.0 | -44338.0 | 1.8119947910308838 | -12.94144058227539 | -13.276433944702148 | -13.9950532913208 | -5989.0 | nan | 0.0 | 0.0 | 0.0 | 524289 | 8617
1748619715728.0938 | 1.0159738063812256 | -0.0862058624625206 | 0.824398934841156 | -41083.0 | -5120.0 | -6872.0 | -44349.0 | 1.802220106124878 | -12.941527366638184 | -13.275997161865234 | -13.99550724029541 | -6011.0 | nan | 0.0 | 0.0 | 0.0 | 524289 | 8629
1748619715730.2383 | 1.016701579093933 | -0.08620376139879227 | 0.8234617710113525 | -41067.0 | -5140.0 | -6948.0 | -44368.0 | 1.8000818490982056 | -12.94144058227539 | -13.276433944702148 | -13.995454788208008 | -6033.0 | nan | 0.0 | 0.0 | 0.0 | 524289 | 8639
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
