JakCrane/FYP/Research_Files/May/failed_tests_data/20250530_154124.863618Z_kermit108.csv

BackendTime | ch0sens | ch1sens | ch2sens | ch3sens | ch4sens | ch5sens | ch6sens | ch7sens | ch8sens | ch9sens | ch10sens | ch11sens | temp0 | temp1 | temp2 | temp3 | system_status | system_time
1748619715703.058 | 1.0404762029647827 | 1.0402146577835083 | -8989.0 | -8858.0 | -7266.0 | 304.0 | -42367.0 | 0.3386784493923187 | -41950.0 | -41114.0 | -40113.0 | -6674.0 | 0.0 | nan | nan | nan | 524289 | 3825
1748619715706.2102 | 1.0404040813446045 | 1.0402263402938843 | -9000.0 | -8839.0 | -7277.0 | 299.0 | -42380.0 | 0.3439314365386963 | -41931.0 | -41118.0 | -40131.0 | -6675.0 | 0.0 | nan | nan | nan | 524289 | 3830
1748619715709.3599 | 1.0404586791992188 | 1.0401315689086914 | -8993.0 | -8860.0 | -7274.0 | 302.0 | -42410.0 | 0.3309372365474701 | -41928.0 | -41129.0 | -40093.0 | -6652.0 | 0.0 | nan | nan | nan | 524289 | 3834
1748619715711.4575 | 1.0403904914855957 | 1.0401238203048706 | -9048.0 | -8837.0 | -7315.0 | 255.0 | -42408.0 | 0.3320431411266327 | -41937.0 | -41119.0 | -40132.0 | -6651.0 | 0.0 | nan | nan | nan | 524289 | 3837
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
