JakCrane/FYP/Research_Files/May/filter_test/after.png

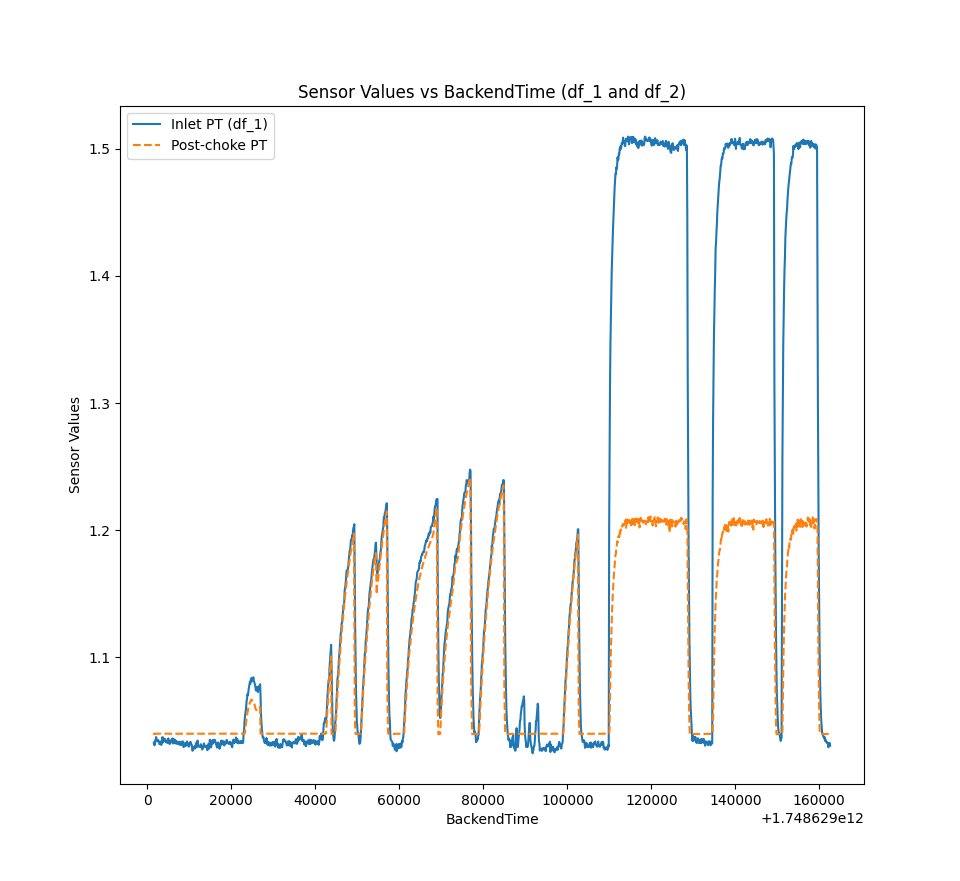
Research_Files/May/filter_test/after.png
