JakCrane/FYP/Research_Files/May/filter_test/before.png

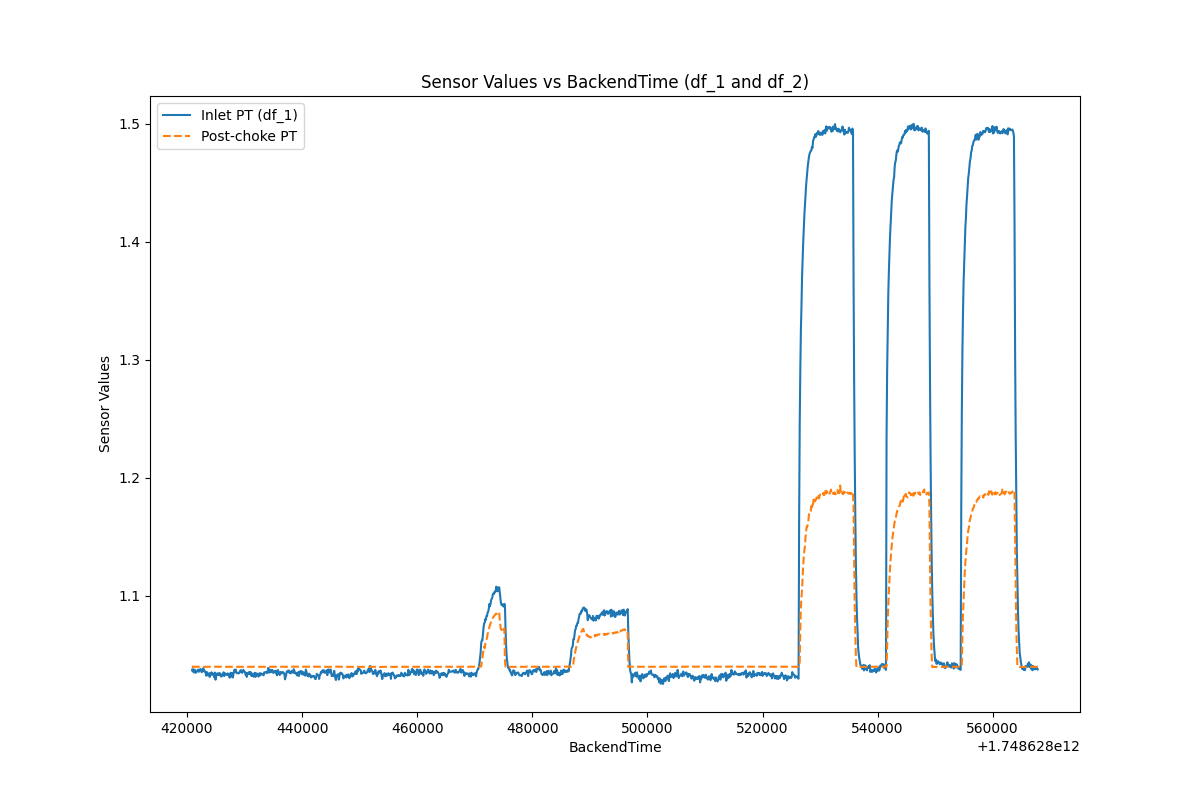
Research_Files/May/filter_test/before.png
