JakCrane/FYP/Research_Files/February/CAD_Files/Delrin_funnel.pdf

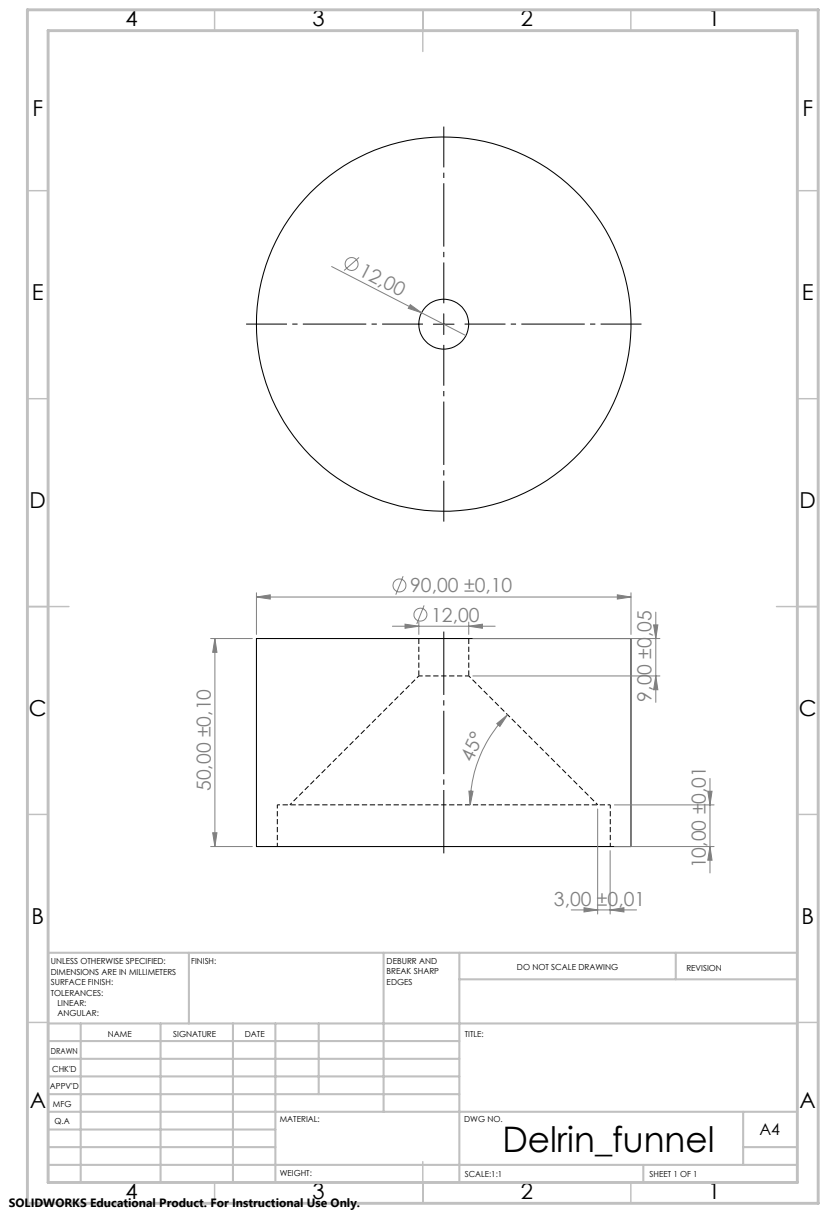
[picture p353: page 1]
SCALE:1:1; SHEET 1 OF 1

UNLESS OTHERWISE SPECIFIED: DIMENSIONS ARE IN MILLIMETERS SURFACE FINISH: TOLERANCES: LINEAR: ANGULAR: | FINISH: | DEBURR AND BREAK SHARP EDGES | DO NOT SCALE DRAWING | REVISION

NAME | SIGNATURE | DATE | | | | TITLE:

DRAWN
CHK'D
APPV'D
MFG
Q.A | | | | MATERIAL: | DWG NO. Delrin_funnel | A4

SOLIDWORKS Educational Product. For Instructional Use Only.
