JakCrane/FYP/(commit log)

2024-12-08 pushing so i can combine the cad files into the repo
2025-01-19 Push before 3d simming the fluidising bed
2025-01-19 oops missed my files so repushing
    [2D_Geometry_of_assembly_for_learning.DXF, 2D_Geometry_of_assembly_for_learning.SLDPRT, Hopper_Tank_Assembly - Hopper_Tank_Funnel-1.STL, Hopper_Tank_Assembly - Hopper_Tank_Tube-1.STL, Hopper_Tank_Assembly.SLDASM, Hopper_Tank_Assembly.STEP, Hopper_Tank_Bottom_Cap.SLDPRT, Hopper_Tank_End_Cap.SLDPRT]
2025-01-26 pushing to keep correlated with other laptop
    [Hopper_from_mesh_upwards.SLDPRT, Hopper_from_mesh_upwards.x_t]
2025-02-04 push after short meeting with ajit
    [Hopper_Tank_Assembly.SLDASM, Hopper_Tank_End_Cap.SLDPRT, Hopper_Tank_Funnel.SLDPRT, Hopper_Tank_Head_Connector.SLDPRT, Hopper_Tank_Plunger_Head.SLDPRT, Hopper_Tank_Tie_Rod.SLDPRT, Hopper_Tank_Tube.SLDPRT, Plunger_Assembly.STEP]
2025-02-09 pushing before simming the piston p drop
2025-02-10 for review
    [Hopper_Gear_Plunger.SLDPRT, Simulation_Assembly1.SLDASM, gear_plunger.SLDPRT]
2025-02-11 commit to start working on P&ID
    [Hopper_Gear_Plunger.SLDPRT, Hopper_Tank_Assembly.SLDASM, Hopper_Tank_End_Cap.SLDPRT, Hopper_Tank_Funnel.SLDPRT, Hopper_Tank_Tie_Rod.SLDPRT, Hopper_Tank_Tube.SLDPRT]
2025-04-10 committ before figuring out cyclone, after updating bom
    [Acrylic_tube.SLDPRT, Base_bracket.SLDPRT, Base_bracket.STL, Bottom_bracket.SLDPRT, Bottom_bracket.STL, Choke_Point.SLDDRW, Choke_Point.SLDPRT, Choke_Point.STL]
2025-04-27 push to start drafting report
    [Cyclone.SLDASM, Cyclone_base.SLDPRT, Cyclone_base.STL, Cyclone_seperator.SLDPRT, Cyclone_seperator.STL, Cyclone_top.SLDPRT, Cyclone_top.STL]
2025-05-17 windows laptop sims push
    [Choke_Point_05.SLDPRT, Choke_Point_05.STEP, Choke_Point_10.SLDPRT, Choke_Point_10.STEP, Choke_Point_20.SLDPRT, Choke_Point_20.STEP, Cyclone.SLDASM, Cyclone_base.SLDPRT]
2025-05-24 still troubleshooting fsi
    [New_.SLDPRT, New_Piston.SLDPRT, New_Piston.STEP, New_Piston_handle.SLDPRT, New_Piston_handle.STEP, Part1.SLDPRT]
2025-05-26 post laptop scare commit
    [kermit106_1.csv, kermit106_1_raw.csv, kermit106_2.csv, kermit106_2_raw.csv, kermit106_3.csv, kermit106_3_raw.csv, kermit106_4.csv, kermit106_4_raw.csv]
2025-05-26 pre-charge laptop
    [kermit106_7.csv, kermit106_8.csv, kermit106_8_raw.csv, kermit108_8.csv, kermit108_8_raw.csv]
2025-05-26 end of day push
    [kermit106_3.csv]
2025-05-27 post testing of inlet total pressure
    [kermit106_9.csv, kermit106_9_raw.csv, kermit108_9.csv, kermit108_9_raw.csv]
2025-05-29 images from cad
    [dowty.SLDPRT, new_piston.SLDPRT, new_piston.STEP, oring_again.SLDPRT, piston_support_back.SLDPRT, piston_support_back.STEP, piston_support_front.SLDPRT, piston_support_front.STEP]
2025-05-29 testing friction
    [kermit106_10.csv, kermit106_10_raw.csv, kermit106_11.csv, kermit106_11_raw.csv, kermit106_12.csv, kermit106_12_raw.csv, kermit106_13.csv, kermit106_13_raw.csv]
2025-06-01 testing data
    [1_kermit106.csv, 1_kermit108.csv, 20250529_190814.503557Z_kermit106.csv, 20250529_190814.504394Z_kermit108.csv, 20250530_152142.757490Z_kermit106.csv, 20250530_152142.757792Z_kermit108.csv, 20250530_154124.863220Z_kermit106.csv, 20250530_154124.863618Z_kermit108.csv]
2025-06-01 successful test full data 3 bar 2
    [22_kermit106.csv, 22_kermit108.csv, 23_kermit106.csv, 23_kermit108.csv, 2_expl_kermit106.csv, 2_expl_kermit108.csv]
2025-06-01 5th success
    [1_kermit106.csv, 1_kermit108.csv, 21_kermit106.csv, 21_kermit108.csv, 22_kermit106.csv, 22_kermit108.csv, 23_kermit106.csv, 23_kermit108.csv]
2025-06-04 saving analysis
    [22_kermit106_clean.csv, 22_kermit108_clean.csv, 23_kermit106_clean.csv, 23_kermit108_clean.csv, 24_kermit106_clean.csv, 24_kermit108_clean.csv]
2025-06-05 safety push
    [1_kermit106_clean.csv, 1_kermit108_clean.csv, 2_kermit106_clean.csv, 2_kermit108_clean.csv, 3_kermit106_clean.csv, 3_kermit108_clean.csv]
2025-06-10 finished piston section
2025-06-12 3rd test
    [20250612_173926.848383Z_kermit106.csv, 20250612_173926.848759Z_kermit108.csv, 2_kermit106.csv, 2_kermit106_clean.csv, 2_kermit108.csv, 2_kermit108_clean.csv]
2025-06-12 final test done
    [3_kermit106.csv, 3_kermit106_clean.csv, 3_kermit108.csv, 3_kermit108_clean.csv, 4_kermit106.csv, 4_kermit108.csv]
2025-06-14 weird charging issue
2025-06-14 battery issues save
2025-06-15 final out transfer hopefully
    [Acrylic_tube.SLDPRT]
